Ultimaker/Ultimaker2/README.md

Ultimaker2
==========

In this repository you will find the documentation and source files for the Ultimaker2 3D printer. If you are missing a part or information of the Electronics feel free to file an issue on github.

Harma Woldhuis Ultimaker Research and Development
