Ultimaker/Ultimaker2/HeadAssembly.step

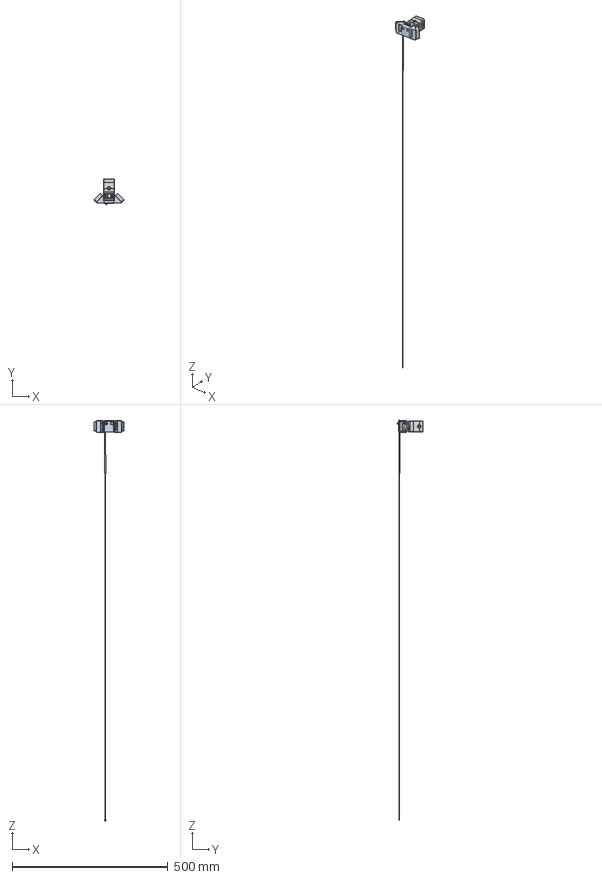
[picture p4: CAD file, 2014-04-07]
HeadAssembly.step
97.7 x 83.5 x 1284.8 mm
1320-B2P-B
1321-B2P-B
1322-B2P-C
1307-Z2P-B Hot End Holder Top
1308-Z2P-B Cooling Rib Hot End
1306-Z2P-B hot end holder bottom
1309-Z2P-B Hot End Isolator Coupler
1310-Z2P-A Hot end Isolator
1301-Z2P-D integrated nozzle 3mm
1268-Z1P-A
1329-B2P-C
1065-Z1P-A x 2
Fan Base 30x30 x 2
Fan Rotor 30x30 x 2
1330 Fan Base 25x25
1330 Fan Rotor 25x25
