Ultimaker/Ultimaker2/1011_Y-linear_shaft_(x2)/1011-A2P-A.STEP

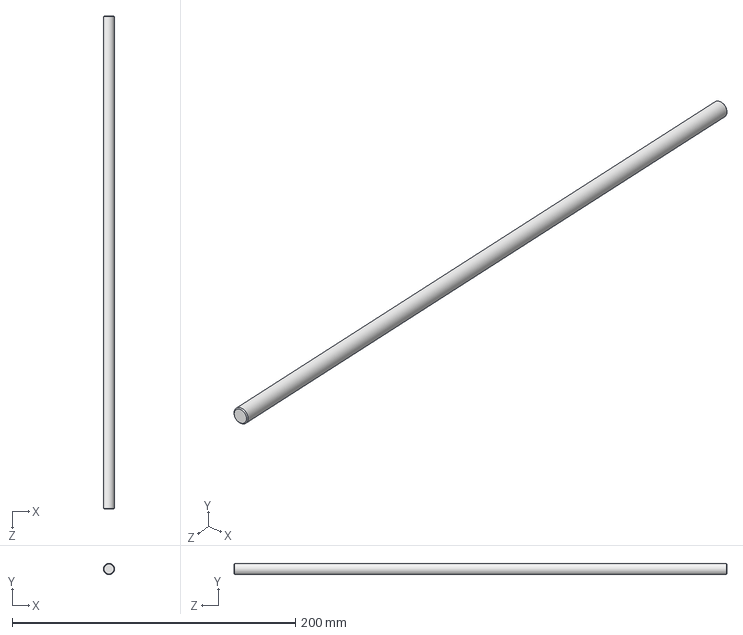
[picture p5: CAD file, 2014-03-27]
1011_Y-linear_shaft_(x2)/1011-A2P-A.STEP
7.99 x 8.00 x 348.0 mm
