Ultimaker/Ultimaker2/1012_X-linear_shaft_(x2)/1012-A2P-A.STEP

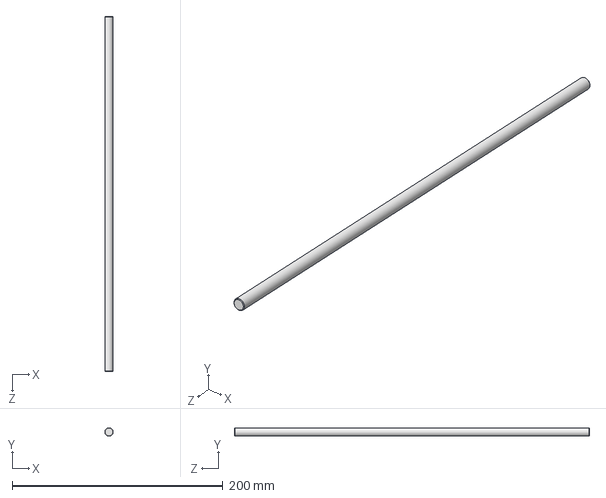
[picture p6: CAD file, 2014-03-27]
1012_X-linear_shaft_(x2)/1012-A2P-A.STEP
7.99 x 8.00 x 337.0 mm
