Ultimaker/Ultimaker2/1021_Ball_Bearing_688-2RS_(x1)/1021-Z1P-A.STEP

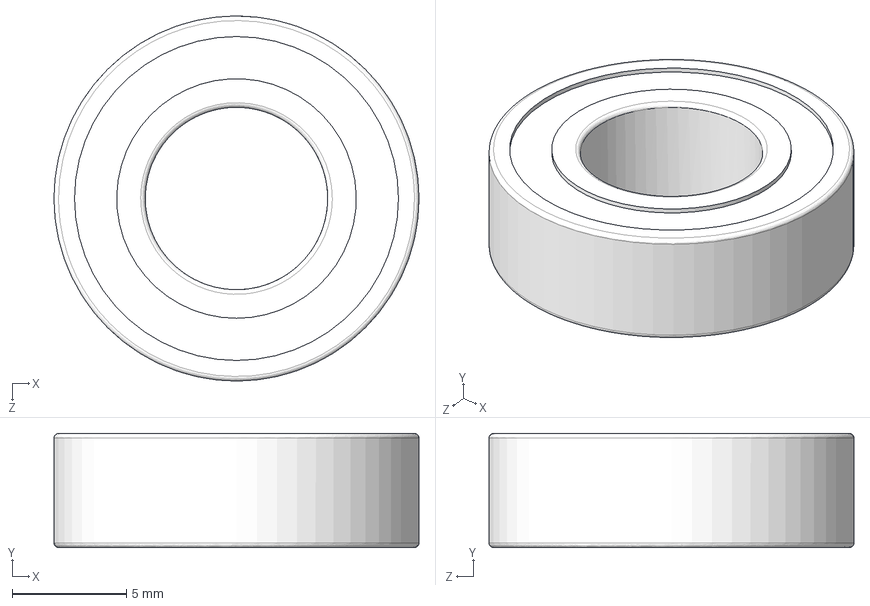
[picture p7: CAD file, 2014-03-27]
1021_Ball_Bearing_688-2RS_(x1)/1021-Z1P-A.STEP
16.0 x 5.00 x 16.0 mm
