Ultimaker/Ultimaker2/1024_Limit_Switch,_Black_Short_Wire_(x1)/1024-Z1P-A.STEP

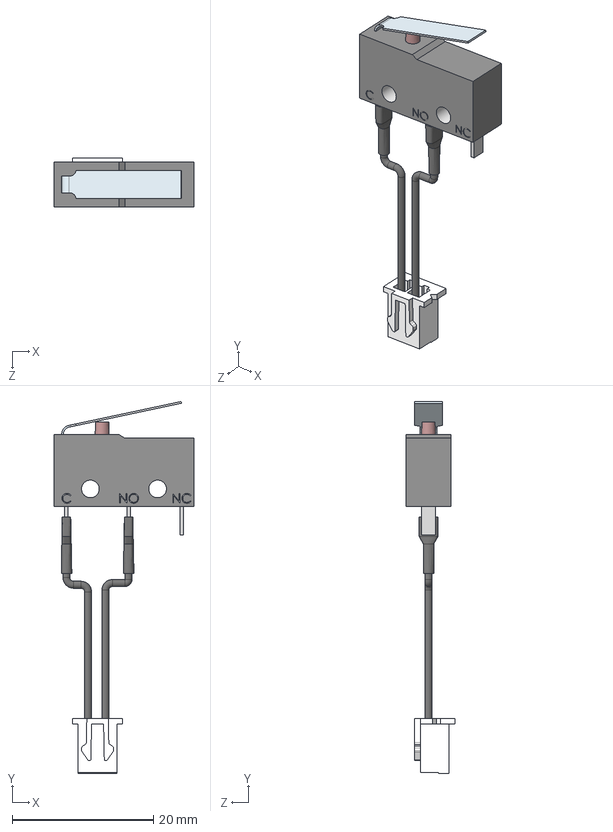
[picture p8: CAD file, 2014-03-27]
1024_Limit_Switch,_Black_Short_Wire_(x1)/1024-Z1P-A.STEP
19.8 x 52.7 x 6.90 mm
