Ultimaker/Ultimaker2/1056_Sintered_Bushing_(x4)/1056-A2P-A.STEP

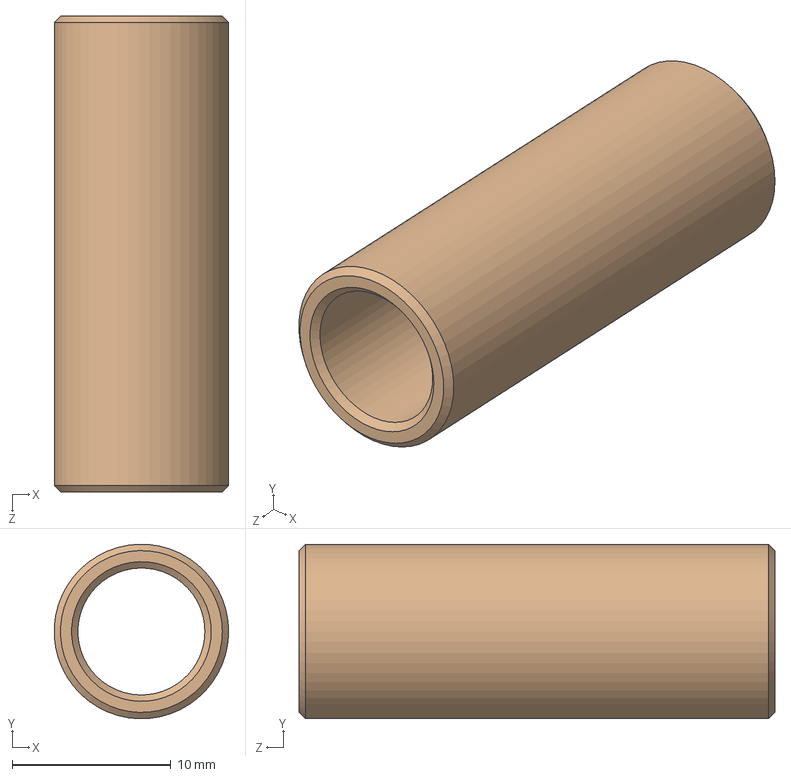
[picture p9: CAD file, 2014-03-27]
1056_Sintered_Bushing_(x4)/1056-A2P-A.STEP
11.0 x 11.0 x 30.0 mm
