Ultimaker/Ultimaker2/1065_Linear_Bearing_LM6LUU_(x2)/1065-Z1P-A.STEP

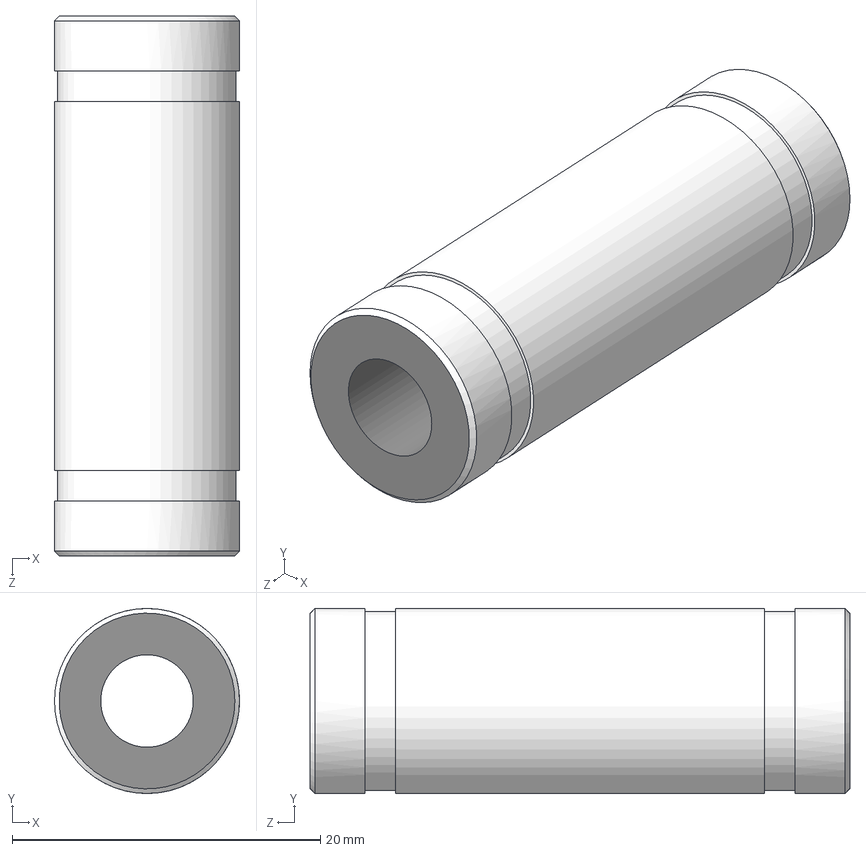
[picture p10: CAD file, 2014-03-27]
1065_Linear_Bearing_LM6LUU_(x2)/1065-Z1P-A.STEP
12.0 x 12.0 x 35.0 mm
