Ultimaker/Ultimaker2/1069_Tube_Coupling_Collet_(x2)/1069-Z1P-A.STEP

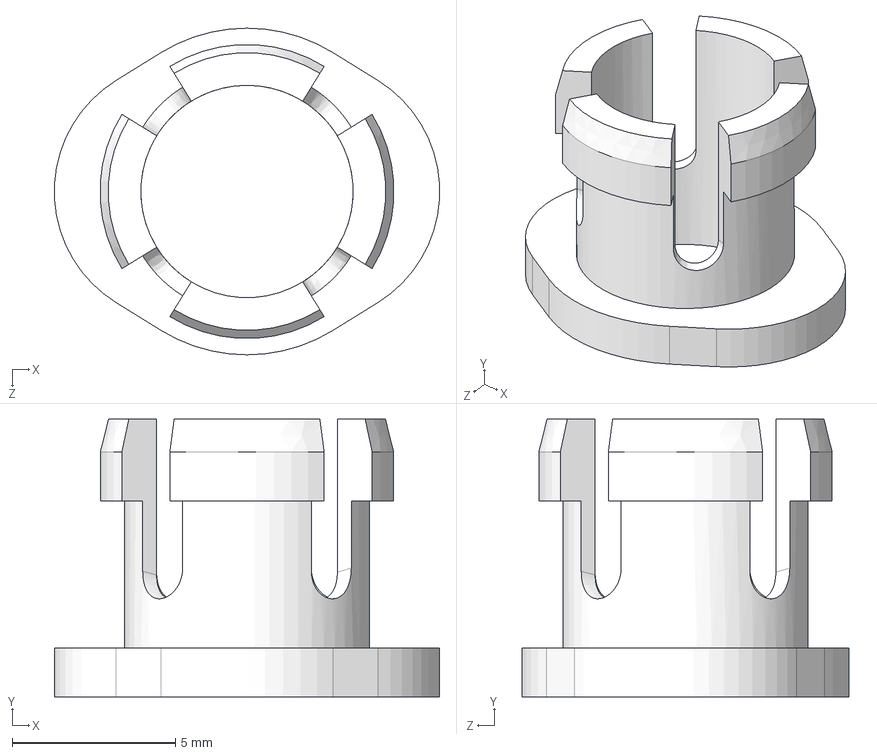
[picture p11: CAD file, 2014-03-27]
1069_Tube_Coupling_Collet_(x2)/1069-Z1P-A.STEP
11.8 x 8.50 x 10.00 mm
