Ultimaker/Ultimaker2/1071_Clamp_Clip_(x2)/1071-Z1P-A.STEP

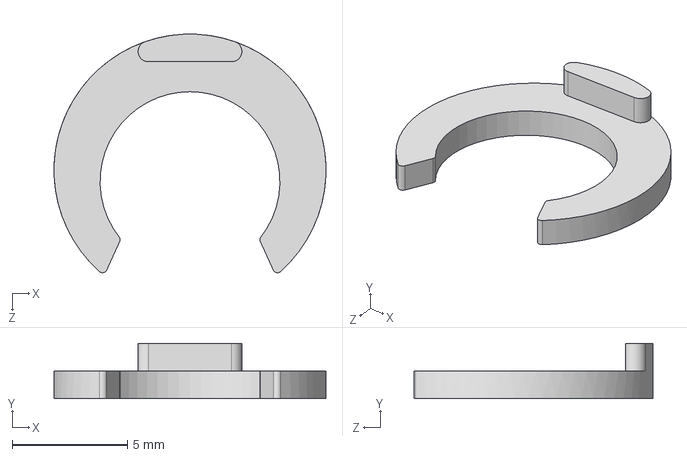
[picture p12: CAD file, 2014-03-27]
1071_Clamp_Clip_(x2)/1071-Z1P-A.STEP
11.8 x 2.40 x 10.3 mm
