Ultimaker/Ultimaker2/1144_USB_Cable_(x1)/1144-Z1P-A.STEP

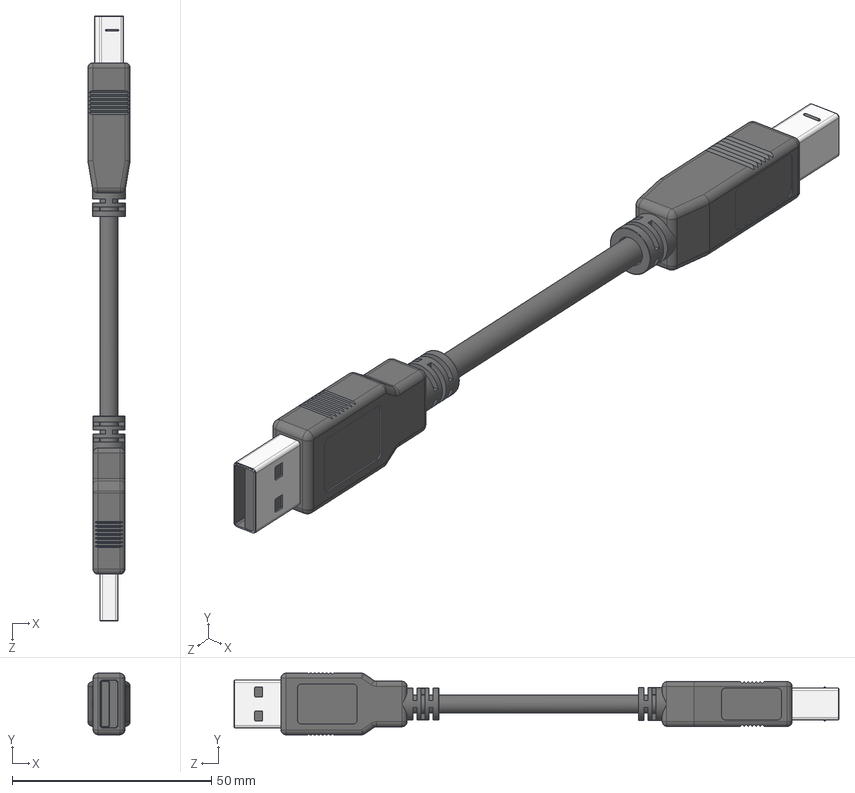
[picture p13: CAD file, 2014-03-27]
1144_USB_Cable_(x1)/1144-Z1P-A.STEP
10.6 x 15.5 x 151.8 mm
