Ultimaker/Ultimaker2/1152_Table_Spring_D2150_(x3)/1152-B2P-B.step

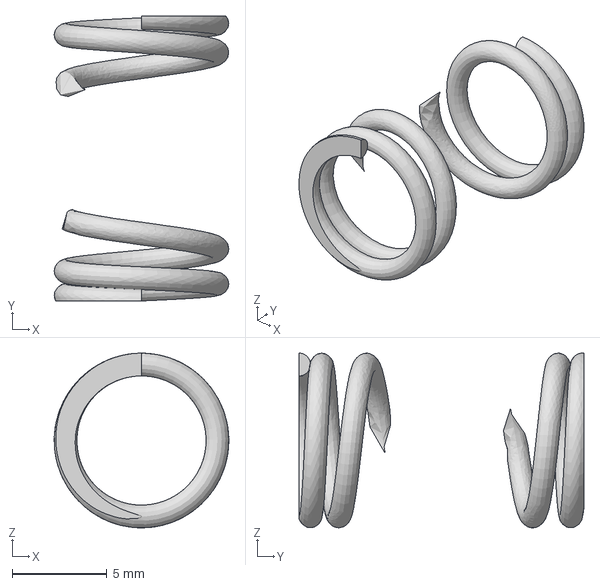
[picture p14: CAD file, 2014-03-27]
1152_Table_Spring_D2150_(x3)/1152-B2P-B.step
9.20 x 15.0 x 9.20 mm
