Ultimaker/Ultimaker2/1153_Print_Table_Base_Plate_(x1)/1153-B2P-B.step

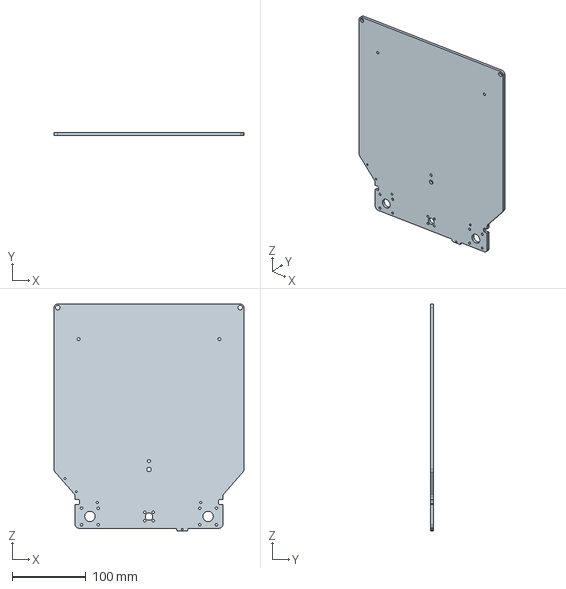
[picture p15: CAD file, 2014-03-27]
1153_Print_Table_Base_Plate_(x1)/1153-B2P-B.step
257.0 x 4.00 x 307.2 mm
