Ultimaker/Ultimaker2/1154_Print_Table_Glass_(x1)/1154-B2P-A.step

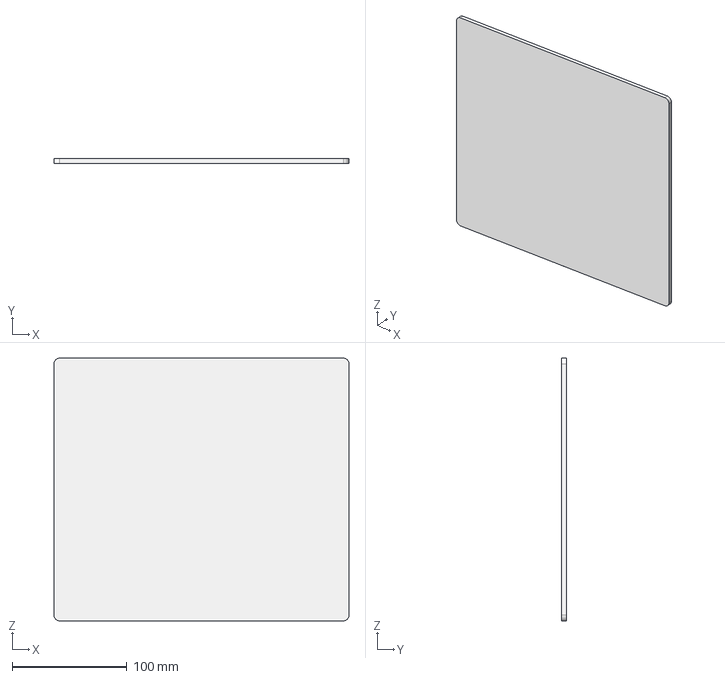
[picture p16: CAD file, 2014-03-27]
1154_Print_Table_Glass_(x1)/1154-B2P-A.step
257.0 x 4.00 x 229.0 mm
