Ultimaker/Ultimaker2/1155_Print_Table_Heated_Bed_(x1)/1155-B2P-B.step

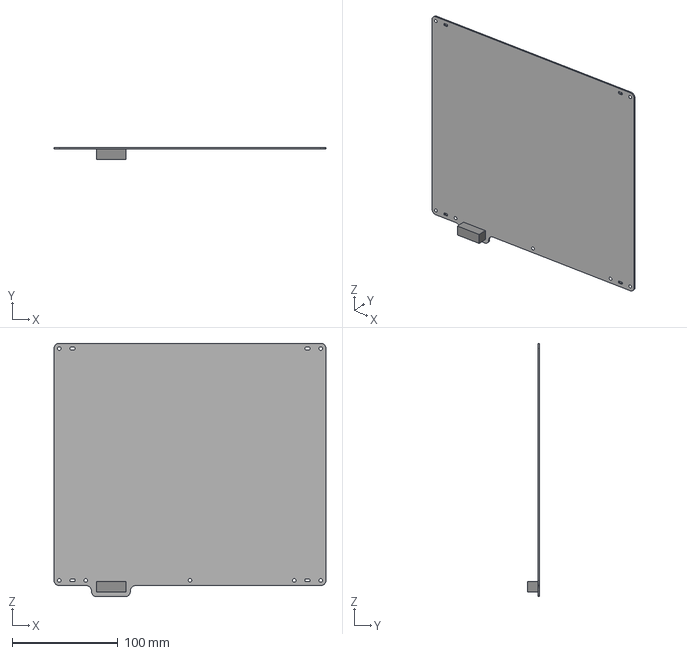
[picture p17: CAD file, 2014-03-27]
1155_Print_Table_Heated_Bed_(x1)/1155-B2P-B.step
257.0 x 11.5 x 239.5 mm
