Ultimaker/Ultimaker2/1156_Z-shaft_Cap_Bottom_(x2)/1156-B2P-A.step

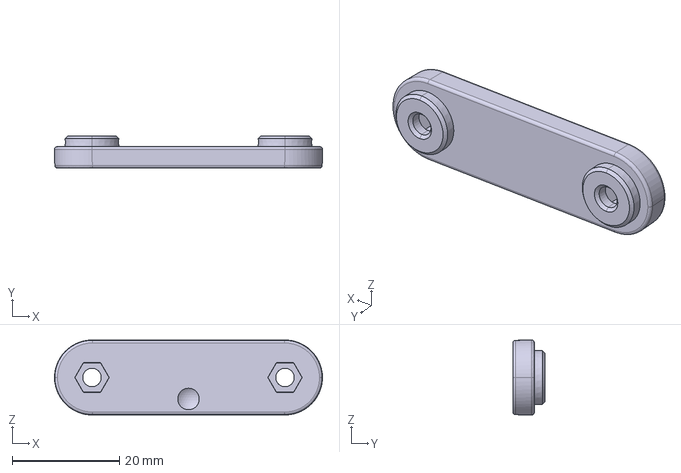
[picture p18: CAD file, 2014-03-27]
1156_Z-shaft_Cap_Bottom_(x2)/1156-B2P-A.step
50.0 x 6.00 x 14.0 mm
