Ultimaker/Ultimaker2/1157_Print_Table_Back_Cover_(x1)/1157-B2P-B.step

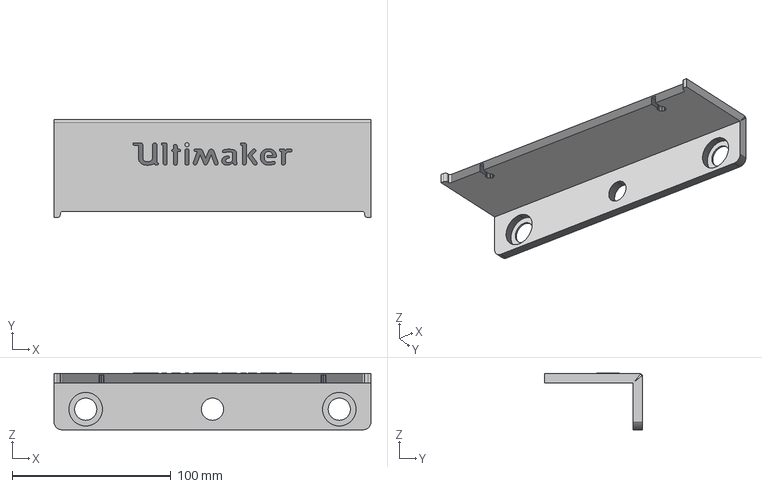
[picture p19: CAD file, 2014-03-27]
1157_Print_Table_Back_Cover_(x1)/1157-B2P-B.step
200.0 x 62.0 x 35.7 mm
