Ultimaker/Ultimaker2/1158_Reel_Holder_(x1)/1158-B2P-A.step

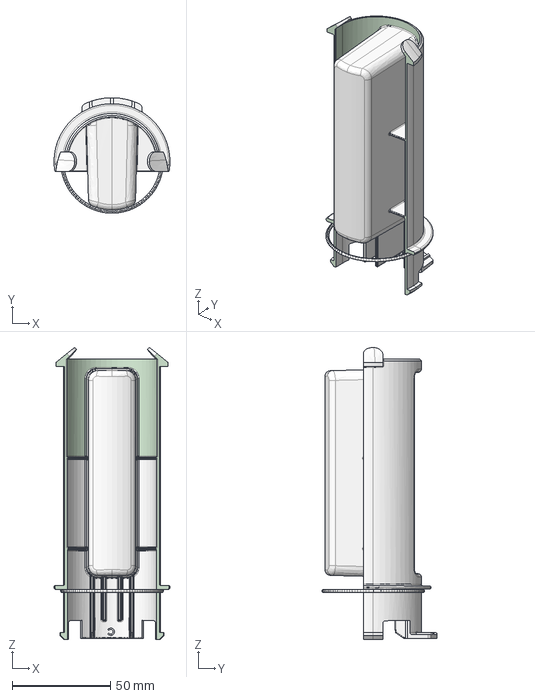
[picture p20: CAD file, 2014-03-27]
1158_Reel_Holder_(x1)/1158-B2P-A.step
59.0 x 58.8 x 148.7 mm
