Ultimaker/Ultimaker2/1159_Z-Motor_with_Trapezoidal_Lead_Srew_(x1)/1159-B2P-D.step

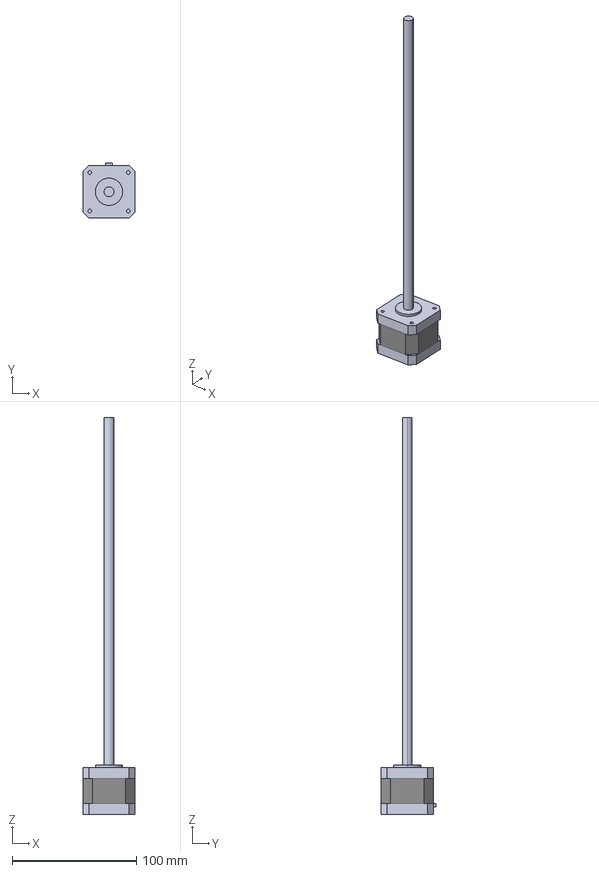
[picture p21: CAD file, 2014-03-27]
1159_Z-Motor_with_Trapezoidal_Lead_Srew_(x1)/1159-B2P-D.step
42.3 x 44.3 x 320.0 mm
