Ultimaker/Ultimaker2/1161_LED_Strip_Cold_white_(x1)/1161-B2P-D.step

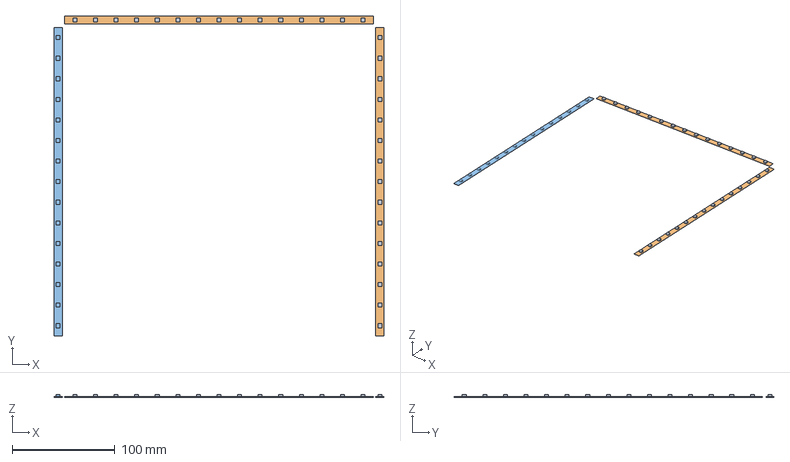
[picture p22: CAD file, 2014-03-27]
1161_LED_Strip_Cold_white_(x1)/1161-B2P-D.step
320.6 x 311.0 x 2.75 mm
