Ultimaker/Ultimaker2/1162_Limit_Switch,_Blue_Wire_(x1)/1162-Z1P-B.step

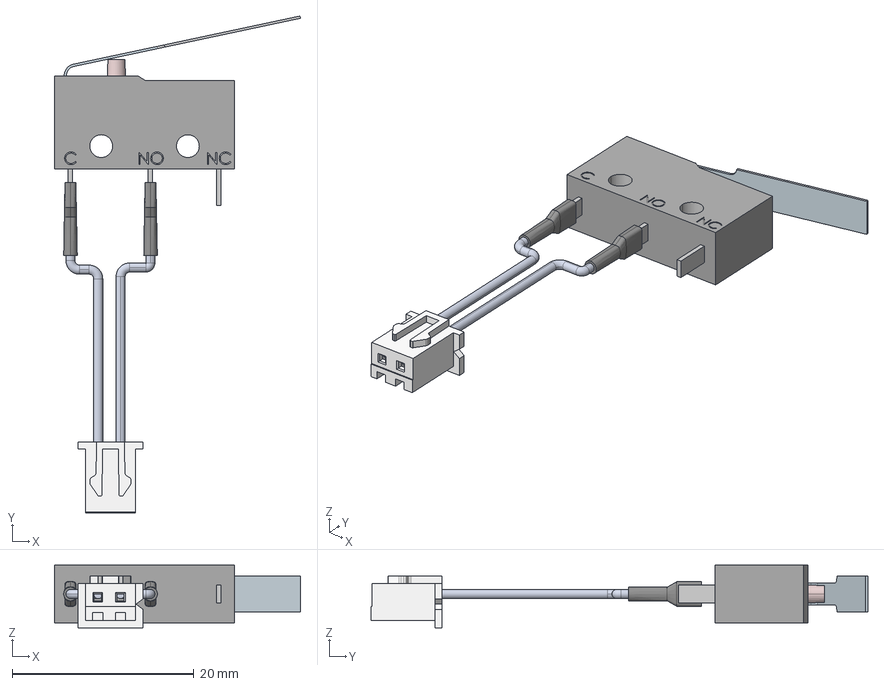
[picture p23: CAD file, 2014-03-27]
1162_Limit_Switch,_Blue_Wire_(x1)/1162-Z1P-B.step
27.1 x 54.6 x 6.90 mm
