Ultimaker/Ultimaker2/1165_Timing_Pulley_5mm_Shaft_GT2_(x2)/1165-B2P-A.step

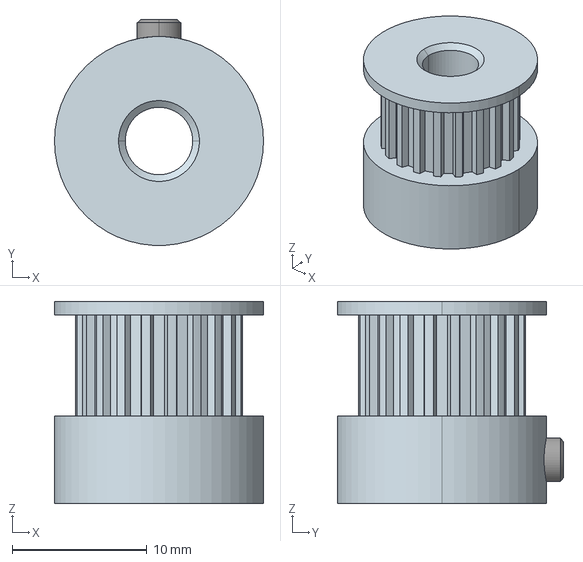
[picture p24: CAD file, 2014-03-27]
1165_Timing_Pulley_5mm_Shaft_GT2_(x2)/1165-B2P-A.step
15.5 x 16.7 x 15.0 mm
