Ultimaker/Ultimaker2/1166_Timing_Pulley_8mm_Shaft_GT2_(x8)/1166-B2P-B.step

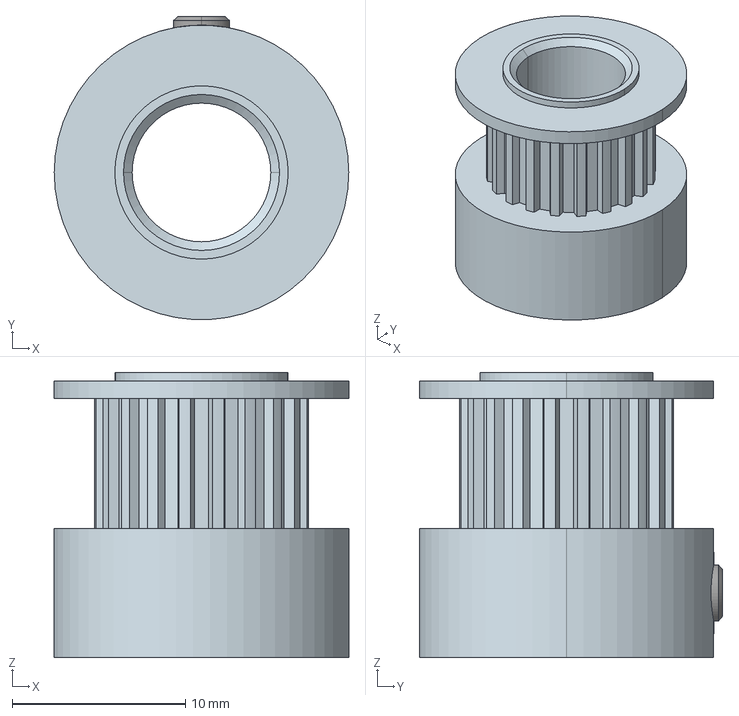
[picture p25: CAD file, 2014-03-27]
1166_Timing_Pulley_8mm_Shaft_GT2_(x8)/1166-B2P-B.step
17.0 x 17.5 x 16.4 mm
