Ultimaker/Ultimaker2/1167_Timing_Pulley_Double_8mm_Shaft_GT2_(x1)/1167-B2P-A.step

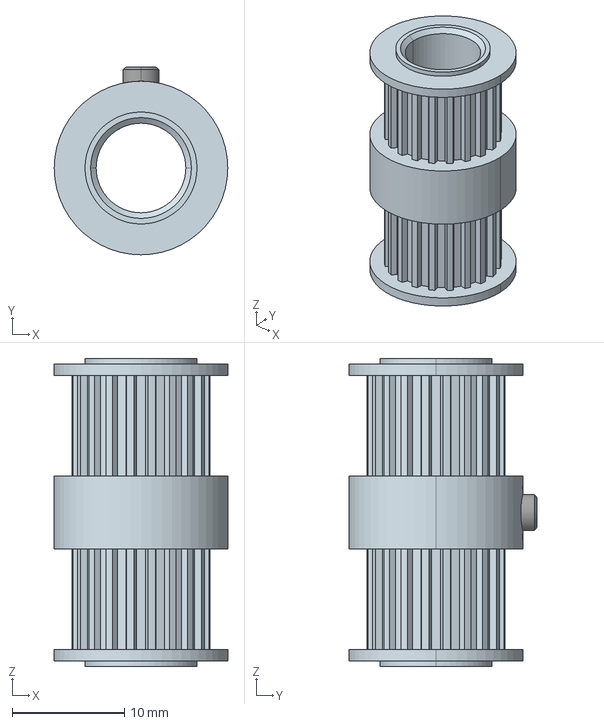
[picture p26: CAD file, 2014-03-27]
1167_Timing_Pulley_Double_8mm_Shaft_GT2_(x1)/1167-B2P-A.step
15.5 x 16.8 x 27.5 mm
