Ultimaker/Ultimaker2/1168_Sliding_Block_Spring_(x4)/1168-B2P-B.step

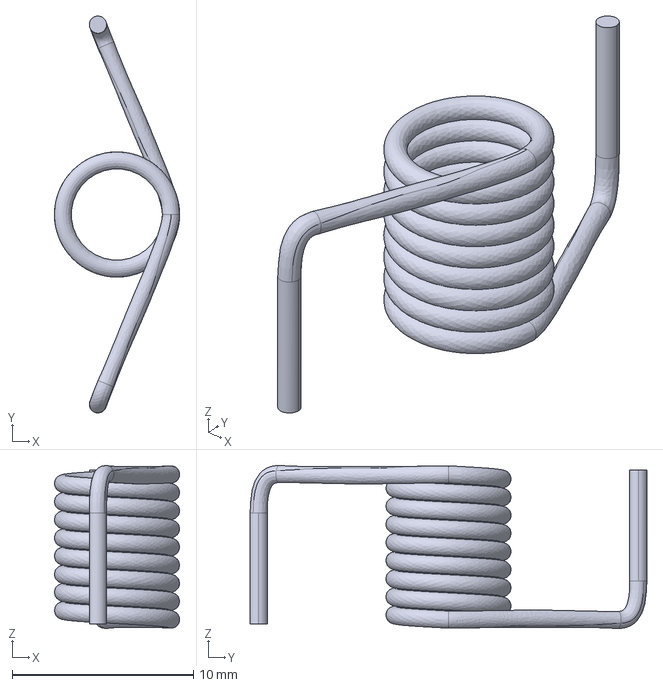
[picture p27: CAD file, 2014-03-27]
1168_Sliding_Block_Spring_(x4)/1168-B2P-B.step
6.91 x 21.9 x 8.98 mm
