Ultimaker/Ultimaker2/1169_Z-linear_Shaft_(x2)/1169-B2P-B.step

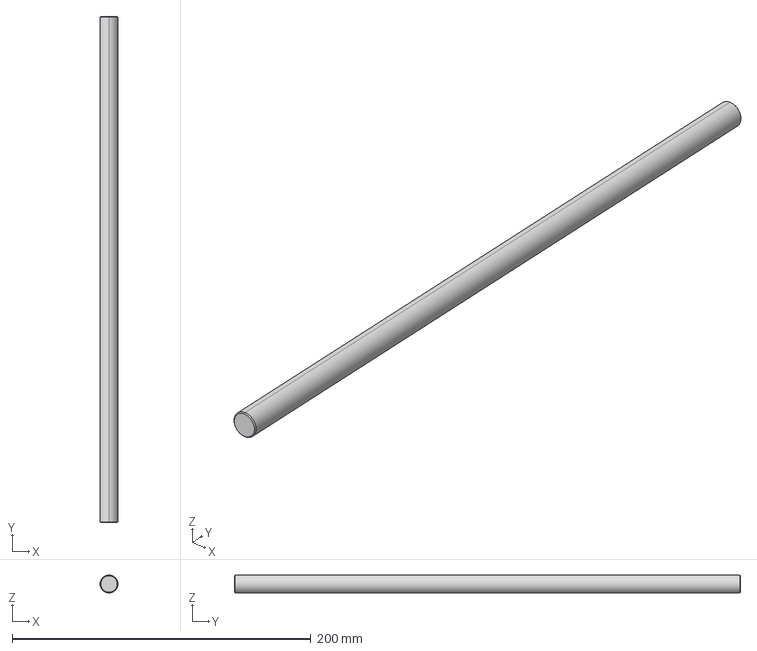
[picture p28: CAD file, 2014-03-27]
1169_Z-linear_Shaft_(x2)/1169-B2P-B.step
12.0 x 339.0 x 12.0 mm
