Ultimaker/Ultimaker2/1170_Square_Flanged_Linear_Bearing_LMK12LUU_(x2)/1170-B2P-B.step

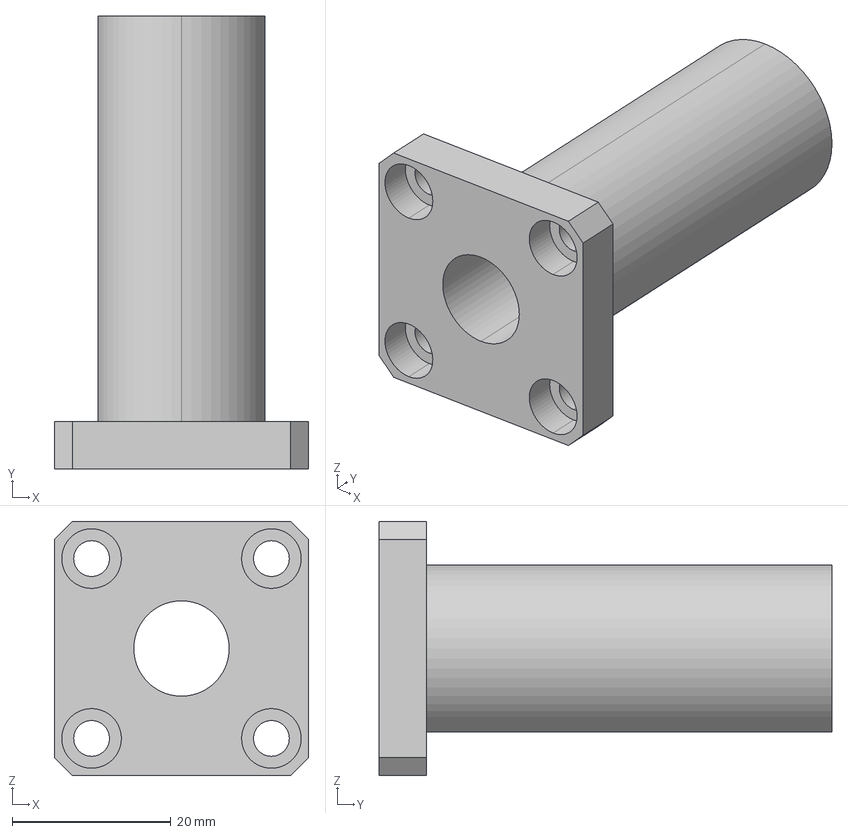
[picture p29: CAD file, 2014-03-27]
1170_Square_Flanged_Linear_Bearing_LMK12LUU_(x2)/1170-B2P-B.step
32.0 x 57.0 x 32.0 mm
