Ultimaker/Ultimaker2/1176_Spacer_8.2x10x5_(x2)/1176-B1P-A.step

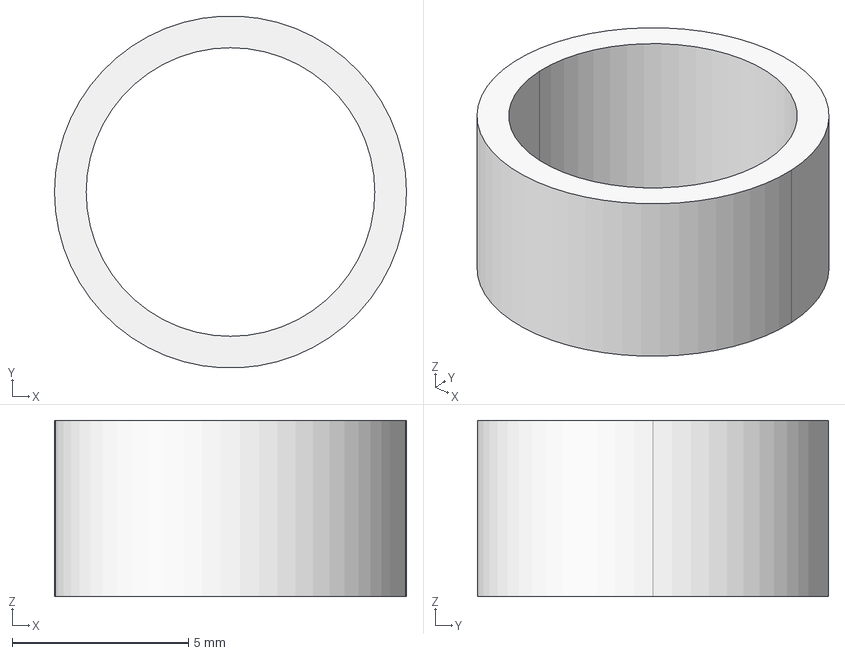
[picture p30: CAD file, 2014-03-27]
1176_Spacer_8.2x10x5_(x2)/1176-B1P-A.step
10.0 x 9.99 x 5.00 mm
