Ultimaker/Ultimaker2/1177_Spacer_8.2x10x10_(x5)/1177-B1P-A.step

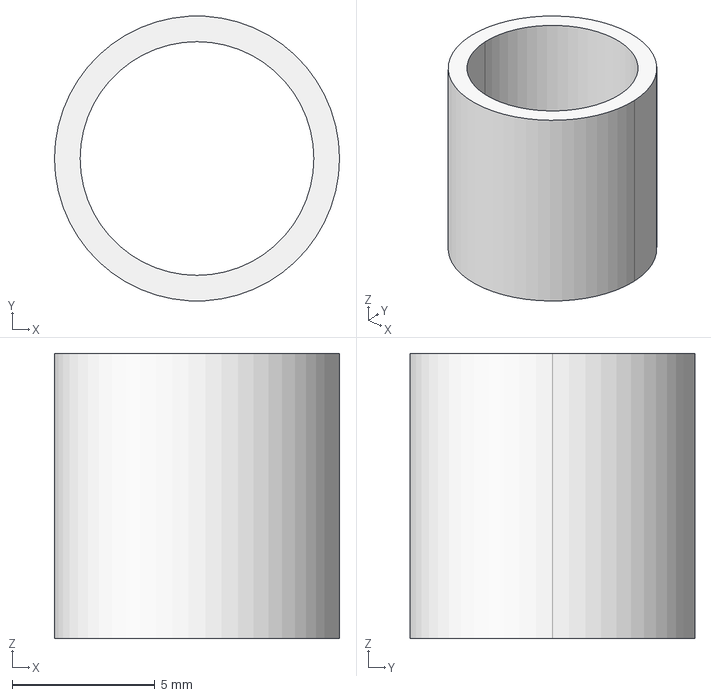
[picture p31: CAD file, 2014-03-27]
1177_Spacer_8.2x10x10_(x5)/1177-B1P-A.step
10.0 x 9.98 x 10.0 mm
