Ultimaker/Ultimaker2/1178_Spacer_8.2x10x25_(x1)/1178-B1P-A.step

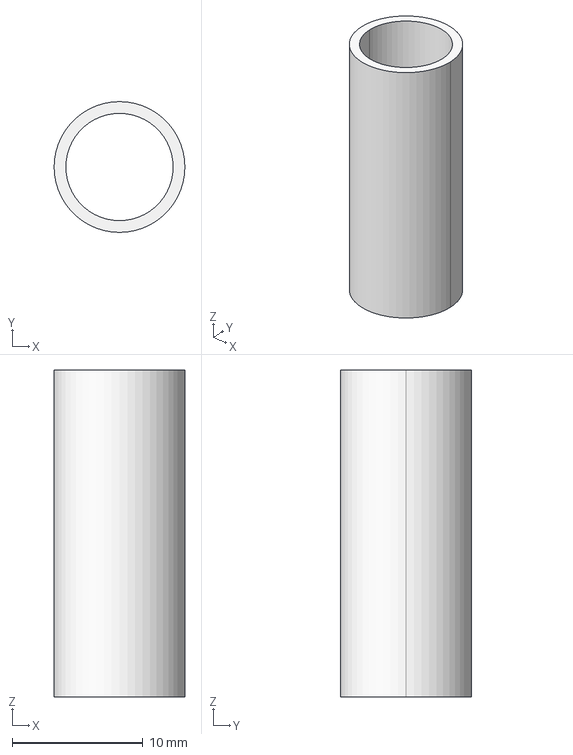
[picture p32: CAD file, 2014-03-27]
1178_Spacer_8.2x10x25_(x1)/1178-B1P-A.step
10.0 x 10.0 x 25.0 mm
