Ultimaker/Ultimaker2/1179_Feeder_Motor_(x1)/1179-B2P-A.step

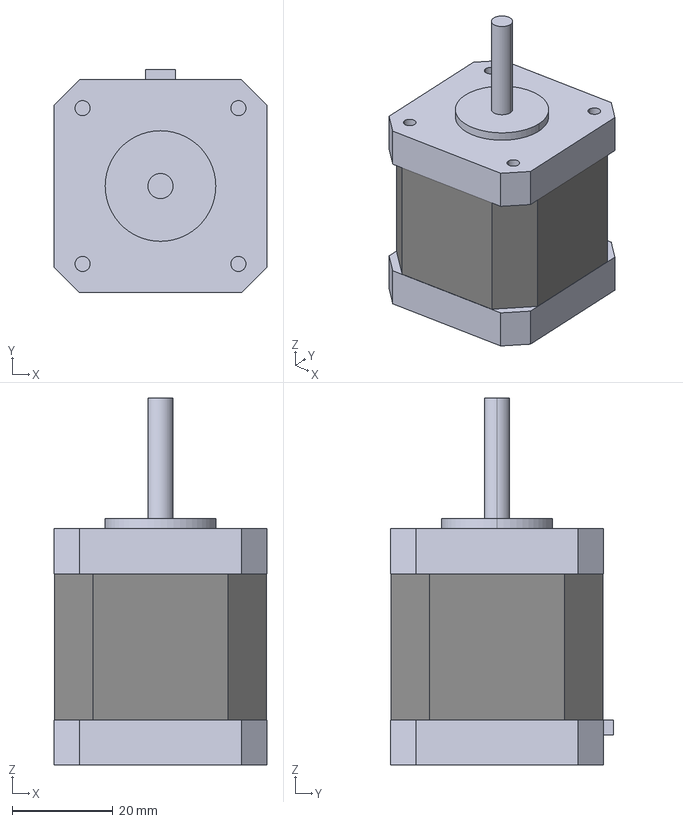
[picture p33: CAD file, 2014-03-27]
1179_Feeder_Motor_(x1)/1179-B2P-A.step
42.3 x 44.3 x 73.0 mm
