Ultimaker/Ultimaker2/1182_X,Y_Motor_(x2)/1182-B2P-A.step

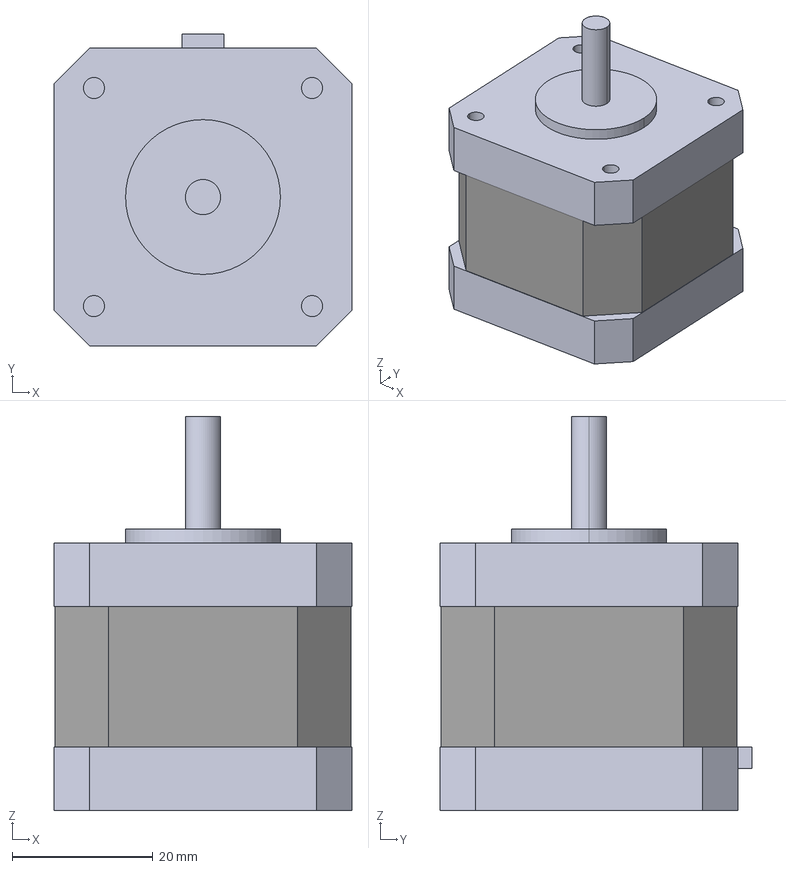
[picture p34: CAD file, 2014-03-27]
1182_X,Y_Motor_(x2)/1182-B2P-A.step
42.3 x 44.3 x 56.0 mm
