Ultimaker/Ultimaker2/1200_ISO_7380_M3x8_(x10)/1200-Z1P-A ISO 7380 M3x8.STEP

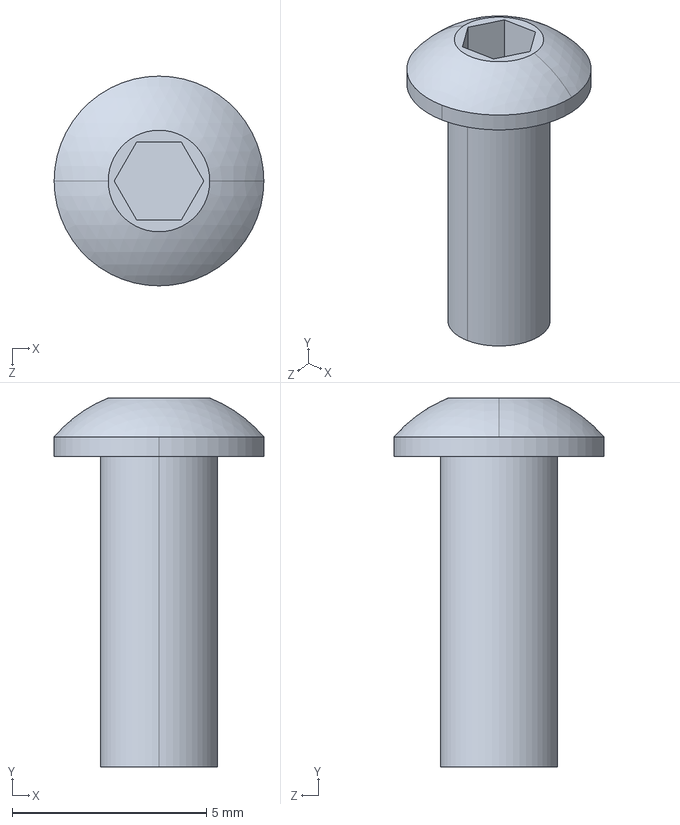
[picture p35: CAD file, 2014-03-27]
1200_ISO_7380_M3x8_(x10)/1200-Z1P-A ISO 7380 M3x8.STEP
5.40 x 9.50 x 5.40 mm
