Ultimaker/Ultimaker2/1202_ISO_7380_M3x10_(x15)/1202-Z1P-A.STEP

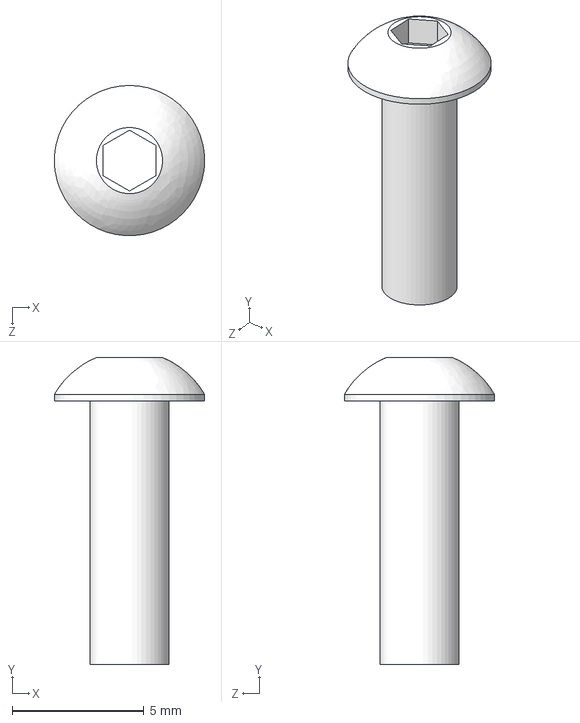
[picture p36: CAD file, 2014-03-27]
1202_ISO_7380_M3x10_(x15)/1202-Z1P-A.STEP
5.70 x 11.7 x 5.69 mm
