Ultimaker/Ultimaker2/1203_ISO_7380_M3x12_(x10)/1203-Z1P-A.STEP

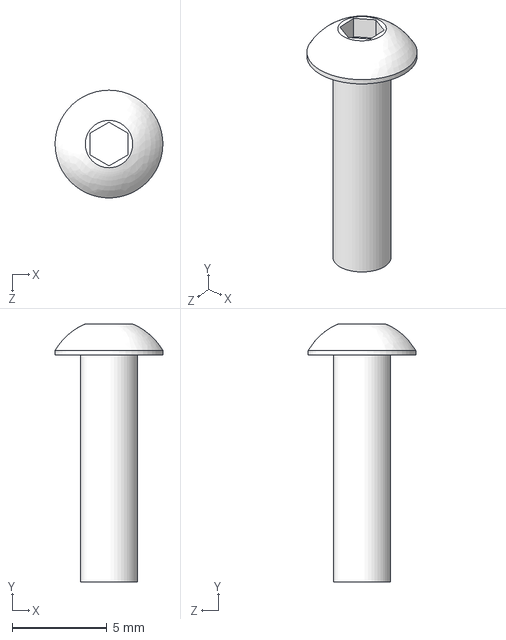
[picture p37: CAD file, 2014-03-27]
1203_ISO_7380_M3x12_(x10)/1203-Z1P-A.STEP
5.70 x 13.7 x 5.69 mm
