Ultimaker/Ultimaker2/1204_ISO_7380_M3x16_(x41)/1204-Z1P-A.STEP

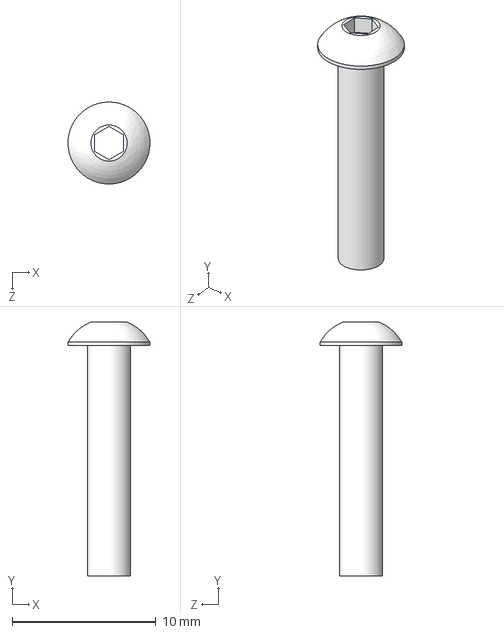
[picture p38: CAD file, 2014-03-27]
1204_ISO_7380_M3x16_(x41)/1204-Z1P-A.STEP
5.70 x 17.7 x 5.69 mm
