Ultimaker/Ultimaker2/1206_ISO_7380_M3x20_(x5)/1206-Z1P-A.STEP

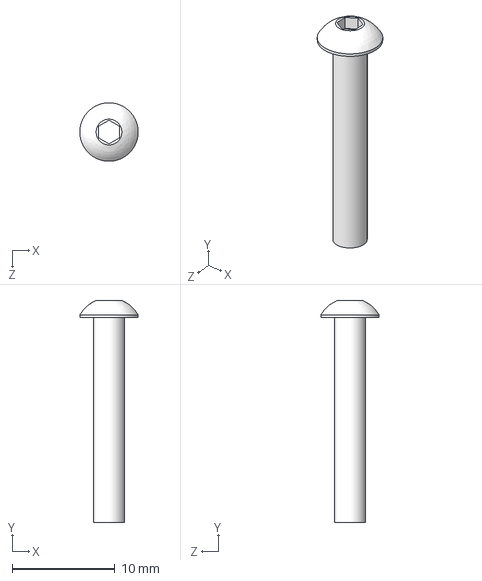
[picture p39: CAD file, 2014-03-27]
1206_ISO_7380_M3x20_(x5)/1206-Z1P-A.STEP
5.70 x 21.7 x 5.69 mm
