Ultimaker/Ultimaker2/1207_ISO_7380_M3x25_(x12)/1207-Z1P-A.STEP

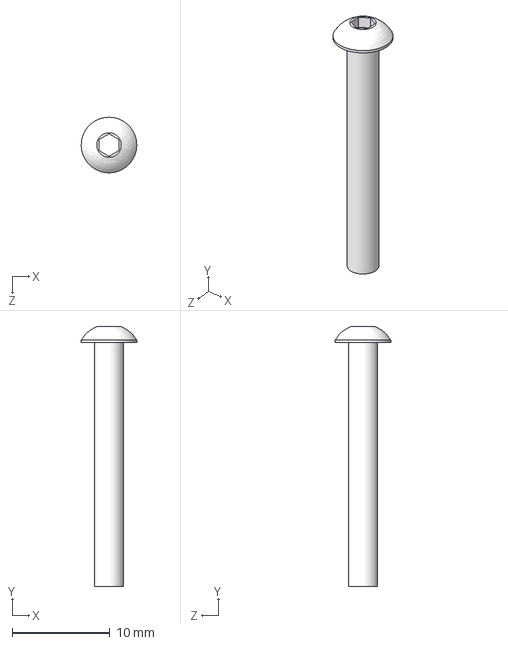
[picture p40: CAD file, 2014-03-27]
1207_ISO_7380_M3x25_(x12)/1207-Z1P-A.STEP
5.70 x 26.6 x 5.69 mm
