Ultimaker/Ultimaker2/1208_ISO_7380_M3x30_(x4)/1208-Z1P-A.STEP

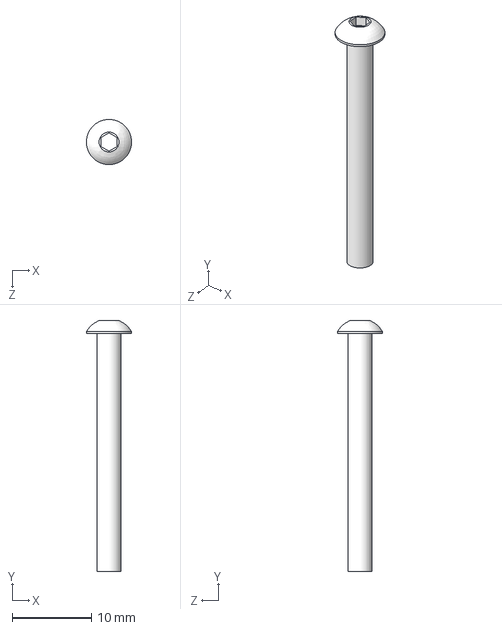
[picture p41: CAD file, 2014-03-27]
1208_ISO_7380_M3x30_(x4)/1208-Z1P-A.STEP
5.70 x 31.7 x 5.69 mm
