Ultimaker/Ultimaker2/1215_ISO_10642_M3x8_A2_(x4)/1215-Z1P-A.step

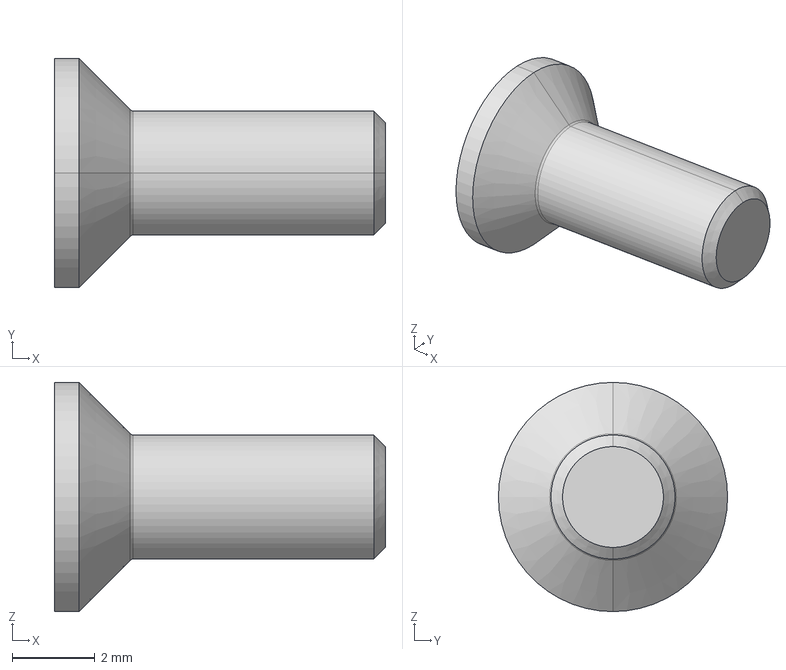
[picture p42: CAD file, 2014-03-27]
1215_ISO_10642_M3x8_A2_(x4)/1215-Z1P-A.step
8.00 x 5.54 x 5.54 mm
