Ultimaker/Ultimaker2/1216_ISO_10642_M3x20_A2_(x3)/1216-Z1P-A.step

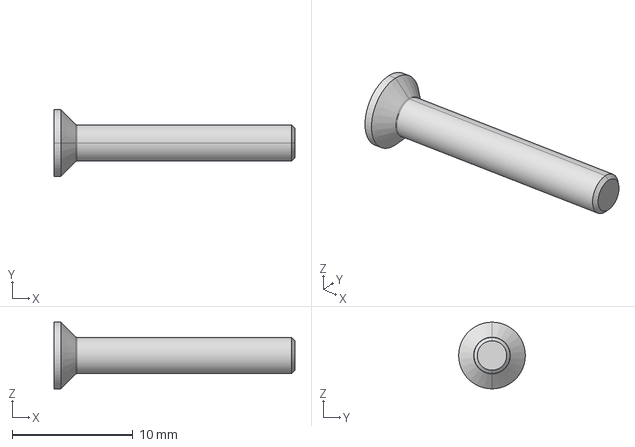
[picture p43: CAD file, 2014-03-27]
1216_ISO_10642_M3x20_A2_(x3)/1216-Z1P-A.step
20.0 x 5.54 x 5.54 mm
