Ultimaker/Ultimaker2/1217_ISO_10642_M4x10_A2_(x8)/1217-Z1P-A.step

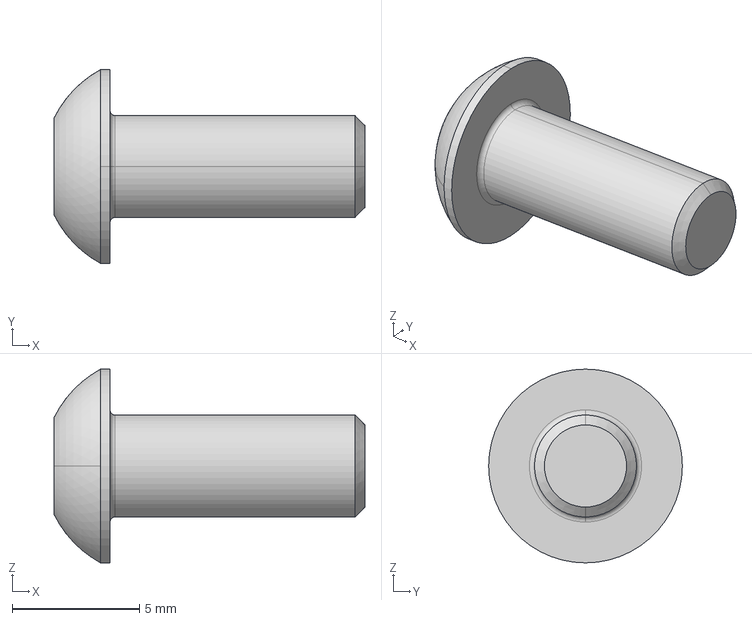
[picture p44: CAD file, 2014-03-27]
1217_ISO_10642_M4x10_A2_(x8)/1217-Z1P-A.step
12.2 x 7.60 x 7.60 mm
