Ultimaker/Ultimaker2/1220_Ball_Bearing_F688-2RS_(x8)/1220-Z1P-A.step

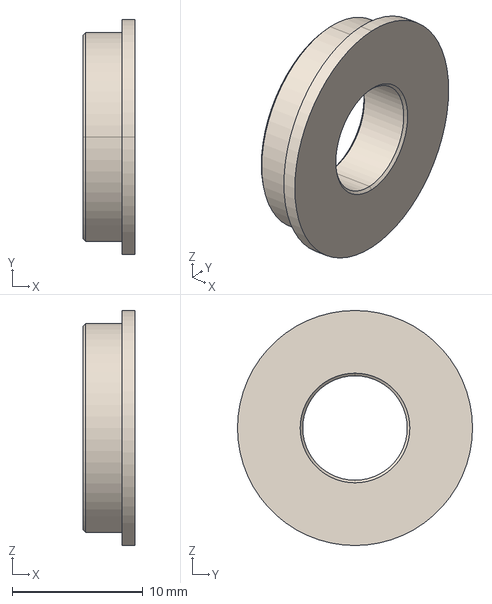
[picture p45: CAD file, 2014-03-27]
1220_Ball_Bearing_F688-2RS_(x8)/1220-Z1P-A.step
4.00 x 18.0 x 18.0 mm
