Ultimaker/Ultimaker2/1226_grease_(x1)/1226-Z1P-A.STEP

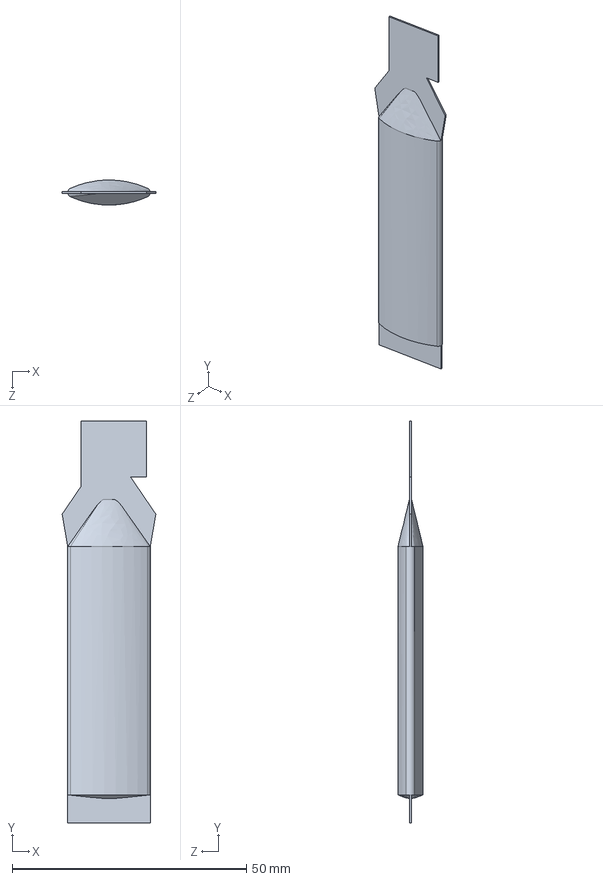
[picture p46: CAD file, 2014-03-27]
1226_grease_(x1)/1226-Z1P-A.STEP
20.0 x 85.8 x 5.34 mm
