Ultimaker/Ultimaker2/1230_Front_Panel_(x1)/1230-B2P-B.STEP

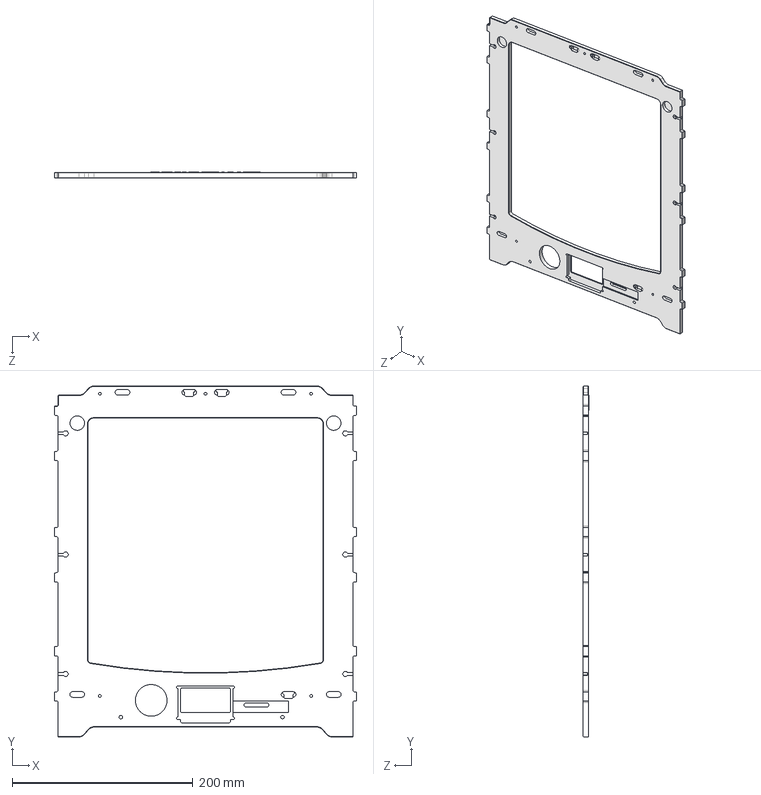
[picture p47: CAD file, 2014-03-27]
1230_Front_Panel_(x1)/1230-B2P-B.STEP
334.2 x 388.0 x 6.20 mm
