Ultimaker/Ultimaker2/1231_Back_Panel_(x1)/1231-B2P-B.STEP

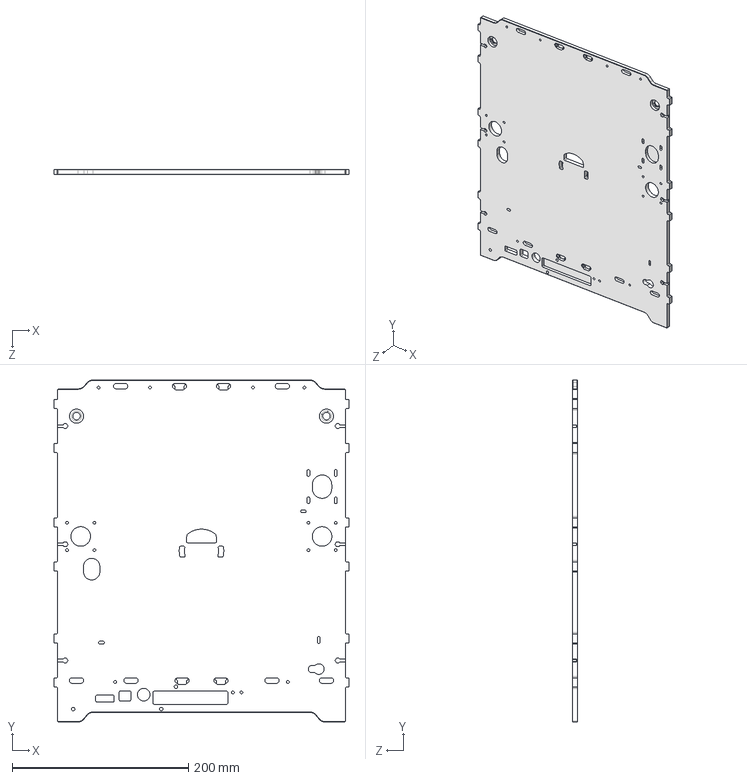
[picture p48: CAD file, 2014-03-27]
1231_Back_Panel_(x1)/1231-B2P-B.STEP
334.2 x 388.0 x 6.00 mm
