Ultimaker/Ultimaker2/1232_Left_Panel_(x1)/1232-B2P-B.STEP

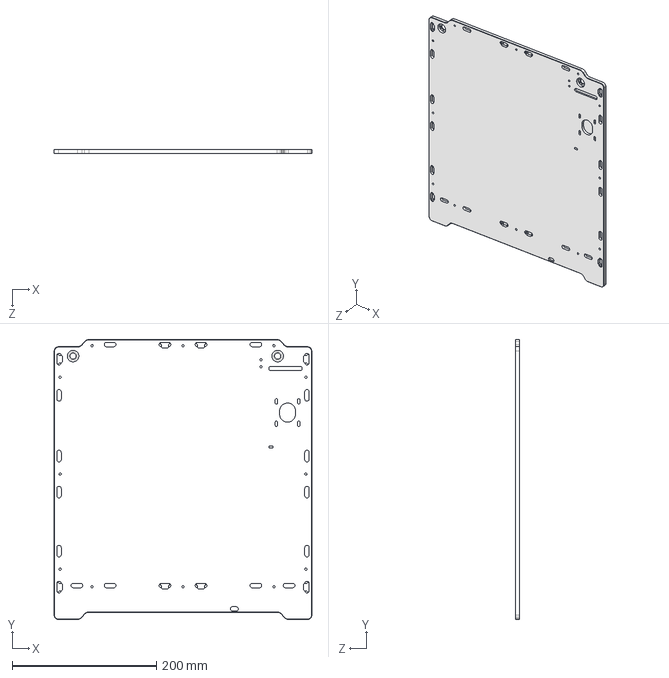
[picture p49: CAD file, 2014-03-27]
1232_Left_Panel_(x1)/1232-B2P-B.STEP
357.0 x 388.0 x 6.00 mm
