Ultimaker/Ultimaker2/1234_Bottom_Panel_(x1)/1234-B2P-D.STEP

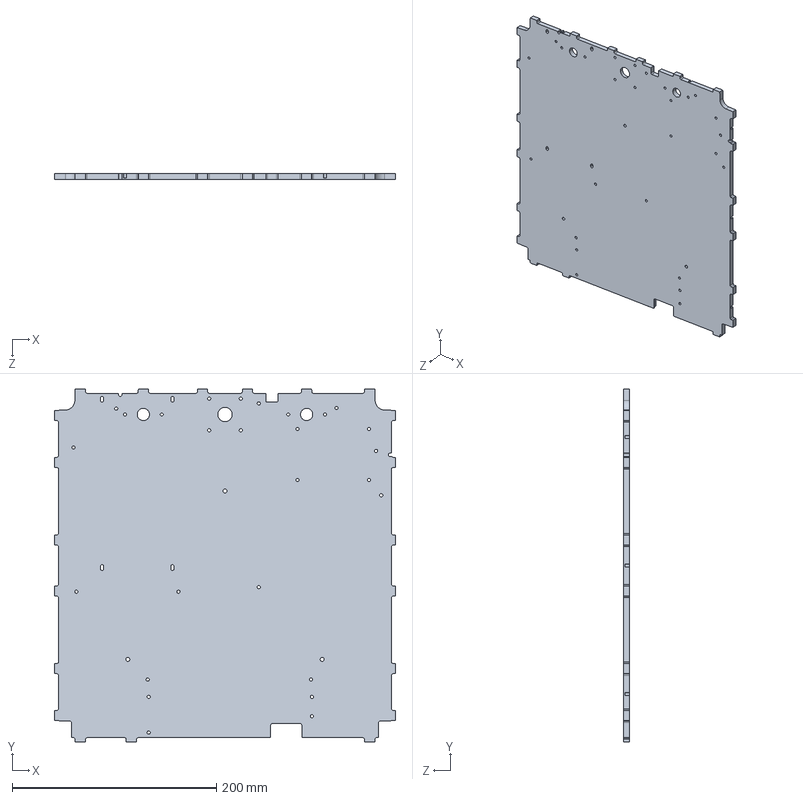
[picture p50: CAD file, 2014-03-27]
1234_Bottom_Panel_(x1)/1234-B2P-D.STEP
334.2 x 345.6 x 6.00 mm
