Ultimaker/Ultimaker2/1235_Top_Panel_(x1)/1235-B2P-B.STEP

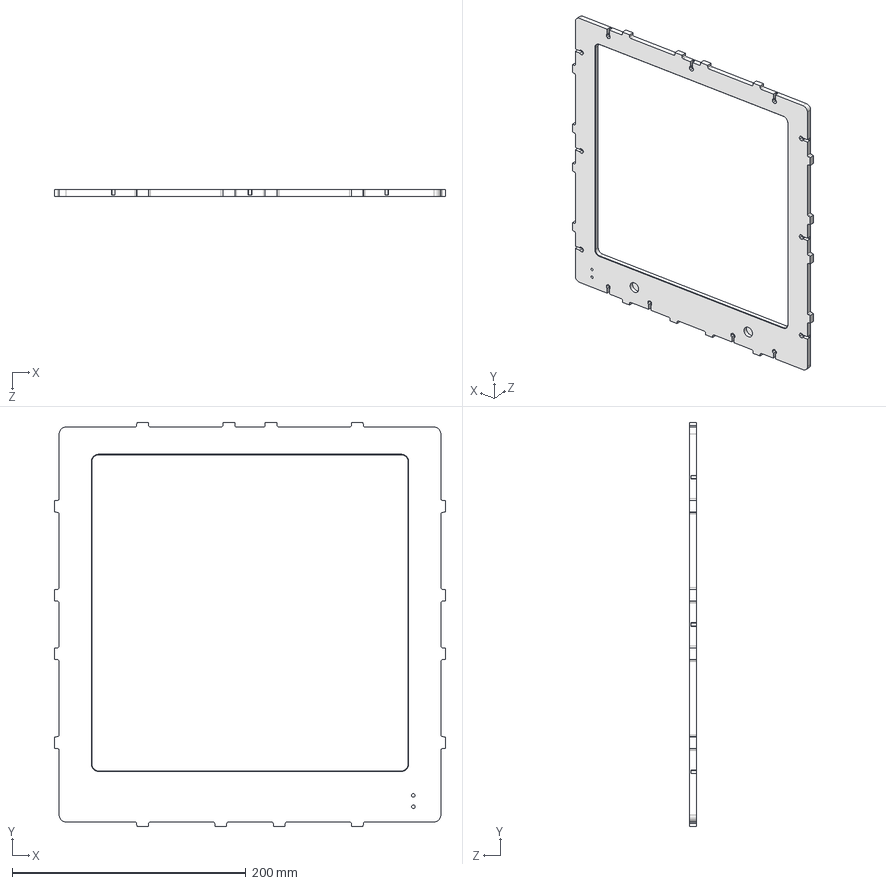
[picture p51: CAD file, 2014-03-27]
1235_Top_Panel_(x1)/1235-B2P-B.STEP
334.2 x 345.6 x 6.00 mm
