Ultimaker/Ultimaker2/1240_Main_Board_Electronics_Cover_(x1)/1240-B2P-B.STEP

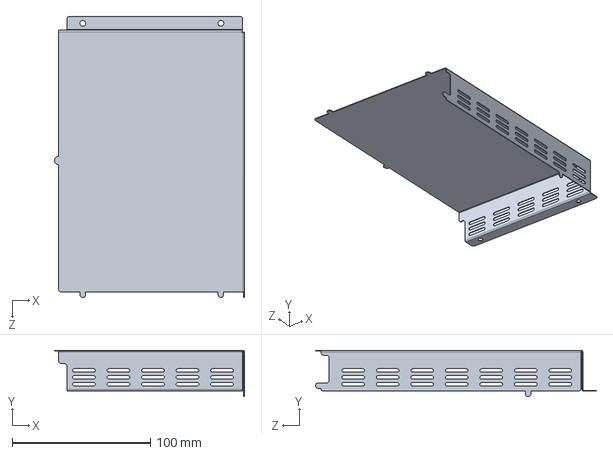
[picture p52: CAD file, 2014-03-27]
1240_Main_Board_Electronics_Cover_(x1)/1240-B2P-B.STEP
137.6 x 33.6 x 203.6 mm
