Ultimaker/Ultimaker2/1241_Motor_Spacer_(x2)/1241-B2P-B.STEP

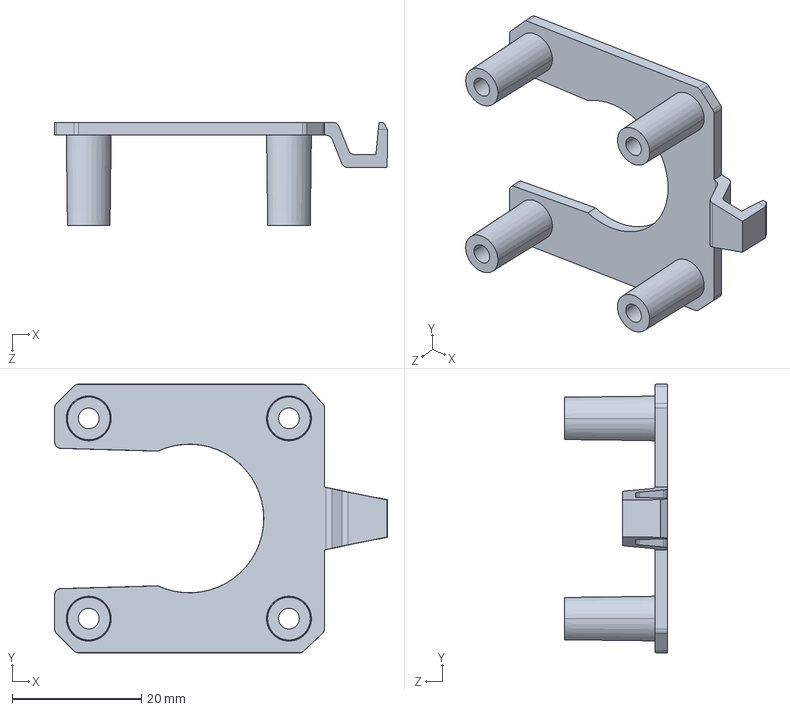
[picture p53: CAD file, 2014-03-27]
1241_Motor_Spacer_(x2)/1241-B2P-B.STEP
51.6 x 41.6 x 16.0 mm
