Ultimaker/Ultimaker2/1243_Heated_Bed_Cable_Clip_(x1)/1243-B2P-B.STEP

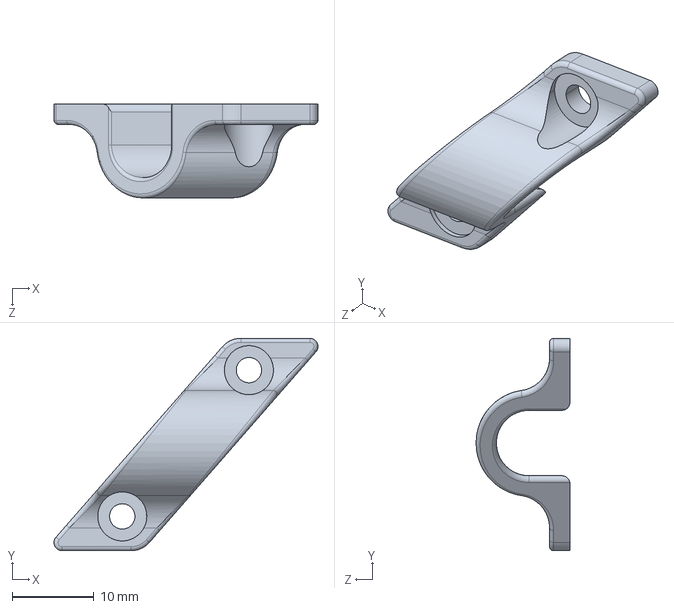
[picture p54: CAD file, 2014-03-27]
1243_Heated_Bed_Cable_Clip_(x1)/1243-B2P-B.STEP
32.3 x 26.0 x 11.5 mm
