Ultimaker/Ultimaker2/1244_Knob_Front_(x1)/1244-B2P-A.step

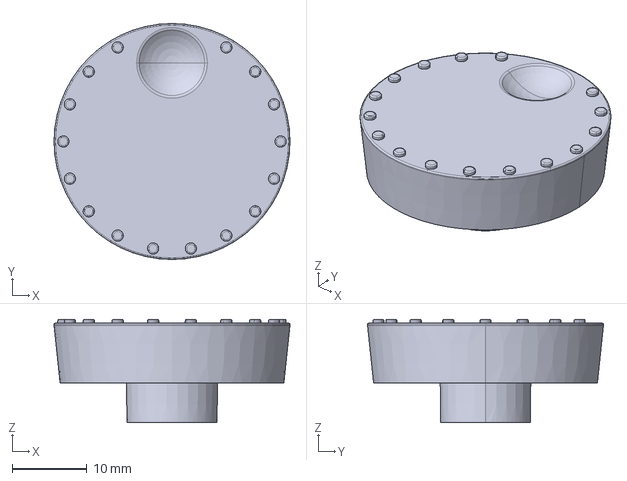
[picture p55: CAD file, 2014-03-27]
1244_Knob_Front_(x1)/1244-B2P-A.step
31.5 x 31.5 x 13.8 mm
