Ultimaker/Ultimaker2/1245_Knob_Housing_(x1)/1245-B2P-A.step

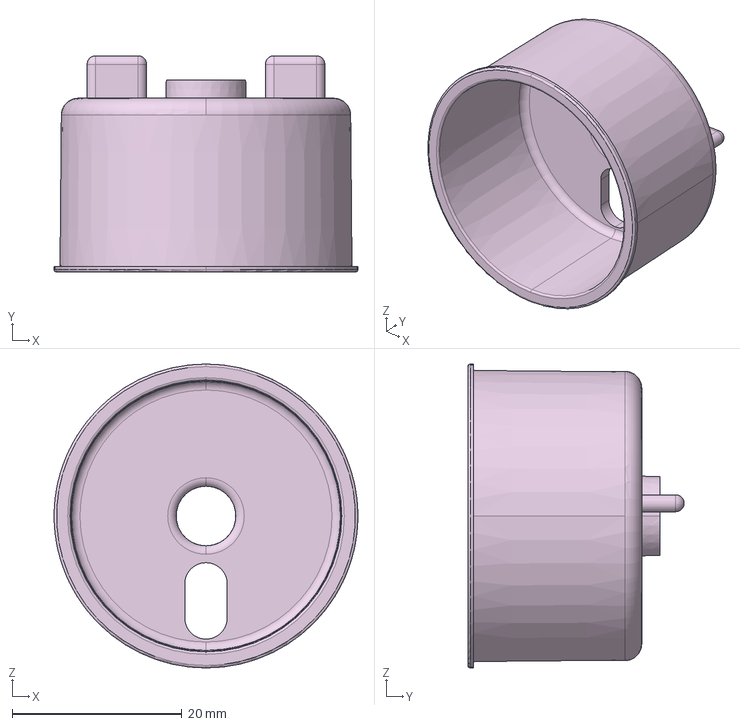
[picture p56: CAD file, 2014-03-27]
1245_Knob_Housing_(x1)/1245-B2P-A.step
35.8 x 25.5 x 35.8 mm
