Ultimaker/Ultimaker2/1247_Display_(x1)/1247-B2P-A.step

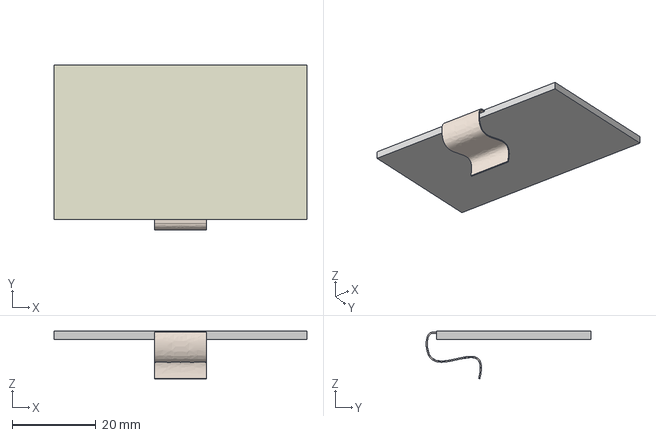
[picture p57: CAD file, 2014-03-27]
1247_Display_(x1)/1247-B2P-A.step
60.3 x 39.3 x 11.3 mm
