Ultimaker/Ultimaker2/1248_SD_card_(x1)/1248-Z1P-A SD card.STEP

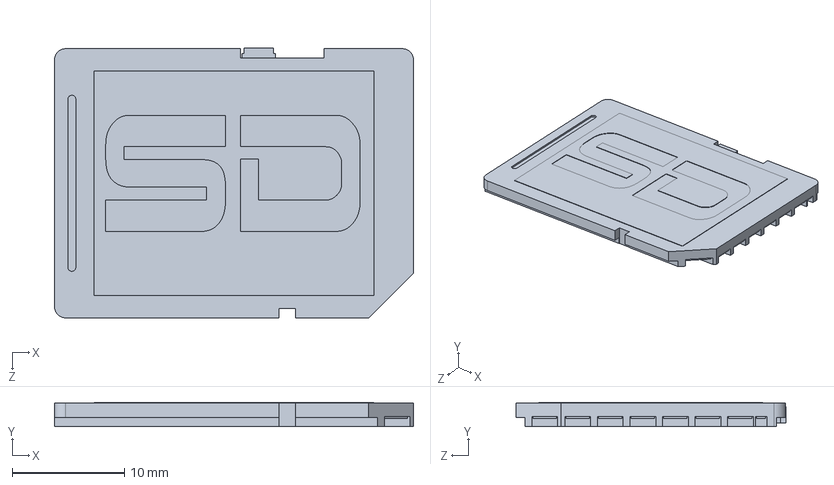
[picture p58: CAD file, 2014-03-27]
1248_SD_card_(x1)/1248-Z1P-A SD card.STEP
32.0 x 2.15 x 24.1 mm
