Ultimaker/Ultimaker2/1249_Ulticontroller_Board_(x1)/1249-B2P-A.step

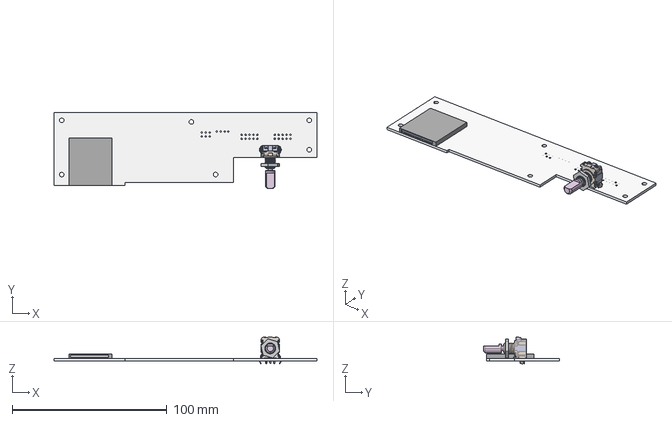
[picture p59: CAD file, 2014-03-27]
1249_Ulticontroller_Board_(x1)/1249-B2P-A.step
170.0 x 49.0 x 17.3 mm
