Ultimaker/Ultimaker2/1251_Ulticontroller_Electronics_Cover_(x1)/1251-B2P-A.step

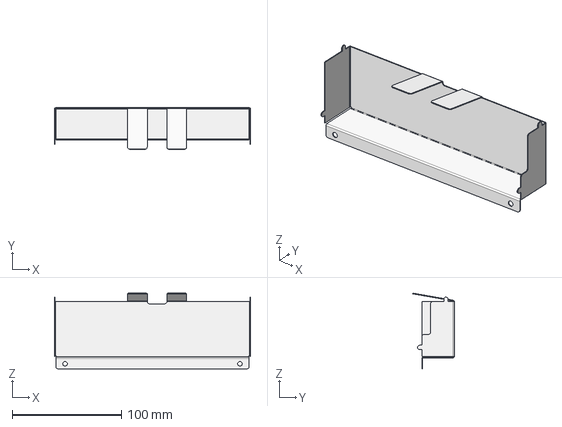
[picture p60: CAD file, 2014-03-27]
1251_Ulticontroller_Electronics_Cover_(x1)/1251-B2P-A.step
179.3 x 38.1 x 69.3 mm
