Ultimaker/Ultimaker2/1254_Print_Table_Mounting_Aid_(x3)/1254-B2P-B.STEP

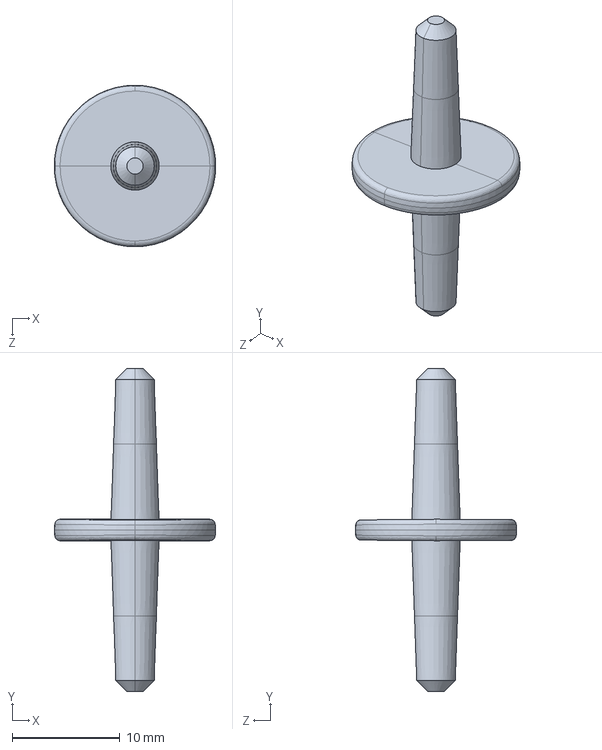
[picture p61: CAD file, 2014-03-27]
1254_Print_Table_Mounting_Aid_(x3)/1254-B2P-B.STEP
15.0 x 30.0 x 15.0 mm
