Ultimaker/Ultimaker2/1255_Sliding_Block_(x8)/1255-B2P-A.step

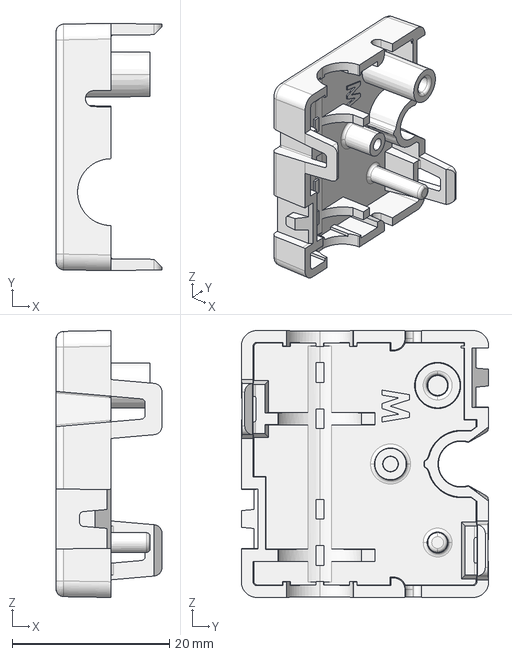
[picture p62: CAD file, 2014-03-27]
1255_Sliding_Block_(x8)/1255-B2P-A.step
13.5 x 31.5 x 34.0 mm
