Ultimaker/Ultimaker2/1256_Build_Platform_Glass_Retainer_Back_(x4)/1256-B2P-A.step

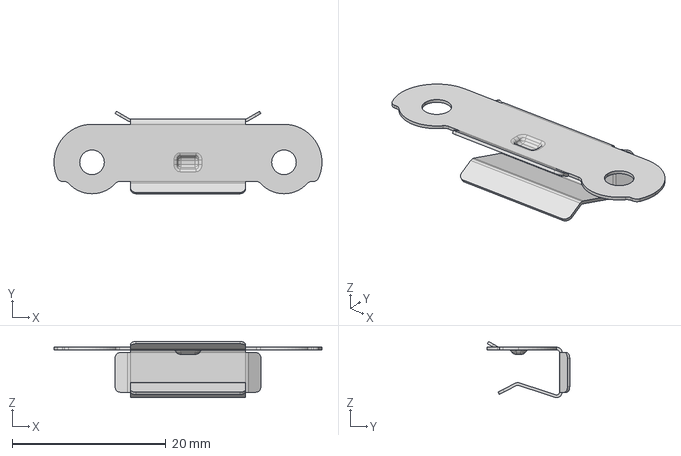
[picture p63: CAD file, 2014-03-27]
1256_Build_Platform_Glass_Retainer_Back_(x4)/1256-B2P-A.step
34.9 x 10.7 x 7.33 mm
