Ultimaker/Ultimaker2/1258_Feeder_Part_A_(x1)/1258-B2P-C.STEP

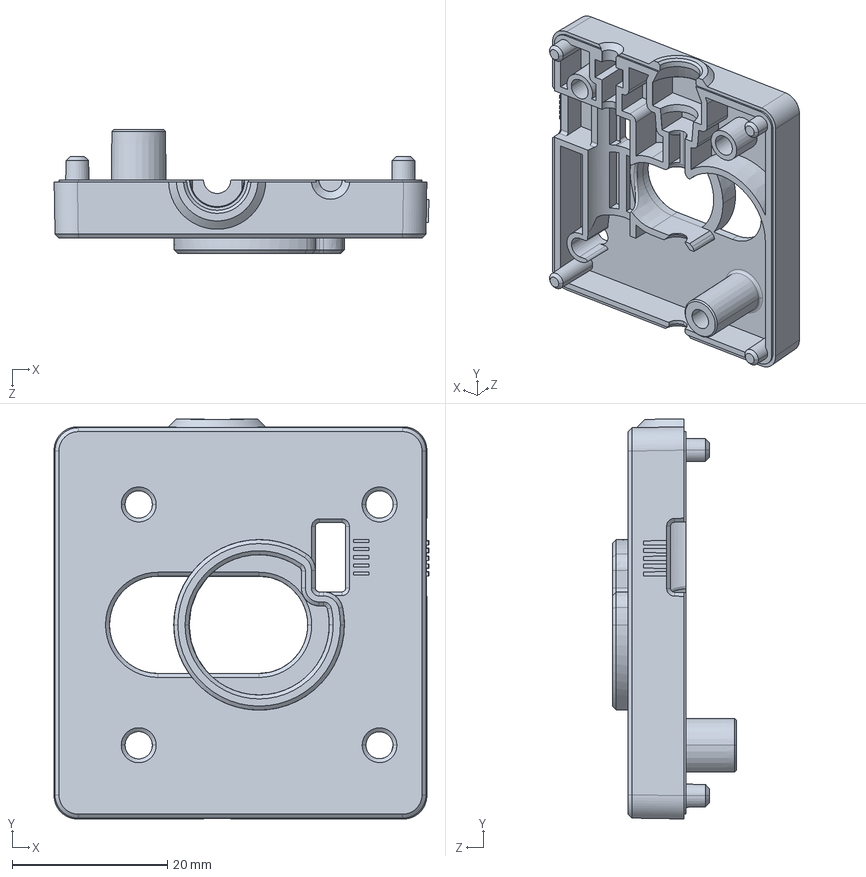
[picture p64: CAD file, 2014-03-27]
1258_Feeder_Part_A_(x1)/1258-B2P-C.STEP
48.3 x 51.5 x 16.0 mm
