Ultimaker/Ultimaker2/1259_Feeder_Part_B_(x1)/1259-B2P-C.STEP

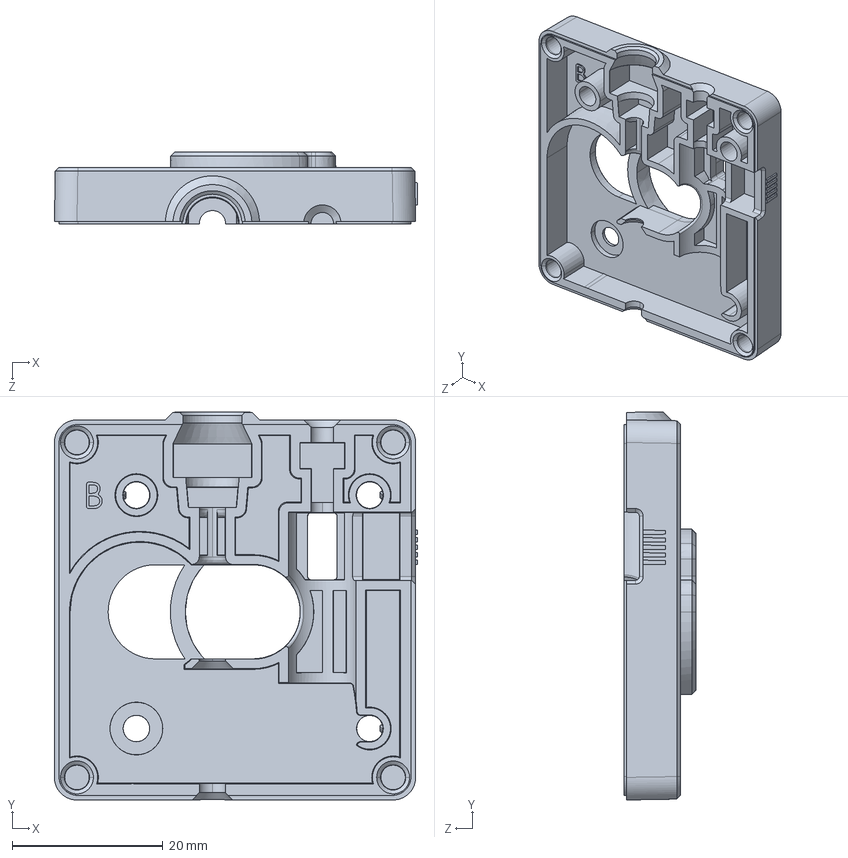
[picture p65: CAD file, 2014-03-27]
1259_Feeder_Part_B_(x1)/1259-B2P-C.STEP
48.3 x 51.5 x 9.50 mm
