Ultimaker/Ultimaker2/1260_Feeder_Lever_A_(x1)/1260-B2P-B.STEP

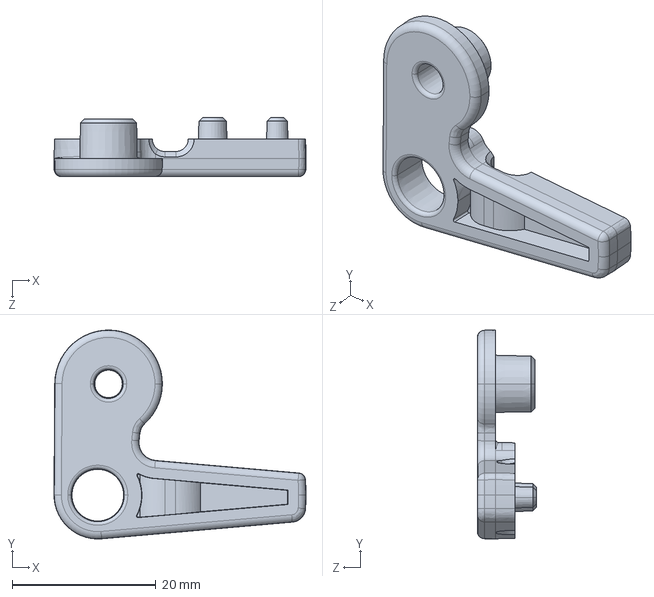
[picture p66: CAD file, 2014-03-27]
1260_Feeder_Lever_A_(x1)/1260-B2P-B.STEP
35.1 x 29.1 x 8.25 mm
