Ultimaker/Ultimaker2/1261_Feeder_Lever_B_(x1)/1261-B2P-B.STEP

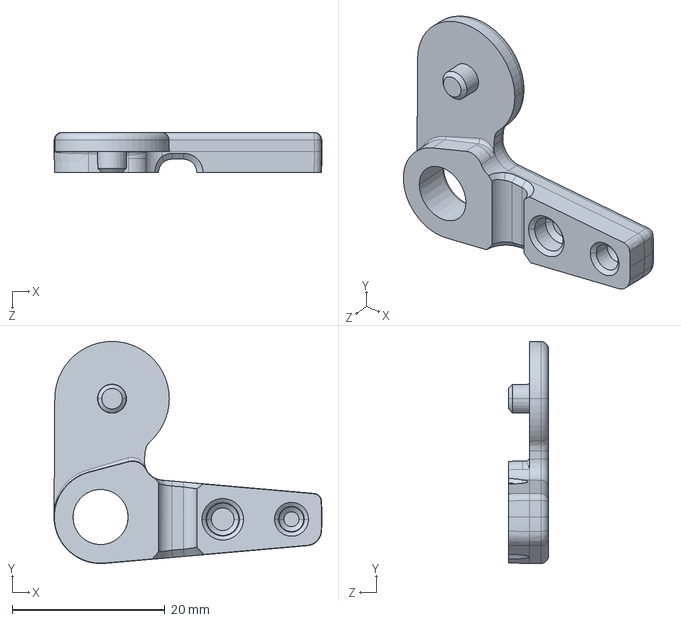
[picture p67: CAD file, 2014-03-27]
1261_Feeder_Lever_B_(x1)/1261-B2P-B.STEP
35.1 x 29.1 x 5.25 mm
