Ultimaker/Ultimaker2/1263_Feeder_Knurled_Wheel_(x1)/1263-B2P-A Feeder Knurled Wheel.STEP

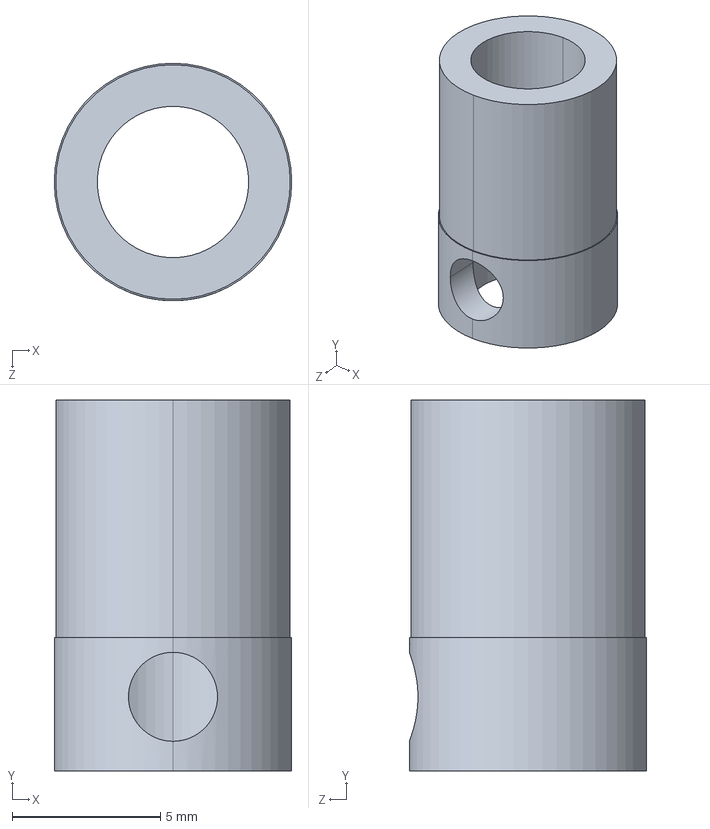
[picture p68: CAD file, 2014-03-27]
1263_Feeder_Knurled_Wheel_(x1)/1263-B2P-A Feeder Knurled Wheel.STEP
8.00 x 12.5 x 8.00 mm
