Ultimaker/Ultimaker2/1266_Bowden_tube_(x1)/1266-Z2P-B.STEP

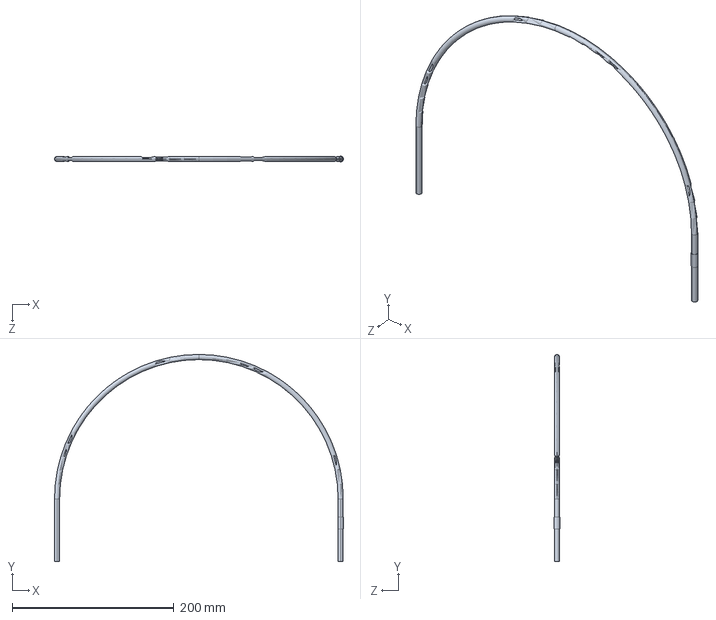
[picture p69: CAD file, 2014-03-27]
1266_Bowden_tube_(x1)/1266-Z2P-B.STEP
356.8 x 255.7 x 7.00 mm
