Ultimaker/Ultimaker2/1268_Heater_Cartridge_24V_25W_(x1)/1268-Z1P-A.step

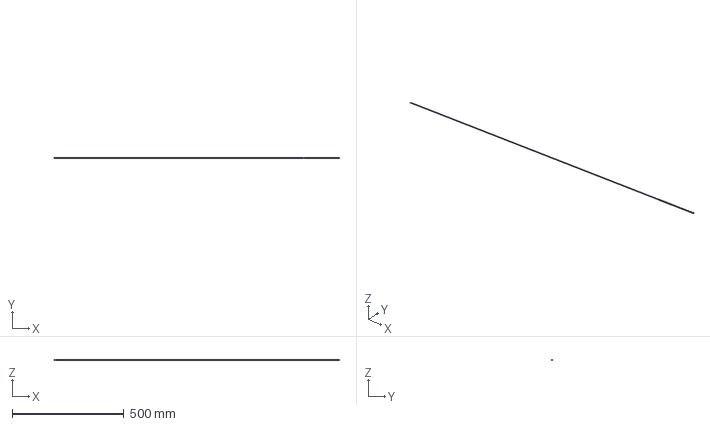
[picture p70: CAD file, 2014-03-27]
1268_Heater_Cartridge_24V_25W_(x1)/1268-Z1P-A.step
1272.8 x 4.00 x 4.00 mm
