Ultimaker/Ultimaker2/1269_Power_Cable_EU_Type_C13_(x1)/1269-Z1P-A.step

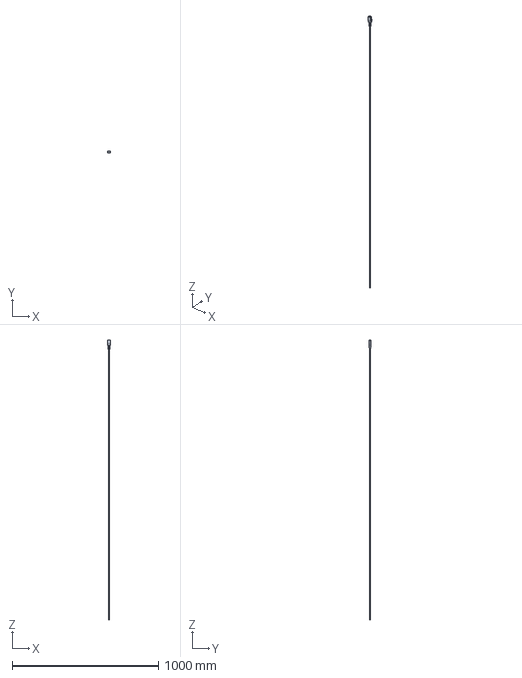
[picture p71: CAD file, 2014-03-27]
1269_Power_Cable_EU_Type_C13_(x1)/1269-Z1P-A.step
23.5 x 15.4 x 1916.2 mm
