Ultimaker/Ultimaker2/1270_Power_Cable_UK_Type_C13_(x1)/1270-Z1P-A.STEP

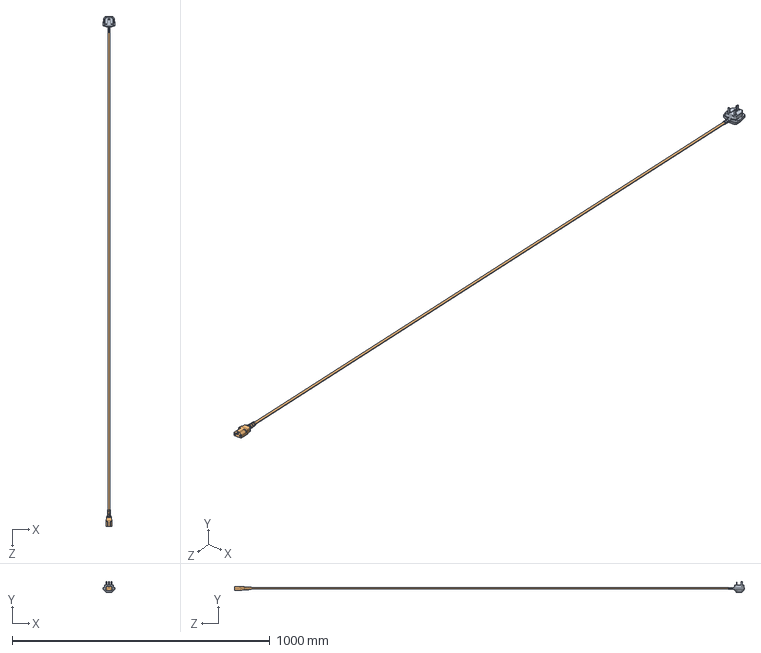
[picture p72: CAD file, 2014-03-27]
1270_Power_Cable_UK_Type_C13_(x1)/1270-Z1P-A.STEP
48.3 x 41.0 x 1978.2 mm
1270-Z1P-A Power Plug UK
1270-Z1P-A
