Ultimaker/Ultimaker2/1271_Power_Cable_AU_Type_C13_(x1)/1271-Z1P-A.STEP

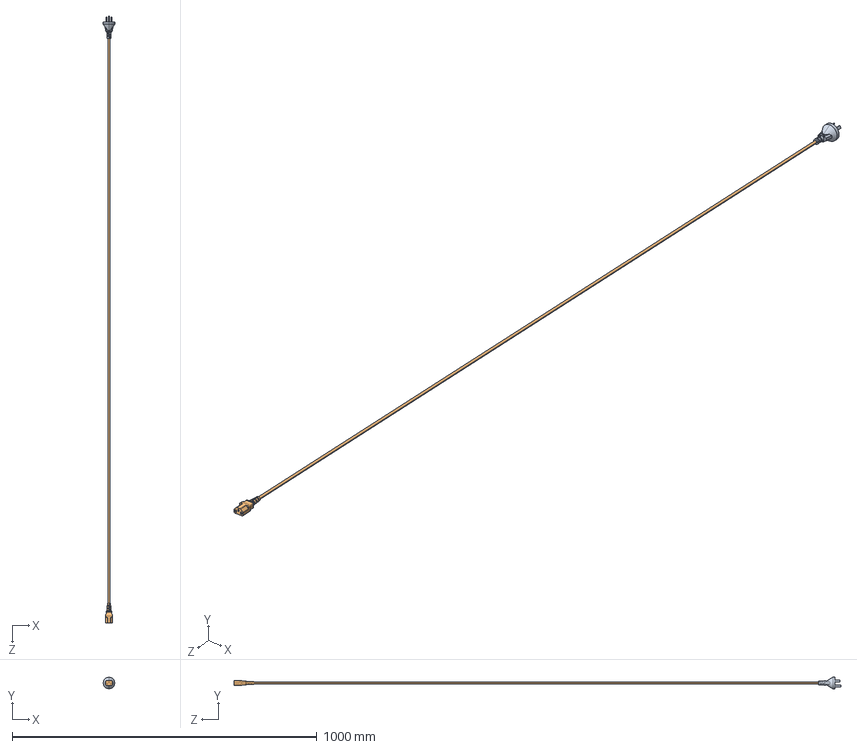
[picture p73: CAD file, 2014-03-27]
1271_Power_Cable_AU_Type_C13_(x1)/1271-Z1P-A.STEP
38.0 x 38.0 x 1990.2 mm
1271-Z1P-A Power Plug AU
1271-Z1P-A
