Ultimaker/Ultimaker2/1272_Power_Cable_US_Type_C13_(x1)/1272-Z1P-A.STEP

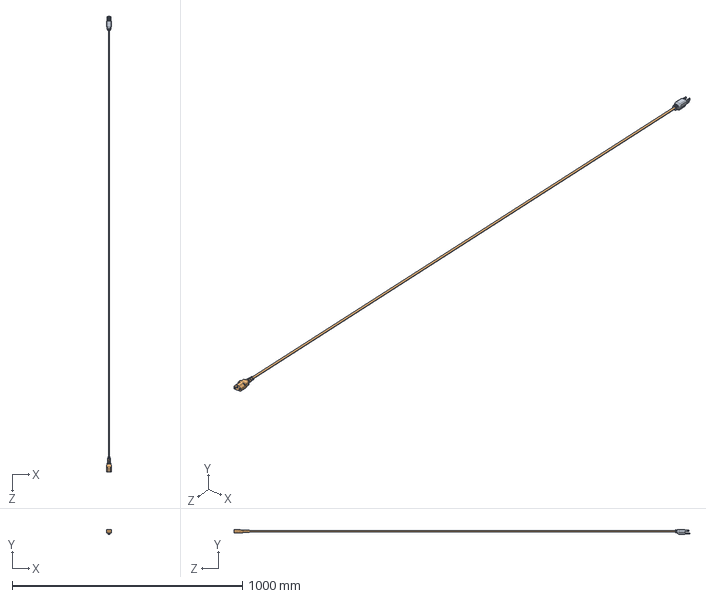
[picture p74: CAD file, 2014-03-27]
1272_Power_Cable_US_Type_C13_(x1)/1272-Z1P-A.STEP
23.5 x 22.5 x 1979.2 mm
1272-Z1P-A Power Plug US
1272-Z1P-A
