Ultimaker/Ultimaker2/1273_Cable_Cover_(x2)/1273-B2P-C.STEP

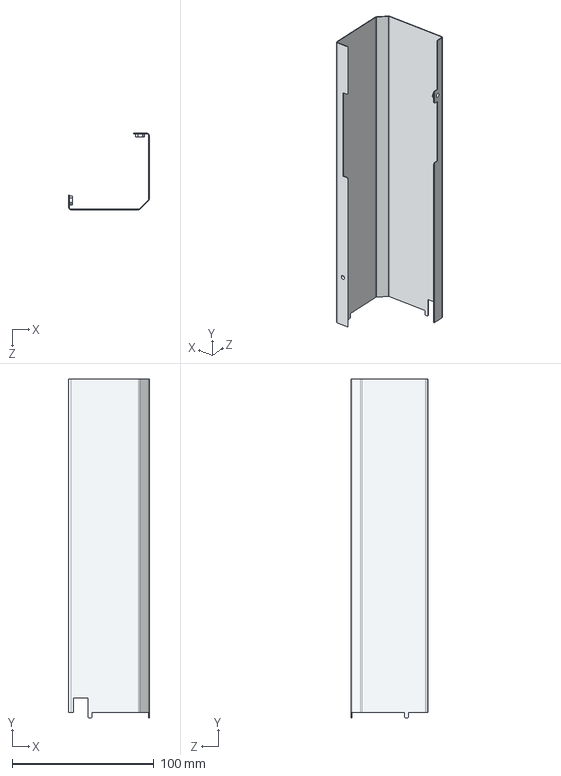
[picture p75: CAD file, 2014-03-27]
1273_Cable_Cover_(x2)/1273-B2P-C.STEP
56.8 x 239.0 x 54.0 mm
