Ultimaker/Ultimaker2/1281_Braided_Sleeve_Clip_(x5)/1281-B2P-C.STEP

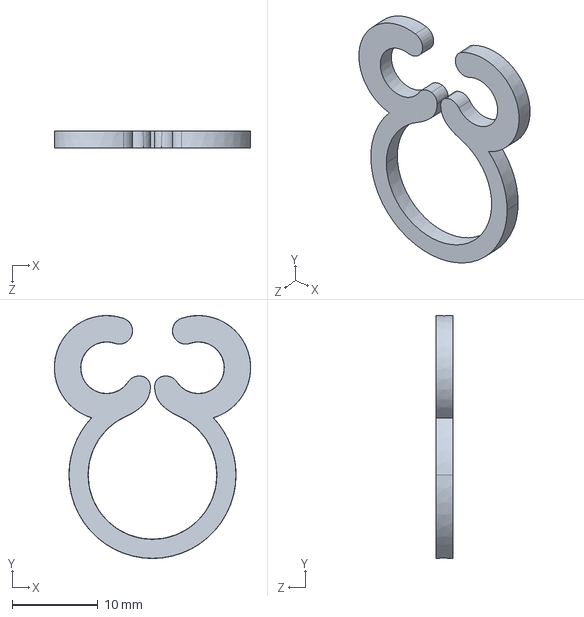
[picture p76: CAD file, 2014-03-27]
1281_Braided_Sleeve_Clip_(x5)/1281-B2P-C.STEP
22.9 x 28.3 x 2.00 mm
