Ultimaker/Ultimaker2/1290_Filament_guide_(x1)/1290-B2P-B.STEP

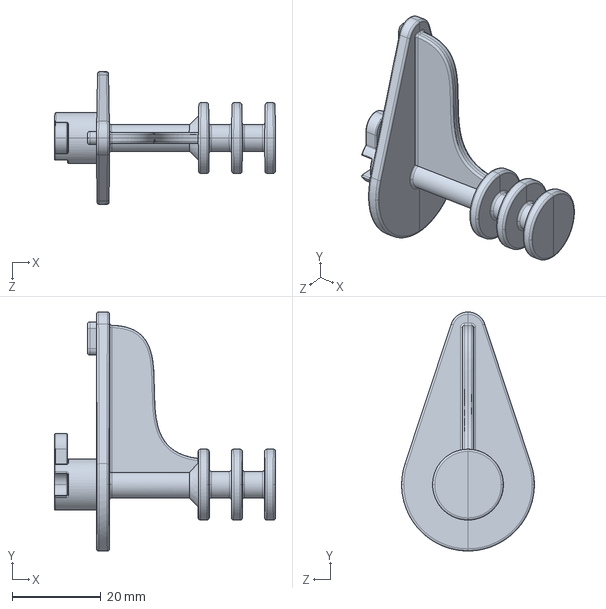
[picture p77: CAD file, 2014-03-27]
1290_Filament_guide_(x1)/1290-B2P-B.STEP
50.0 x 54.0 x 30.0 mm
