Ultimaker/Ultimaker2/1301_Integrated_nozzle_heater_block_3mm_filament_(x1)/1301-Z2P-D integrated nozzle 3mm.STEP

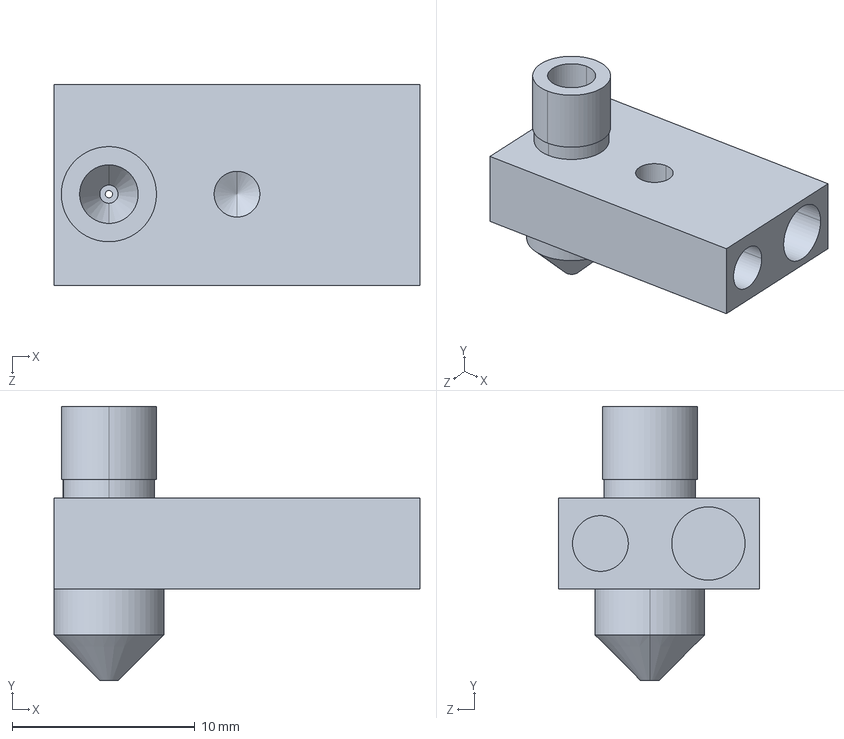
[picture p78: CAD file, 2014-03-27]
1301_Integrated_nozzle_heater_block_3mm_filament_(x1)/1301-Z2P-D integrated nozzle 3mm.STEP
20.0 x 15.0 x 11.0 mm
