Ultimaker/Ultimaker2/1306_Hot_end_holder_bottom_(x1)/1306-Z2P-B hot end holder bottom.STEP

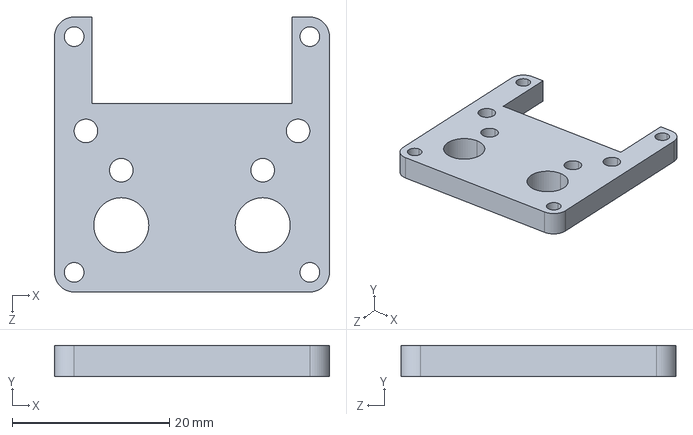
[picture p79: CAD file, 2014-03-27]
1306_Hot_end_holder_bottom_(x1)/1306-Z2P-B hot end holder bottom.STEP
35.0 x 4.00 x 35.0 mm
