Ultimaker/Ultimaker2/1307_Hot_end_holder_top_(x1)/1307-Z2P-B Hot End Holder Top.STEP

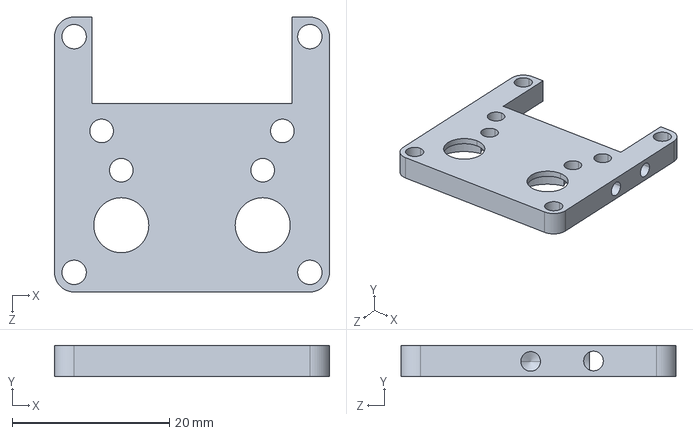
[picture p80: CAD file, 2014-03-27]
1307_Hot_end_holder_top_(x1)/1307-Z2P-B Hot End Holder Top.STEP
35.0 x 4.00 x 35.0 mm
