Ultimaker/Ultimaker2/1308_Cooling_Rib_Hot_End_(x1)/1308-Z2P-B Cooling Rib Hot End.STEP

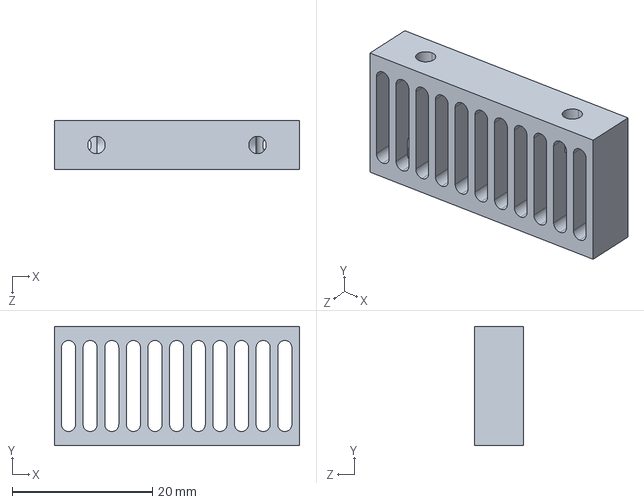
[picture p81: CAD file, 2014-03-27]
1308_Cooling_Rib_Hot_End_(x1)/1308-Z2P-B Cooling Rib Hot End.STEP
35.0 x 17.0 x 7.00 mm
