Ultimaker/Ultimaker2/1309_PTFE_Isolator_Coupler_3.2_mm_(x1)/1309-Z2P-B Hot End Isolator Coupler.STEP

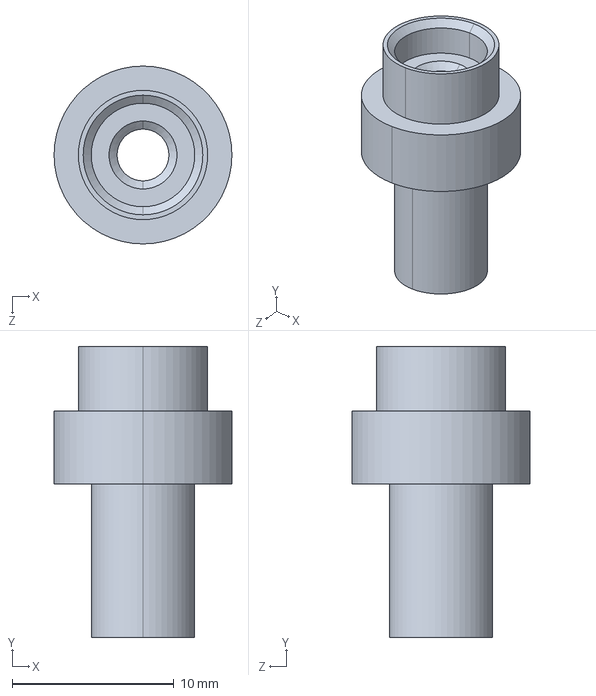
[picture p82: CAD file, 2014-03-27]
1309_PTFE_Isolator_Coupler_3.2_mm_(x1)/1309-Z2P-B Hot End Isolator Coupler.STEP
11.0 x 18.0 x 11.0 mm
