Ultimaker/Ultimaker2/1310_Hot_end_Isolator_(x1)/1310-Z2P-A Hot end Isolator.STEP

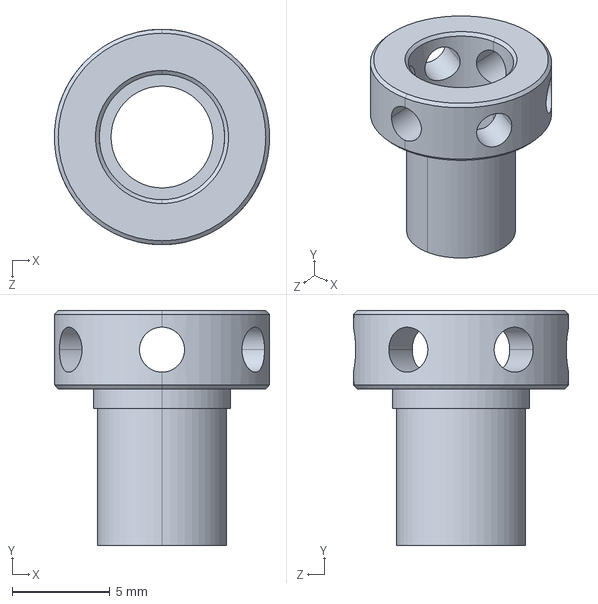
[picture p83: CAD file, 2014-03-27]
1310_Hot_end_Isolator_(x1)/1310-Z2P-A Hot end Isolator.STEP
11.0 x 12.0 x 11.0 mm
