Ultimaker/Ultimaker2/1313_Model_Cooling_Fan_12VDC_0.1_A_(x2)/1313-Z1P-A.STEP

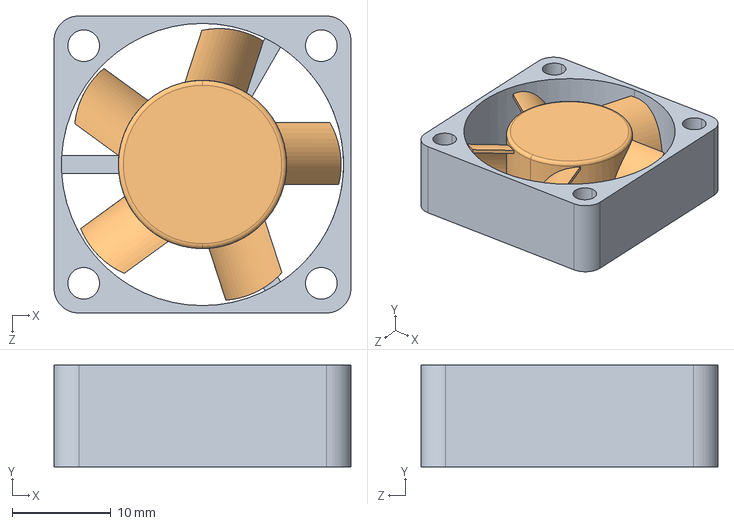
[picture p84: CAD file, 2014-03-27]
1313_Model_Cooling_Fan_12VDC_0.1_A_(x2)/1313-Z1P-A.STEP
30.0 x 10.3 x 30.0 mm
Fan Base 30x30
Fan Rotor 30x30
