Ultimaker/Ultimaker2/1315_Jumper_(x2)/1315-Z1P-A.STEP

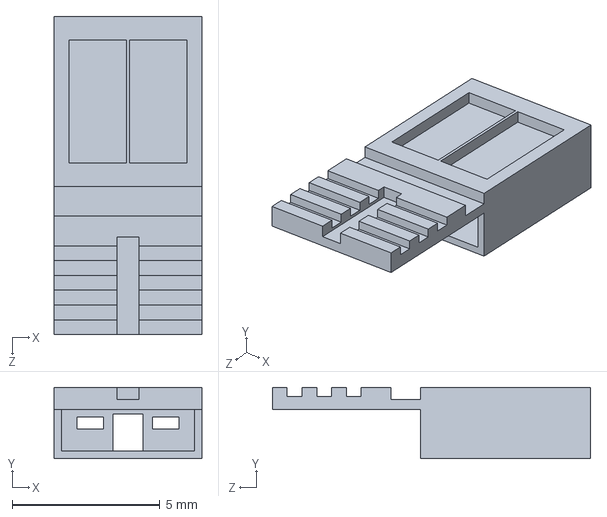
[picture p85: CAD file, 2014-03-27]
1315_Jumper_(x2)/1315-Z1P-A.STEP
5.00 x 2.40 x 10.8 mm
