Ultimaker/Ultimaker2/1320_Print_Head_Top_(x1)/1320-D.STEP

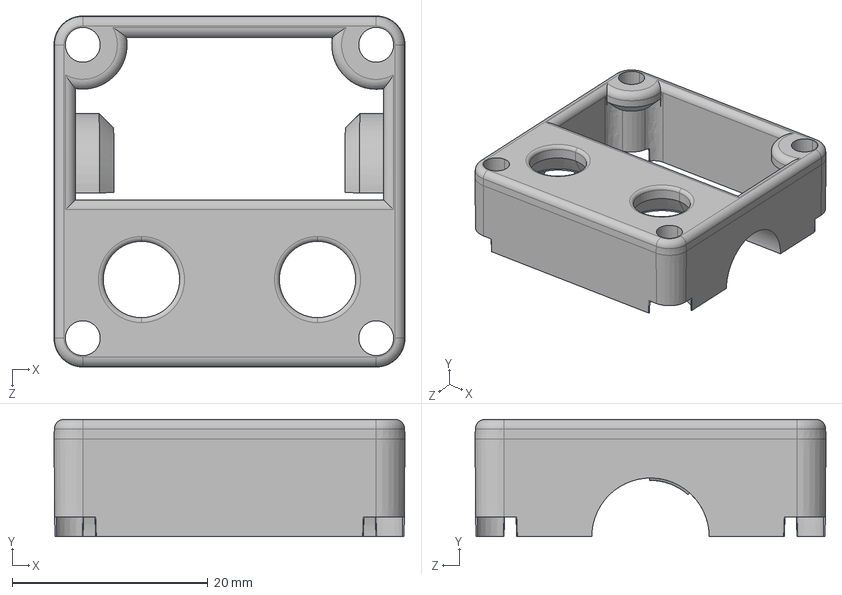
[picture p86: CAD file, 2016-08-16]
1320_Print_Head_Top_(x1)/1320-D.STEP
35.9 x 12.0 x 35.9 mm
