Ultimaker/Ultimaker2/1321_Print_Head_Middle_(x1)/1321-B2P-B.STEP

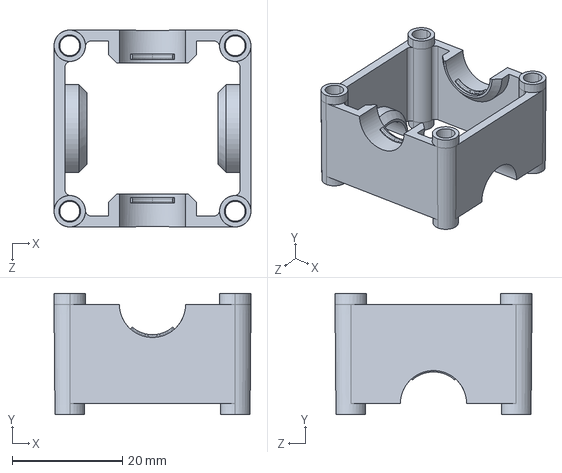
[picture p87: CAD file, 2014-03-27]
1321_Print_Head_Middle_(x1)/1321-B2P-B.STEP
35.7 x 22.0 x 35.7 mm
