Ultimaker/Ultimaker2/1322_Print_Head_Bottom_(x1)/1322-B2P-C.STEP

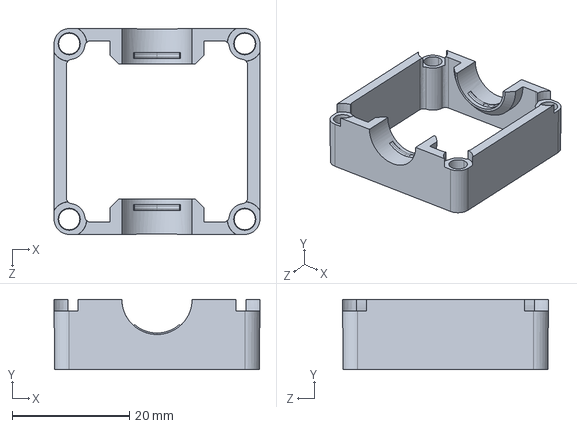
[picture p88: CAD file, 2014-03-27]
1322_Print_Head_Bottom_(x1)/1322-B2P-C.STEP
35.2 x 12.0 x 35.2 mm
