Ultimaker/Ultimaker2/1329_Dual_fan_bracket_(x1)/1329-B2P-C.STEP

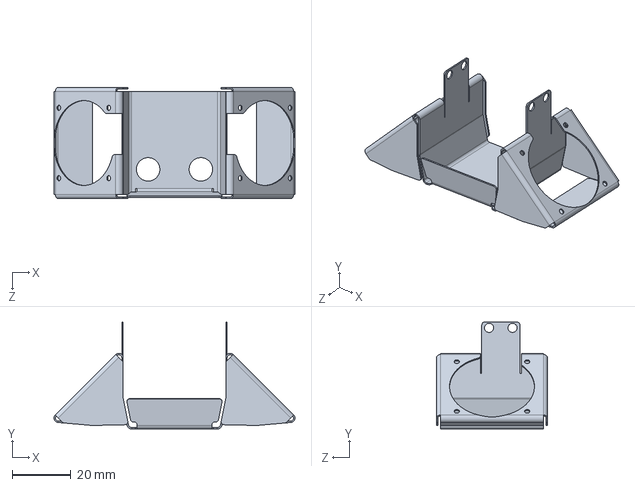
[picture p89: CAD file, 2014-03-27]
1329_Dual_fan_bracket_(x1)/1329-B2P-C.STEP
82.2 x 36.5 x 38.0 mm
