Ultimaker/Ultimaker2/1330_Hot-end_Cooling_Fan_5VDC_0.08A_(x1)/1330-Z1P-B.STEP

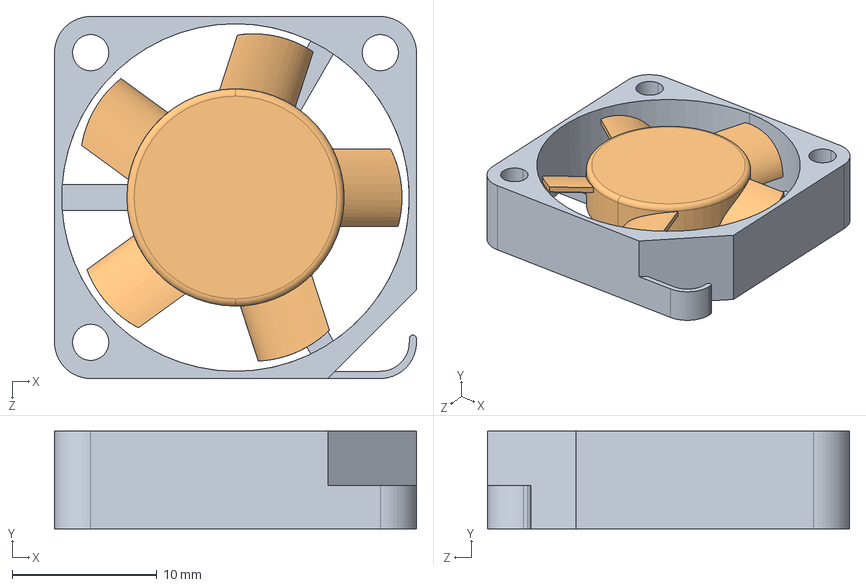
[picture p90: CAD file, 2014-03-27]
1330_Hot-end_Cooling_Fan_5VDC_0.08A_(x1)/1330-Z1P-B.STEP
25.0 x 6.75 x 25.0 mm
1330 Fan Base 25x25
1330 Fan Rotor 25x25
