Ultimaker/Ultimaker2/1348_ISO_7380_M3x4_A2_(x4)/1348-B2P-A.step

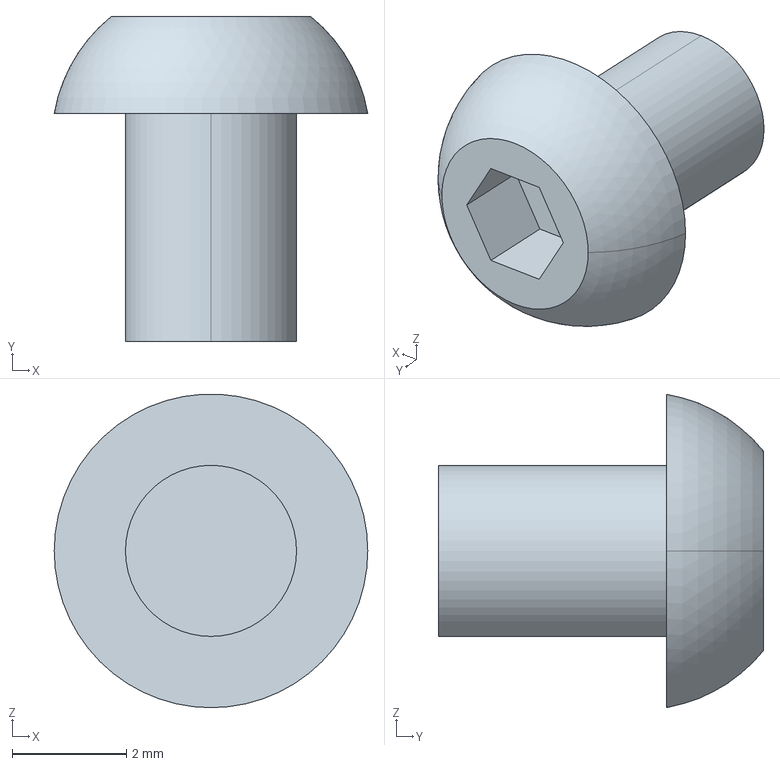
[picture p91: CAD file, 2014-03-27]
1348_ISO_7380_M3x4_A2_(x4)/1348-B2P-A.step
5.50 x 5.70 x 5.50 mm
