Ultimaker/Ultimaker2/1351_ISO_4762_M2,5x10_(x2)/1351-B2P-A.step

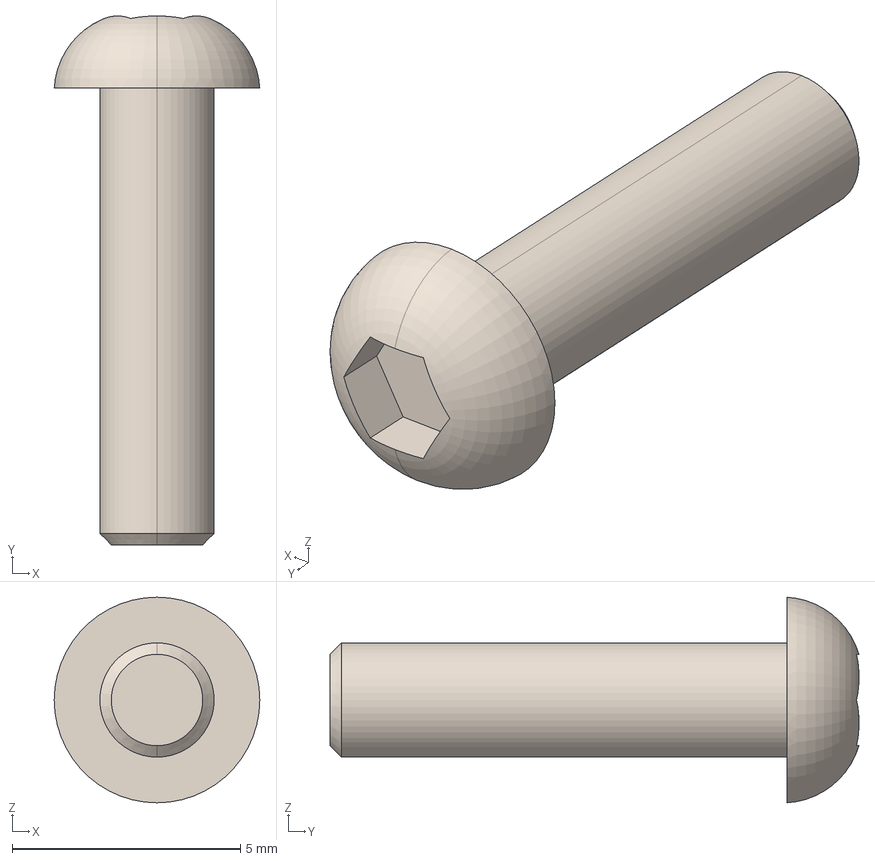
[picture p92: CAD file, 2014-03-27]
1351_ISO_4762_M2,5x10_(x2)/1351-B2P-A.step
4.50 x 11.6 x 4.50 mm
