Ultimaker/Ultimaker2/1400_Hex_Key_Wrench_1.5_(x1)/1400-Z1P-A.step

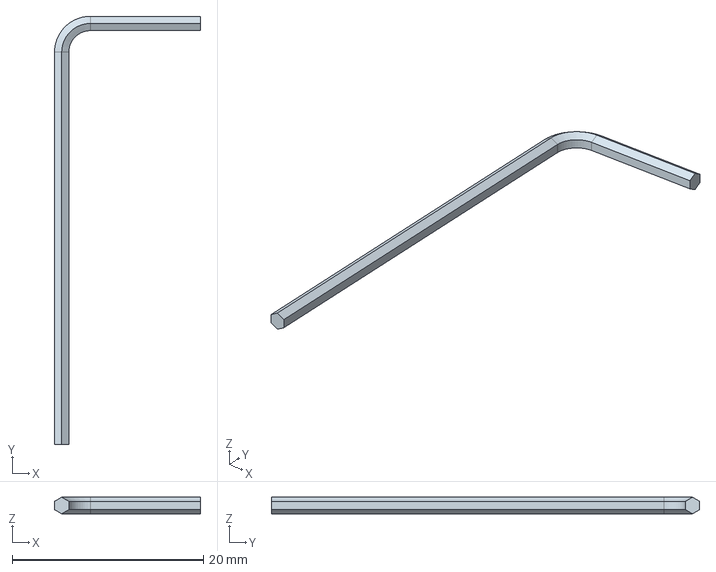
[picture p93: CAD file, 2014-03-27]
1400_Hex_Key_Wrench_1.5_(x1)/1400-Z1P-A.step
15.2 x 44.8 x 1.73 mm
