Ultimaker/Ultimaker2/1401_Hex_Key_Wrench_2_(x1)/1401-Z1P-A.STEP

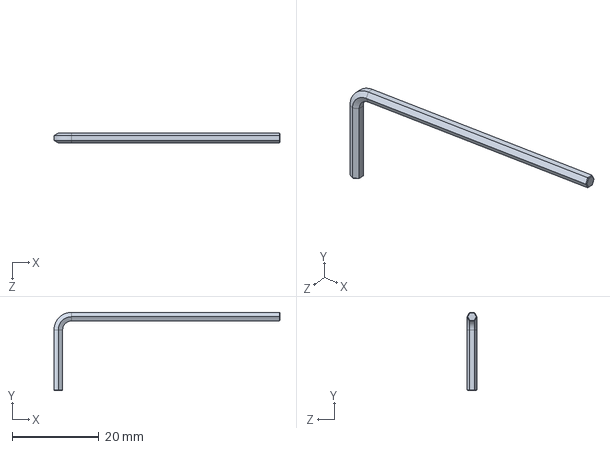
[picture p94: CAD file, 2014-03-27]
1401_Hex_Key_Wrench_2_(x1)/1401-Z1P-A.STEP
52.0 x 18.0 x 2.31 mm
