Ultimaker/Ultimaker2/1402_Hex_Key_Wrench_2.5_(x1)/1402-Z1P-A.STEP

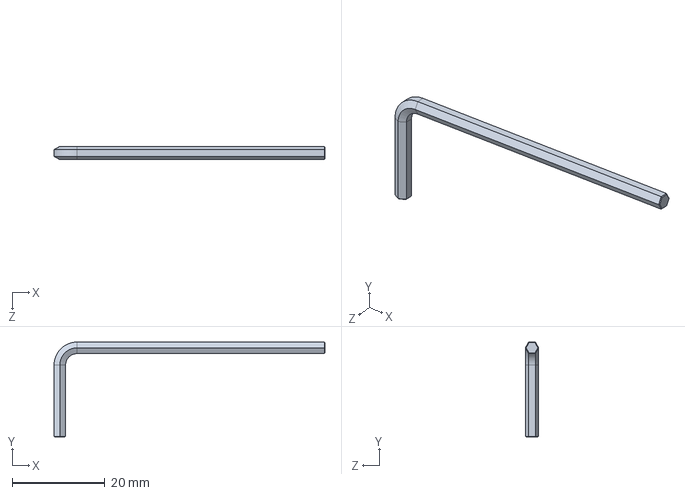
[picture p95: CAD file, 2014-03-27]
1402_Hex_Key_Wrench_2.5_(x1)/1402-Z1P-A.STEP
58.5 x 20.5 x 2.89 mm
