Ultimaker/Ultimaker2/(list of files, cad)

Other CAD files:
1163_Limit_Switch,_Red_Wire_(x1)/1163-B2P-B.step
1233_Right_Panel_(x1)/1233-B2P-B.STEP
1074_Print_Head_Thumb_screw_(x4)/1074-Z1P-A.STEP
1187_Trapezoidal_Lead_Nut_(x1)/1187-B2P-A.step
1201_Washer_Large_M3_(x12)/1201-Z1P-A.STEP
1209_Nut_M3_(x1)/1209-Z1P-A.STEP
1211_Set_Screw_M4x4_(x12)/1211-Z1P-A.STEP
1212_Set_Screw_M3x3_(x1)/1212-Z1P-A.STEP
1213_DIN_962_Square_Nut_M3_A2_(x37)/1213-Z1P-A.step
1214_ISO_7040_Nut_M3_Prev._torque_A2_(x15)/1214-Z1P-A.step
1257_Knurled_Nut_Platform_(x3)/1257-B2P-B.STEP
1264_Feeder_Nut_Holder_(x1)/1264-B2P-C .STEP
1287_Washer_M7_(x1)/1287-Z1P-A.STEP
1352_Set_Screw_M3x14_(x1)/1352-B2P-A.step
1354_ISO_724_Hex_nut_M7_(x1)/1354-Z1P-A.STEP
