Ultimaker/Ultimaker2/(threads)

Thread 16 (2015-05-16):

.step file 1230_Front_Panel

schablone, 2015-05-16:
Hey, I try to open different .step files with different CAD systems, but it does not work. Can anybody send me the CAD file ot the Ultmaker front door. Thanks.

jorgebalaguer, 2015-05-16:
Wich cad format do you prefer?

schablone, 2015-05-16:
Parasolid would be great. Step normally should also work.

jorgebalaguer, 2015-05-16:
Solidworks repaired some broken surfaces. Let's try.
K.R.

Jorge J. Balaguer

2015-05-16 21:05 GMT+02:00 schablone <notifications@github.com>:

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

schablone, 2015-05-16:
You can send me a email to schablone666@web.de

thank you.

Closed 2015-05-17.

Thread 17 (2015-05-25):

Thickness of panels

Batfather, 2015-05-25:
Good day!

I want to clarify what is the thickness of panels.
As I see right panel has 5mm thickness, and left is 6mm. Is it right?

Some questions more:
Alu/PE/Alu - is it an aluminium composite? If yes, can I use 4mm panels and not 6mm, like in drawing? Will the quality be damaged cause of this?

Thanks

harmawoldhuis, 2015-05-25:
Hey,

I'm not sure what went wrong with the panels. All panels are 6 mm. Some are
of perspex (sides). The rest is of a dibond sandwitch material with ALU:
0.3mm (x2) and PE: 5.4mm

I wouldn't try with 4mm panels: you need to find other bearings, other
electronics etc and it will be a lot less rigid.

Kind regard,

Harma Woldhuis

2015-05-25 19:25 GMT+02:00 Evgeniy Koltsov <notifications@github.com>:

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

Thread 19 (2016-07-15):

The top print head files were overwritten with a fan model

DefProc, 2016-07-15:
Looking at the history of the [`1320_Print_Head_Top_(x1)`](https://github.com/Ultimaker/Ultimaker2/commits/master/1320_Print_Head_Top_(x1)) folder, The original print head top model and drawings were [overwritten](https://github.com/Ultimaker/Ultimaker2/commit/0f47097a1351a3b4d1144491b7c2aa4c25af8c69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) by a fan model and drawing.

It looks like the files in the folder should be restored to the versions present at 71ec0cd9765a7a3c208167f37ee3231b9a6c7462

rruggiero, 2016-07-15:
I have this version from Jan 4, 2016.

Rick Ruggiero

m: 0450 025 425
e: rick.ruggiero@gmail.com

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

harmawoldhuis, 2016-08-16:
I've replaced the files with the correct fans.
sorry for the mixup

harma

Closed 2016-08-16.
