Ultimaker/Ultimaker2/1320_Print_Head_Top_(x1)/B1320-D.PDF

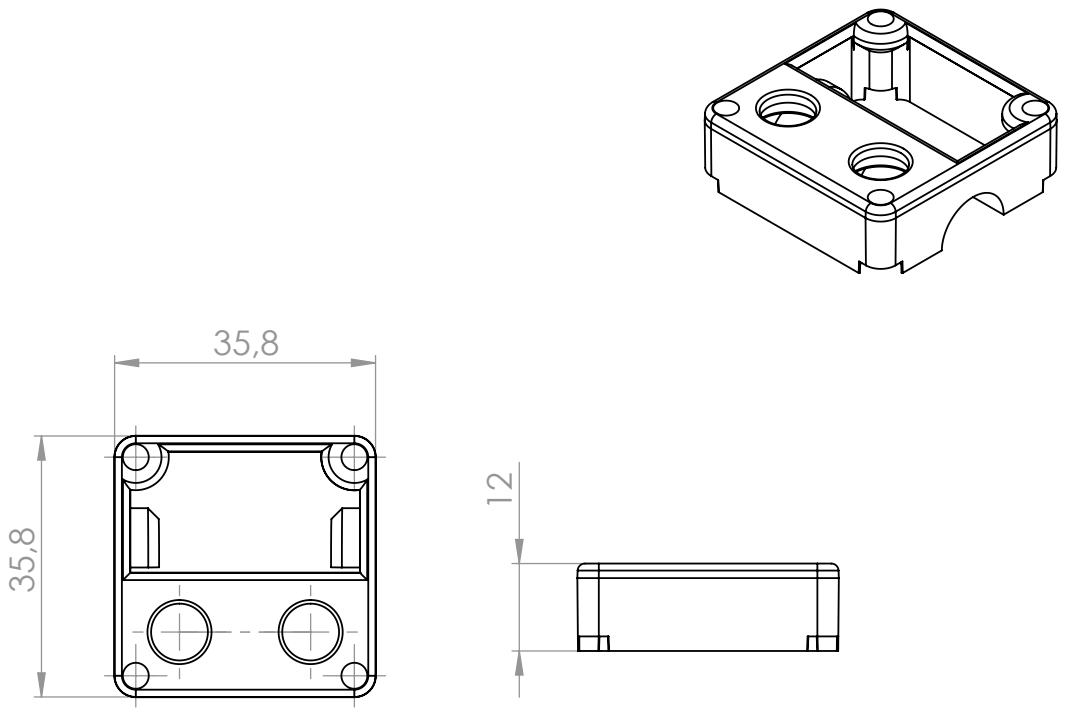
[picture p96: page 1]

Burgemeester R. vd Venlaan 4191PL Geldermalsen The Netherlands T: +31 (0)345 712 017 | Part Nr.: 1320 | Revision: D Initials: MK

Drawn: M Kutluk | Checked by: Jan Oosting | Description: Print head top

Scale: 1:1 (A4) | Approved by: M. van Rooij
Units: mm. | Norm: ISO 2678-f | Released for prototyping: Yes

Date: 16-07-2015 | Material: D American Projection PA6-GF30 | Released for null-series: Yes

Released for production:
