Ultimaker/Ultimaker2/1325_Insert_material_sticker_(x1)/B1325-Z1P-A.pdf

## Spec. Sheet

33 mm

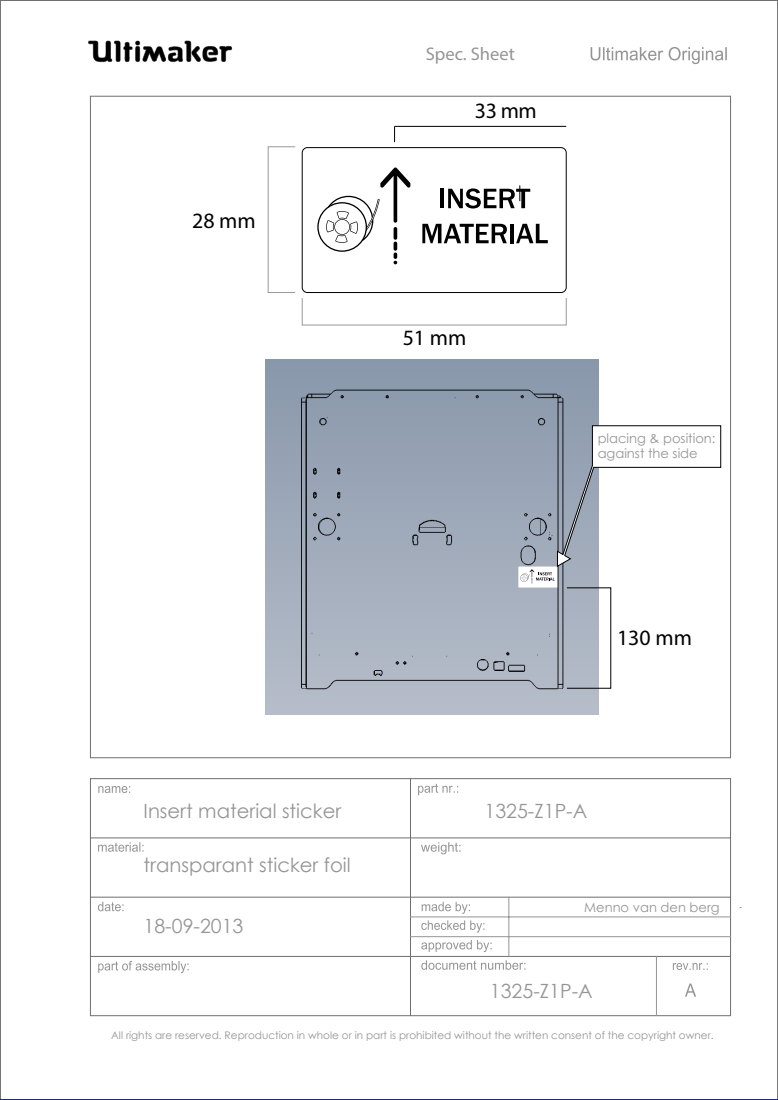
[picture p97: page 1]

placing & position:
against the side

Insert material sticker

transparant sticker foil

Menno van den berg

All rights are reserved. Reproduction in whole or in part is prohibited without the written consent of the copyright owner.
