Ultimaker/Ultimaker2/1256_Build_Platform_Glass_Retainer_Back_(x4)/B1256-B2P-A.PDF

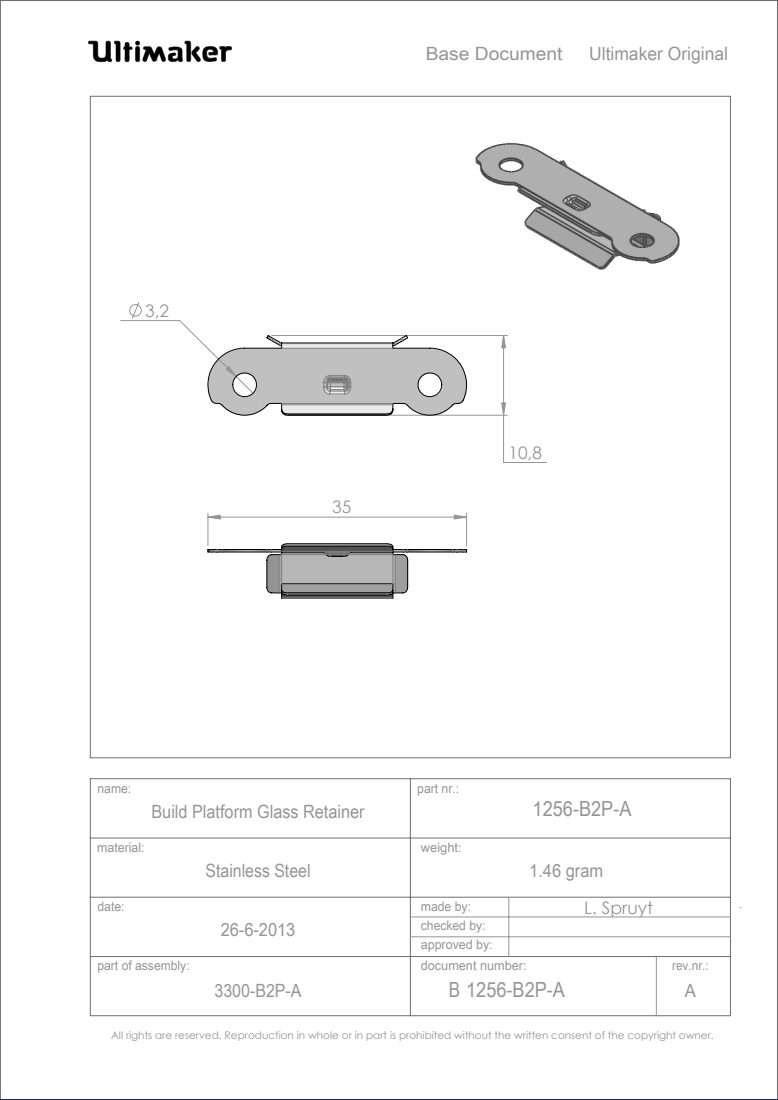
[picture p98: page 1]
Stainless Steel; 1.46 gram; Ultimaker Original; part of assembly:; rev.nr.:; part nr.:; made by:; Base Document; approved by:; checked by:; L. Spruyt; document number: B 1256-B2P-A

name:
Build Platform Glass Retainer

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
