Ultimaker/Ultimaker2/1254_Print_Table_Mounting_Aid_(x3)/B1254-B2P-A.PDF

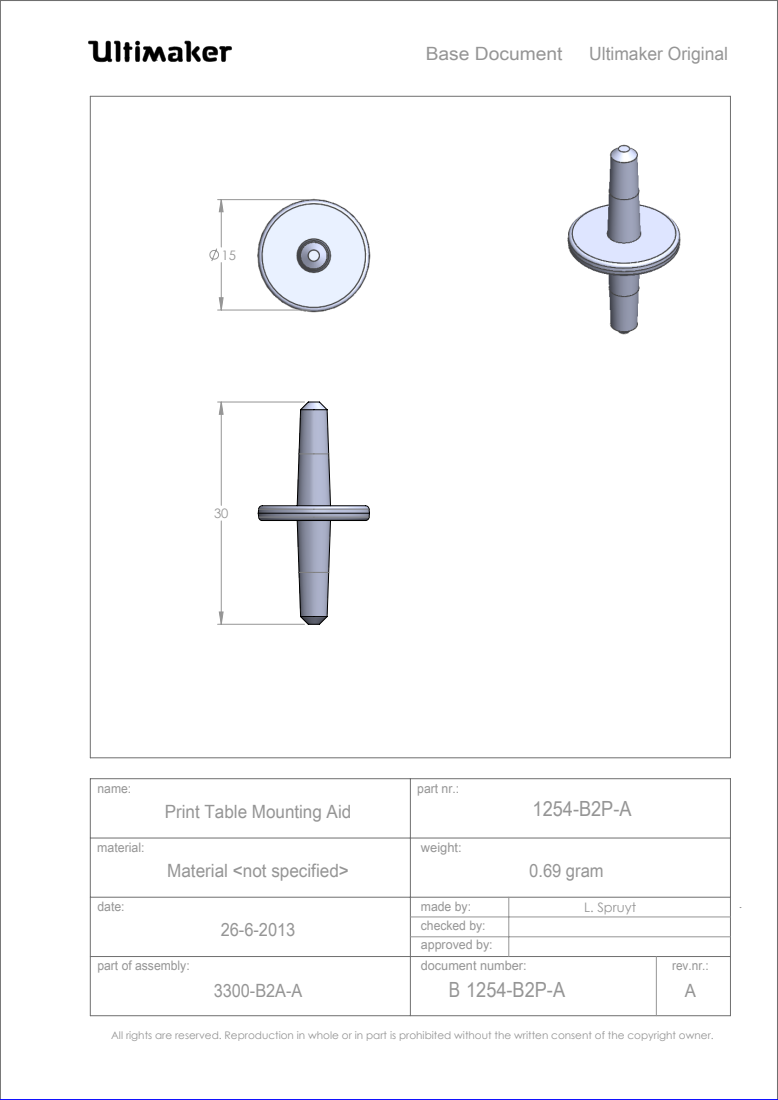
[picture p99: page 1]
Material <not specified>; 0.69 gram; Ultimaker Original; part of assembly:; rev.nr.:; part nr.:; made by:; Base Document; approved by:; checked by:; L. Spruyt; document number: B 1254-B2P-A

name:
Print Table Mounting Aid

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
