Ultimaker/Ultimaker2/1251_Ulticontroller_Electronics_Cover_(x1)/B1251-B2P-A.PDF

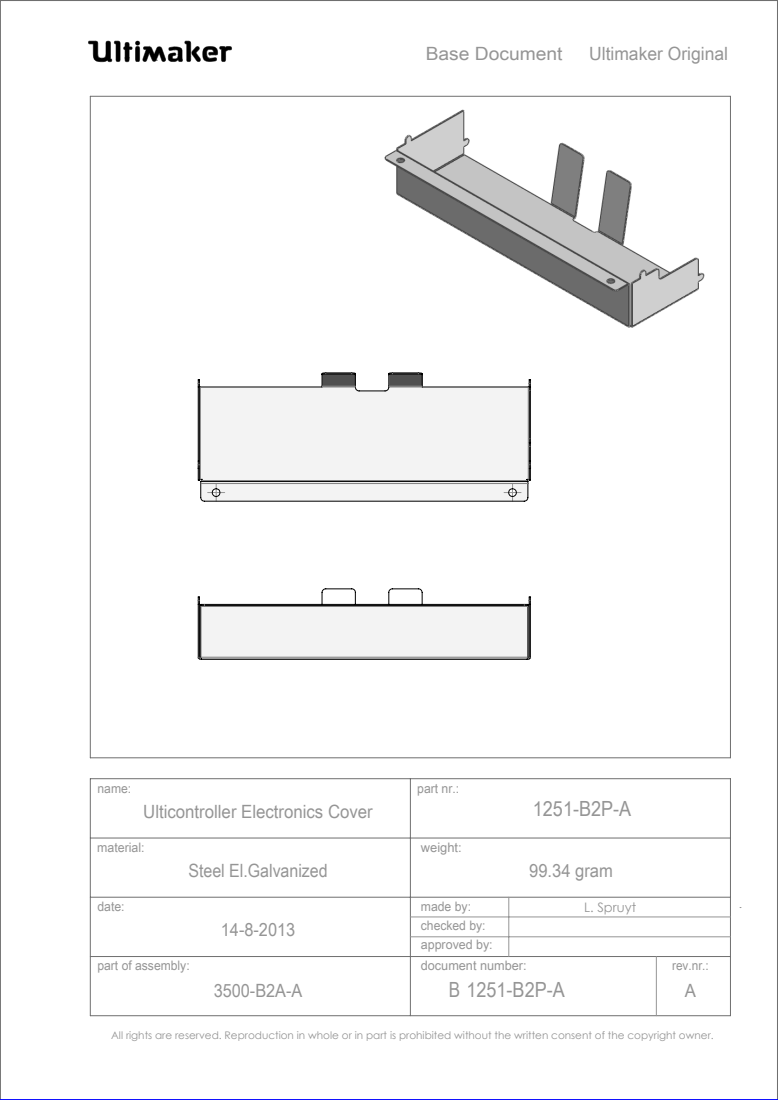
[picture p100: page 1]
Steel El.Galvanized; 99.34 gram; Ultimaker Original; part of assembly:; rev.nr.:; part nr.:; made by:; Base Document; approved by:; checked by:; L. Spruyt; document number: B 1251-B2P-A

name:
Ulticontroller Electronics Cover

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
