Ultimaker/Ultimaker2/1240_Main_Board_Electronics_Cover_(x1)/B1240-B2P-A.PDF

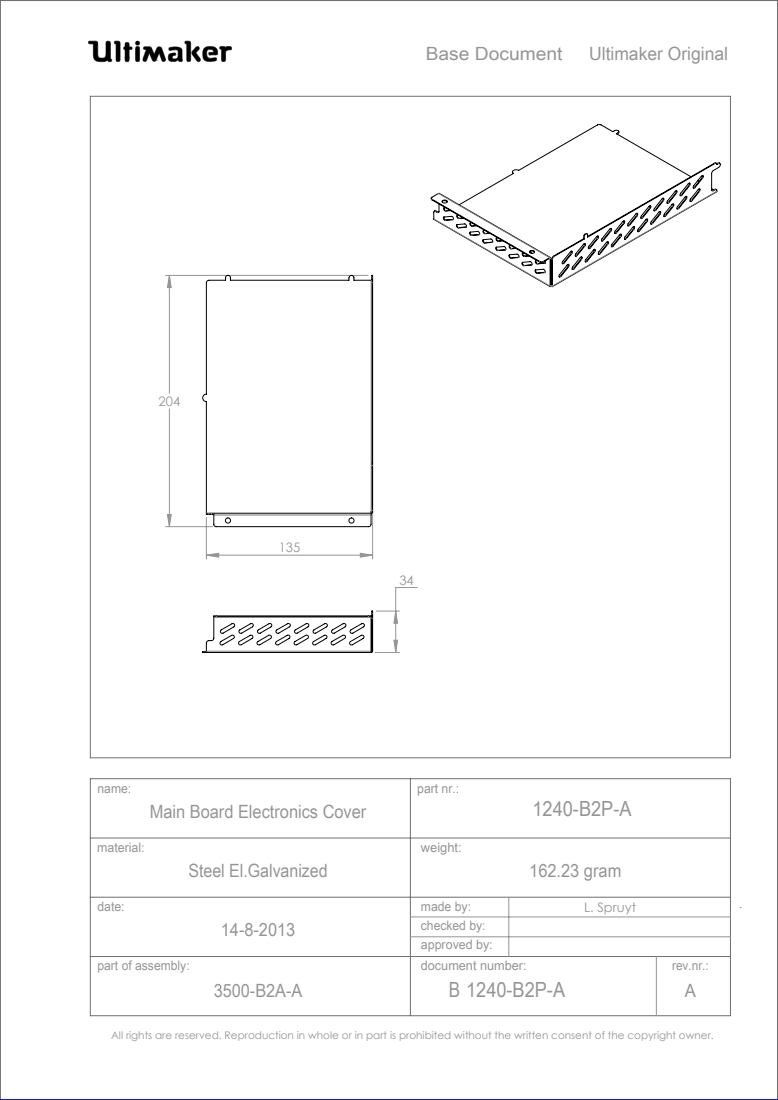
[picture p101: page 1]
Steel El.Galvanized; 162.23 gram; Ultimaker Original; part of assembly:; rev.nr.:; part nr.:; made by:; Base Document; approved by:; checked by:; L. Spruyt; document number: B 1240-B2P-A

name:
Main Board Electronics Cover

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
