Ultimaker/Ultimaker2/1186_Print_Head_Cable_(x1)/B1186-B2P-C.pdf

## Spec. sheet

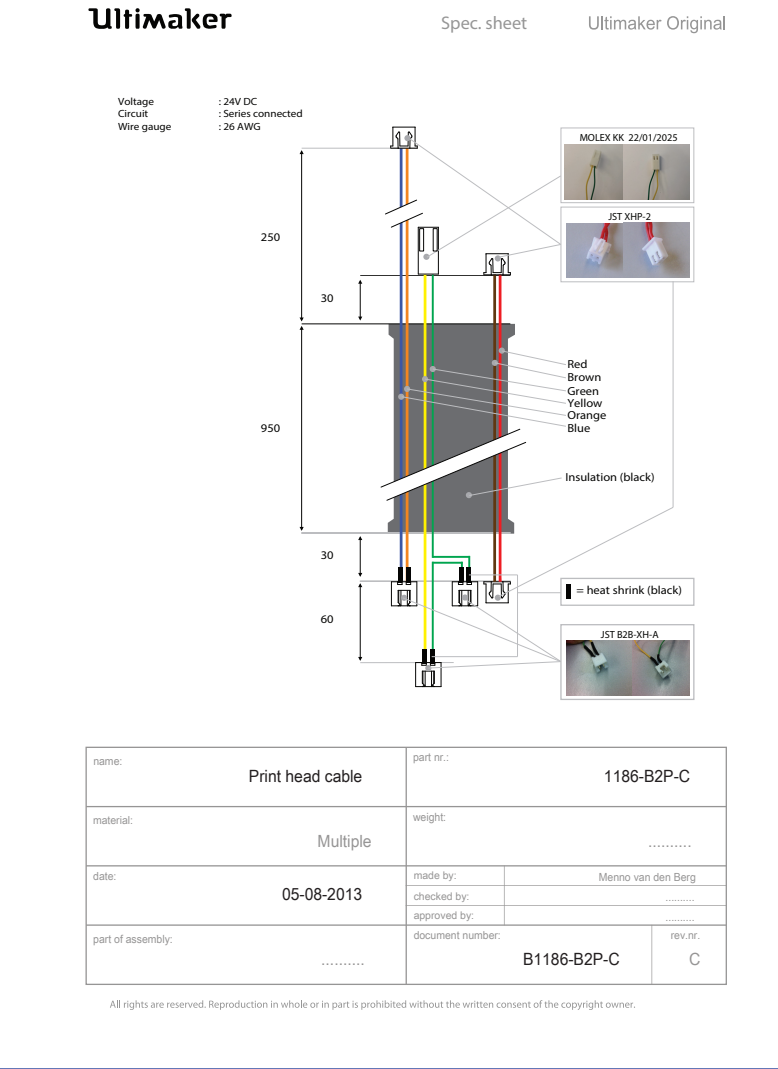
[picture p102: page 1]
name:; material:; date:; part of assembly:; document number:; rev.nr.; part nr.:; weight:; made by: checked by: approved by:; Multiple; Voltage; Circuit; : Series connected; Wire gauge; : 26 AWG; Red; Insulation (black); Brown Green Yellow Orange Blue; MOLEX KK 22/01/2025; JST XHP-2; JST B2B-XH-A

= heat shrink (black)

Print head cable

Menno van den Berg
