Ultimaker/Ultimaker2/1173_Print_Head_Shaft_Y_(x1)/B1173-B2P-A.pdf

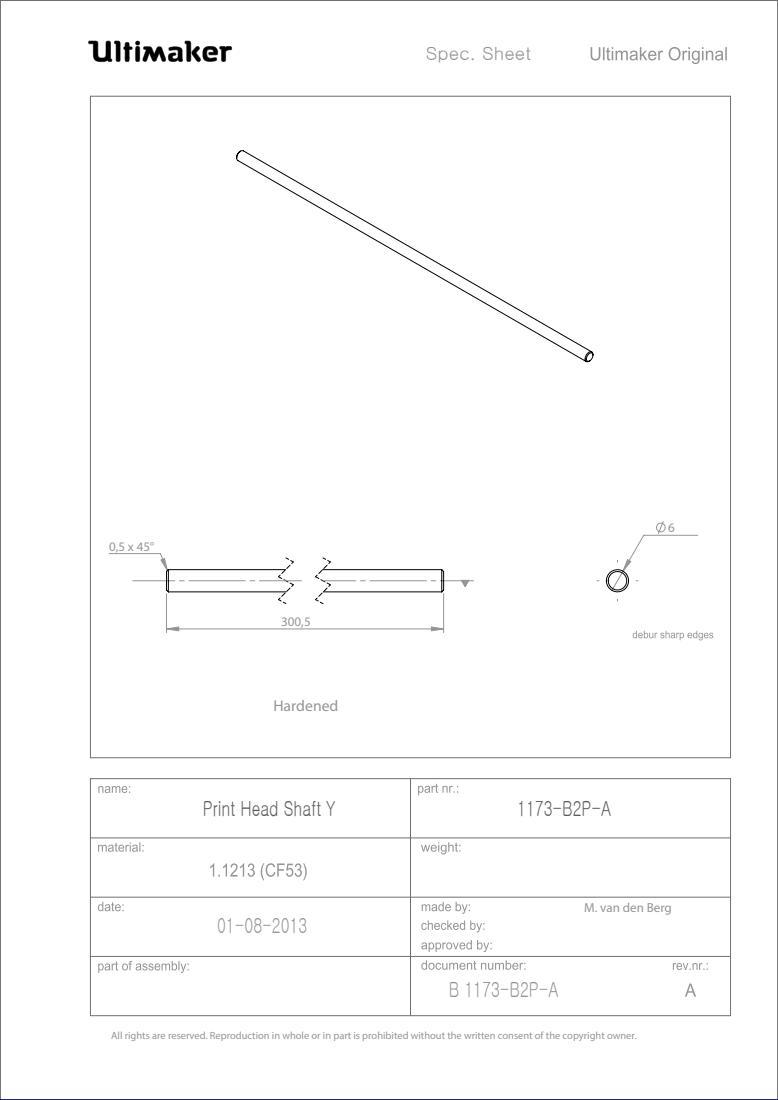
[picture p103: page 1]
Print Head Shaft Y; Spec. Sheet

M. van den Berg

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
