Ultimaker/Ultimaker2/1172_Print_Head_Shaft_X_(x1)/B1172-B2P-A.pdf

## Base document

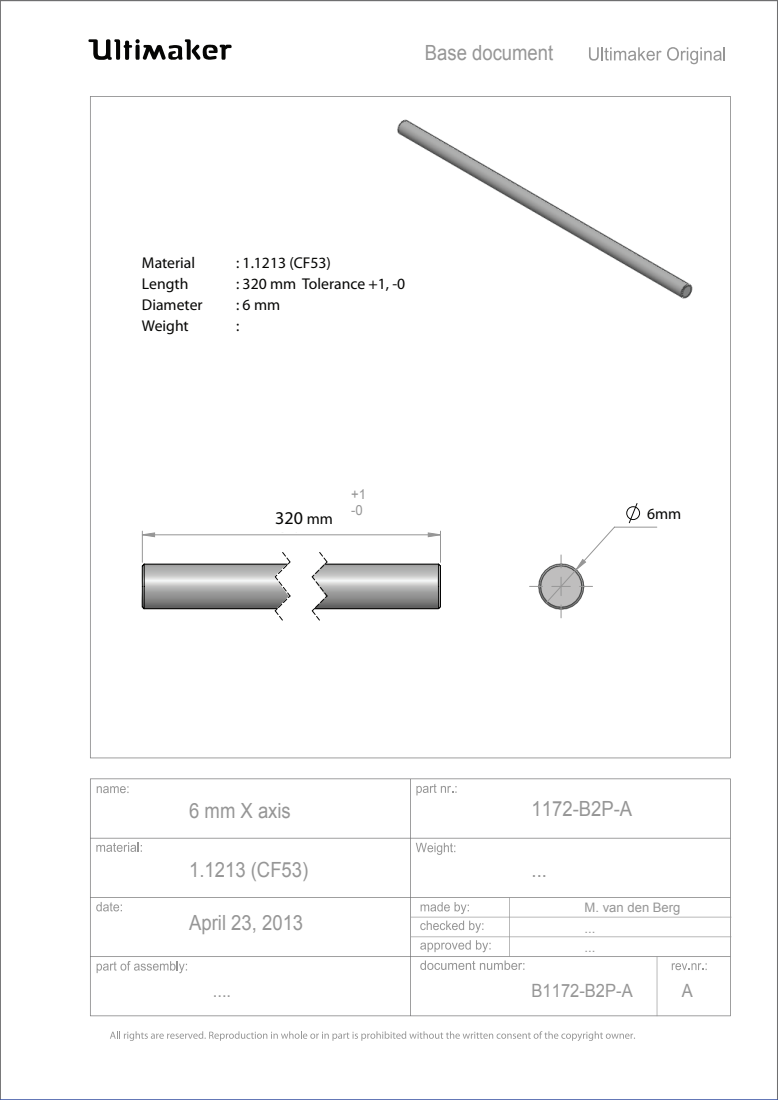
[picture p104: page 1]
April 23, 2013; 6 mm X axis; M. van den Berg ... ...; Material; Length; : 320 mm Tolerance +1, -0; Diameter; Weight
