Ultimaker/Ultimaker2/1157_Print_Table_Back_Cover_(x1)/B1157-B2P-A.PDF

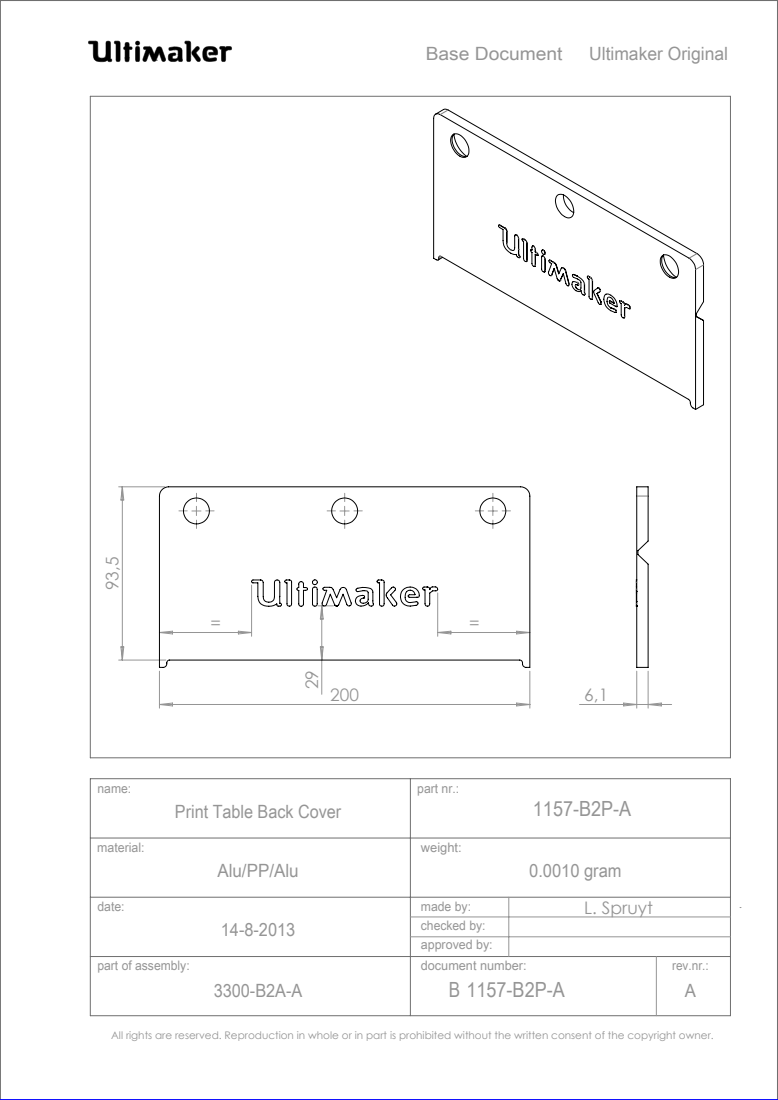
[picture p105: page 1]
Alu/PP/Alu; 0.0010 gram; Ultimaker Original; part of assembly:; rev.nr.:; part nr.:; made by:; Base Document; approved by:; checked by:; L. Spruyt; document number: B 1157-B2P-A

Print Table Back Cover

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
