Ultimaker/Ultimaker2/1155_Print_Table_Heated_Bed_(x1)/B1155-B2P-A.PDF

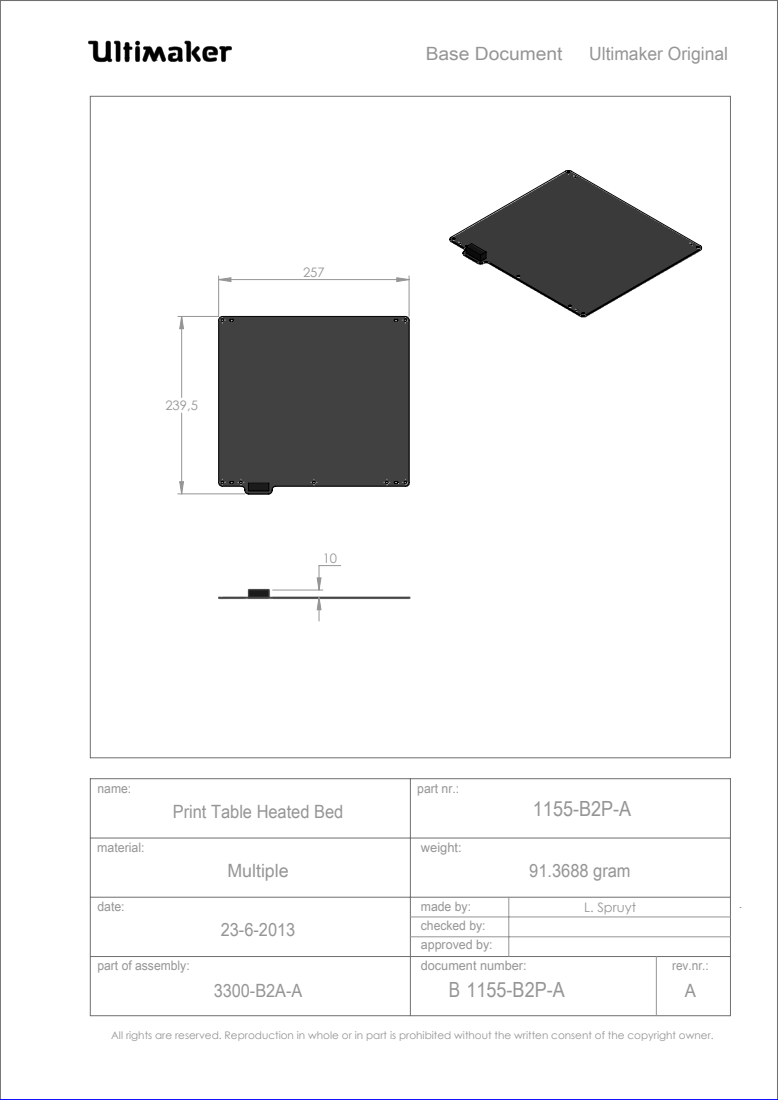
[picture p106: page 1]
Multiple; 91.3688 gram; Ultimaker Original; part of assembly:; rev.nr.:; part nr.:; made by:; Base Document; approved by:; checked by:; L. Spruyt; document number: B 1155-B2P-A

name:
Print Table Heated Bed

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
