Ultimaker/Ultimaker2/1154_Print_Table_Glass_(x1)/B1154-B2P-A.PDF

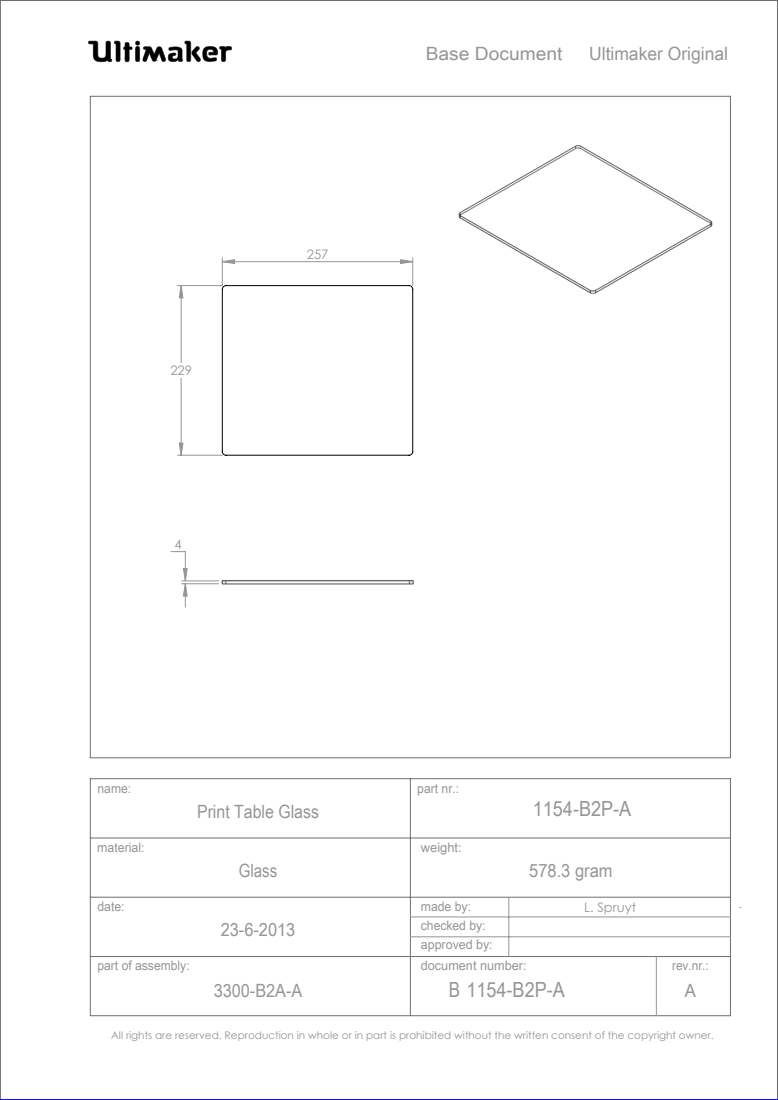
[picture p107: page 1]
Glass; 578.3 gram; Ultimaker Original; part of assembly:; rev.nr.:; part nr.:; made by:; Base Document; approved by:; checked by:; L. Spruyt; document number: B 1154-B2P-A

Print Table Glass

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
