Ultimaker/Ultimaker2/1153_Print_Table_Base_Plate_(x1)/B1153-B2P-B.PDF

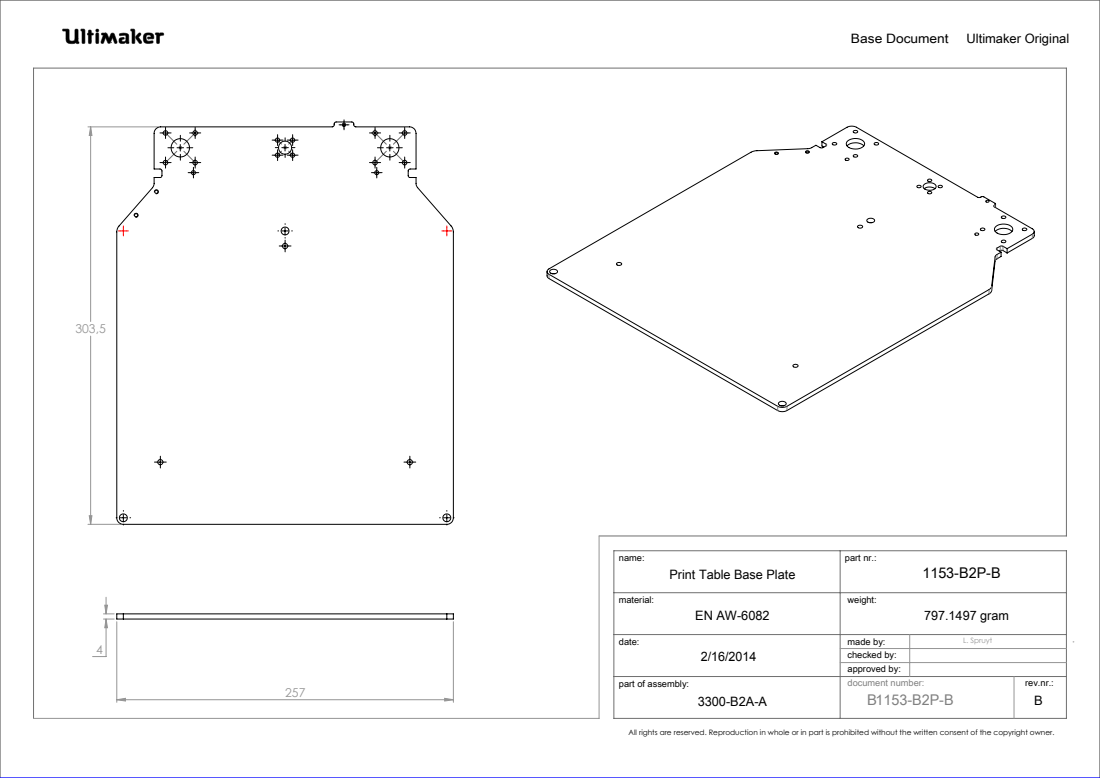
[picture p108: page 1]
797.1497 gram; Ultimaker Original; part of assembly:; rev.nr.:; part nr.:; made by:; Base Document; approved by:; checked by:; L. Spruyt; document number:

name:
Print Table Base Plate

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
