Ultimaker/Ultimaker2/1074_Print_Head_Thumb_screw_(x4)/B1074-Z2P-B.PDF

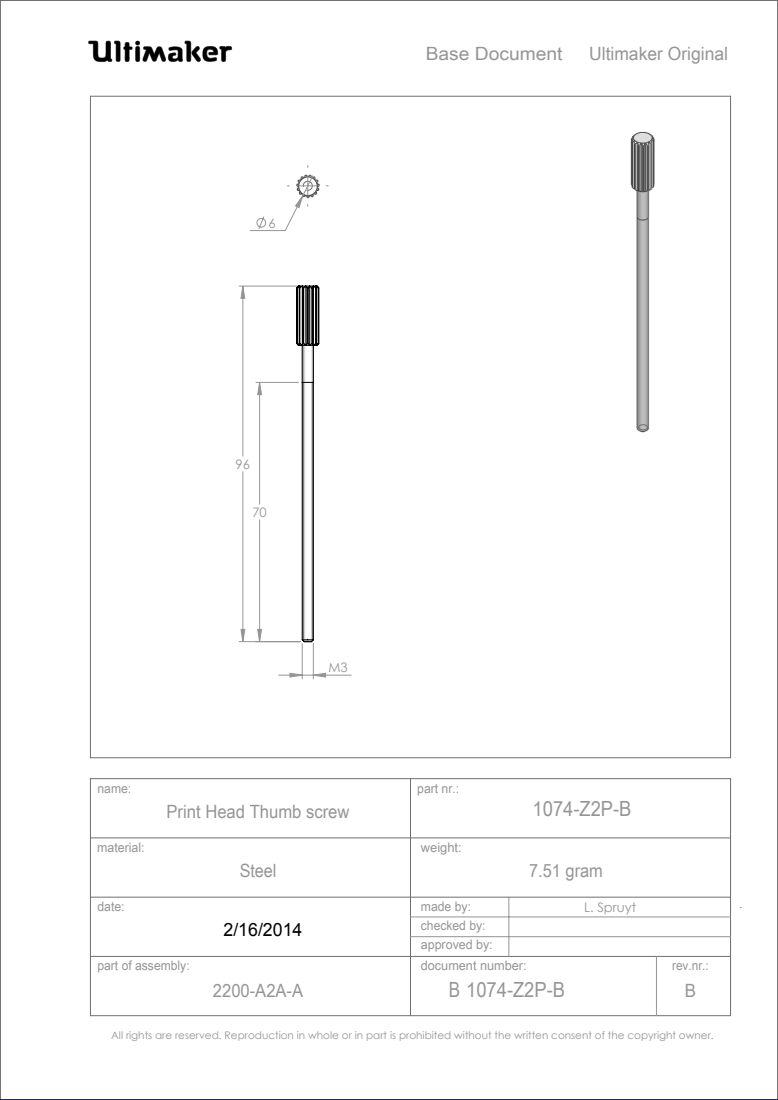
[picture p109: page 1]
Steel; 7.51 gram; Ultimaker Original; part of assembly:; rev.nr.:; part nr.:; made by:; Base Document; approved by:; checked by:; L. Spruyt; document number: B 1074-Z2P-B

name:
Print Head Thumb screw

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
