Ultimaker/Ultimaker2/1281_Braided_Sleeve_Clip_(x5)/1281.PDF

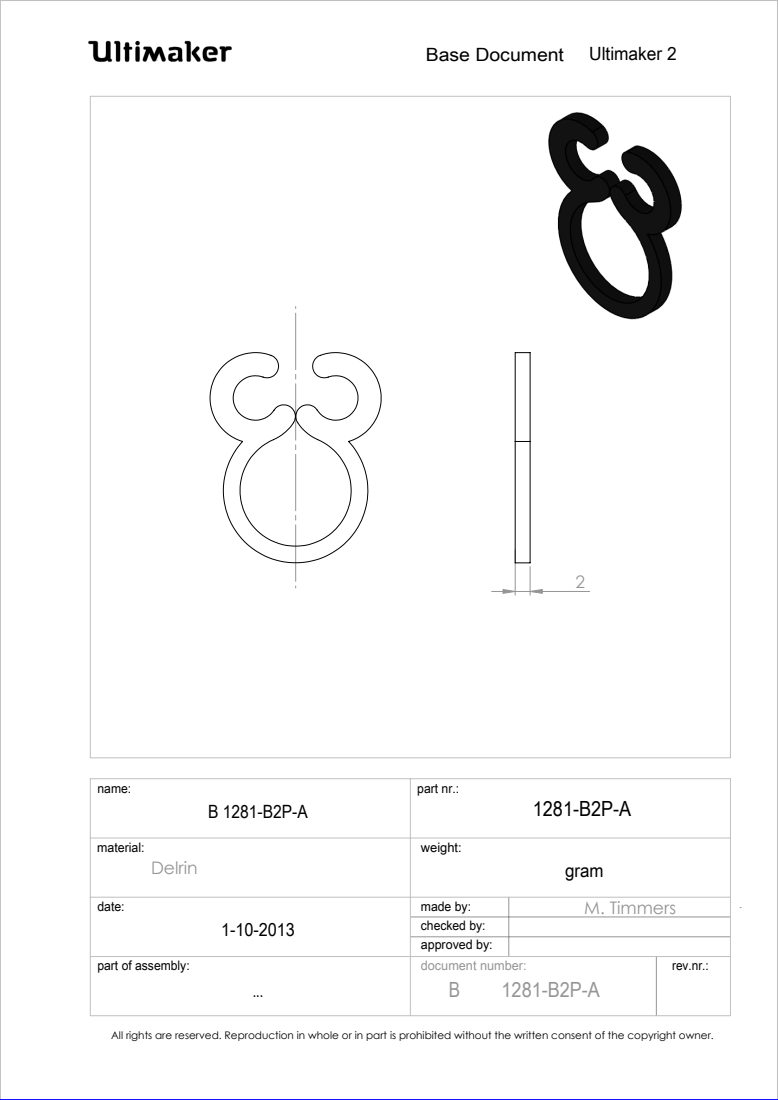
[picture p110: page 1]
Ultimaker 2; part of assembly:; rev.nr.:; part nr.:; made by:; Base Document; approved by:; checked by:; M. Timmers; document number:

All rights are reserved. Reproduction in whole or in part is prohibited without the written consent of the copyright owner.

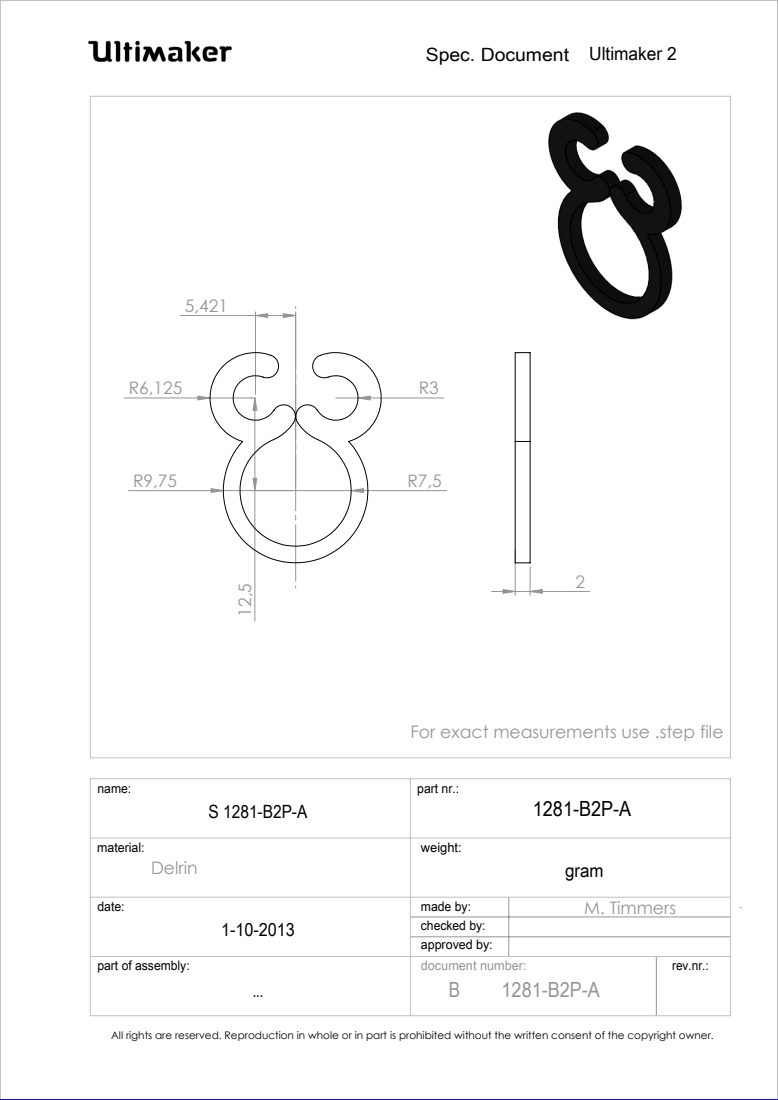
[picture p111: page 2]
Ultimaker 2; part of assembly:; rev.nr.:; part nr.:; made by:; Spec. Document; approved by:; checked by:; M. Timmers; document number:

For exact measurements use .step file

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
