Ultimaker/Ultimaker2/1402_Hex_Key_Wrench_2.5_(x1)/B1402-Z1P-A.PDF

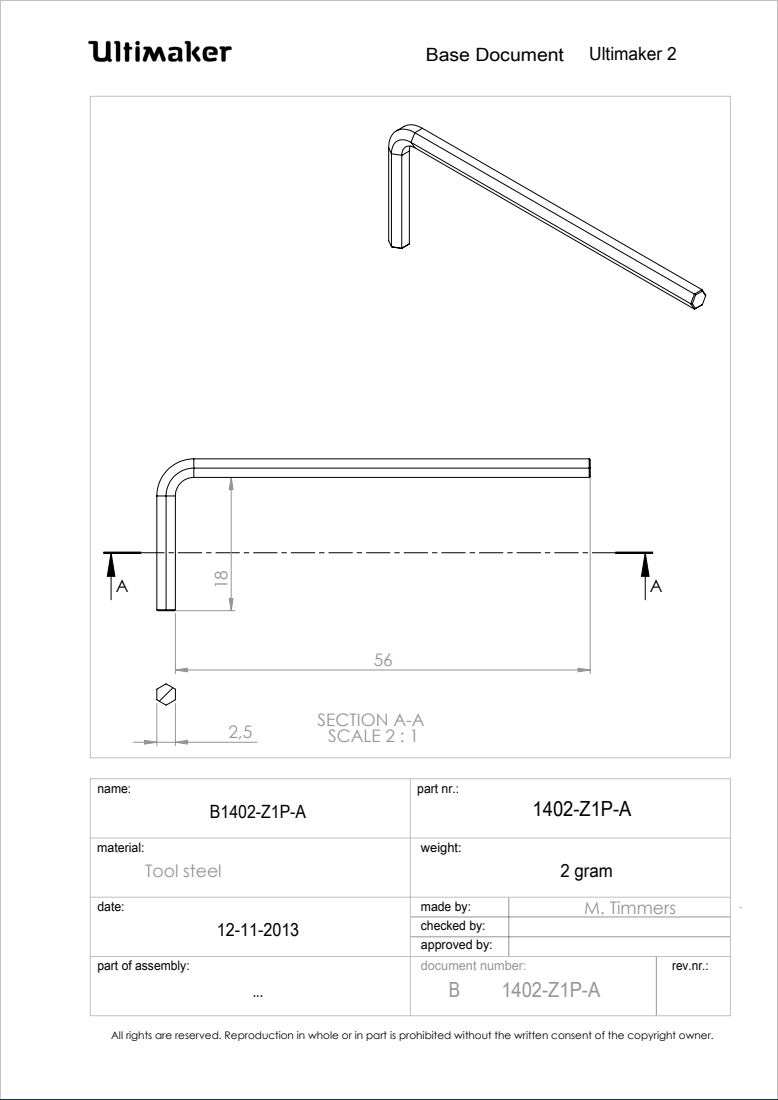
[picture p112: page 1]
SECTION A-A; SCALE 2 : 1; 2 gram; Ultimaker 2; part of assembly:; rev.nr.:; part nr.:; made by:; Base Document; approved by:; checked by:; M. Timmers; document number:; Tool steel

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
