Ultimaker/Ultimaker2/1352_Set_Screw_M3x14_(x1)/B1352-B2P-A.pdf

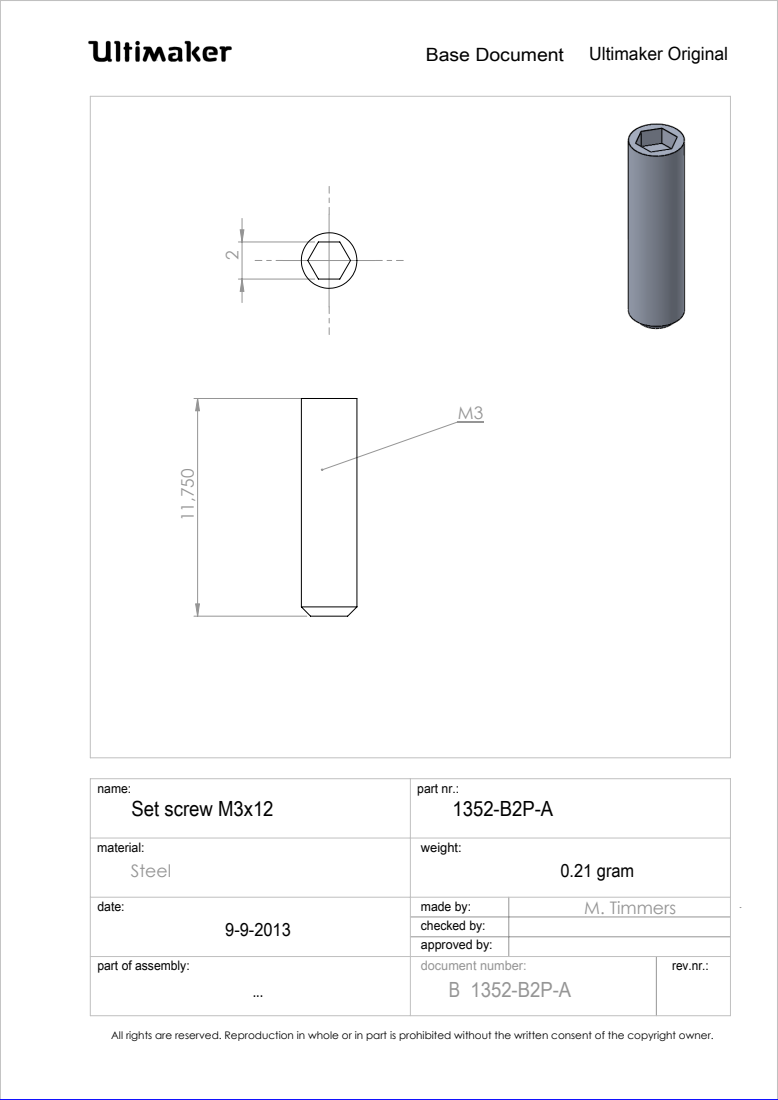
[picture p113: page 1]
0.21 gram; Ultimaker Original; part of assembly:; rev.nr.:; part nr.:; made by:; Base Document; approved by:; checked by:; M. Timmers; document number: B 1352-B2P-A; Set screw M3x12

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
