Ultimaker/Ultimaker2/1351_ISO_4762_M2,5x10_(x2)/B1351-B2P-A.pdf

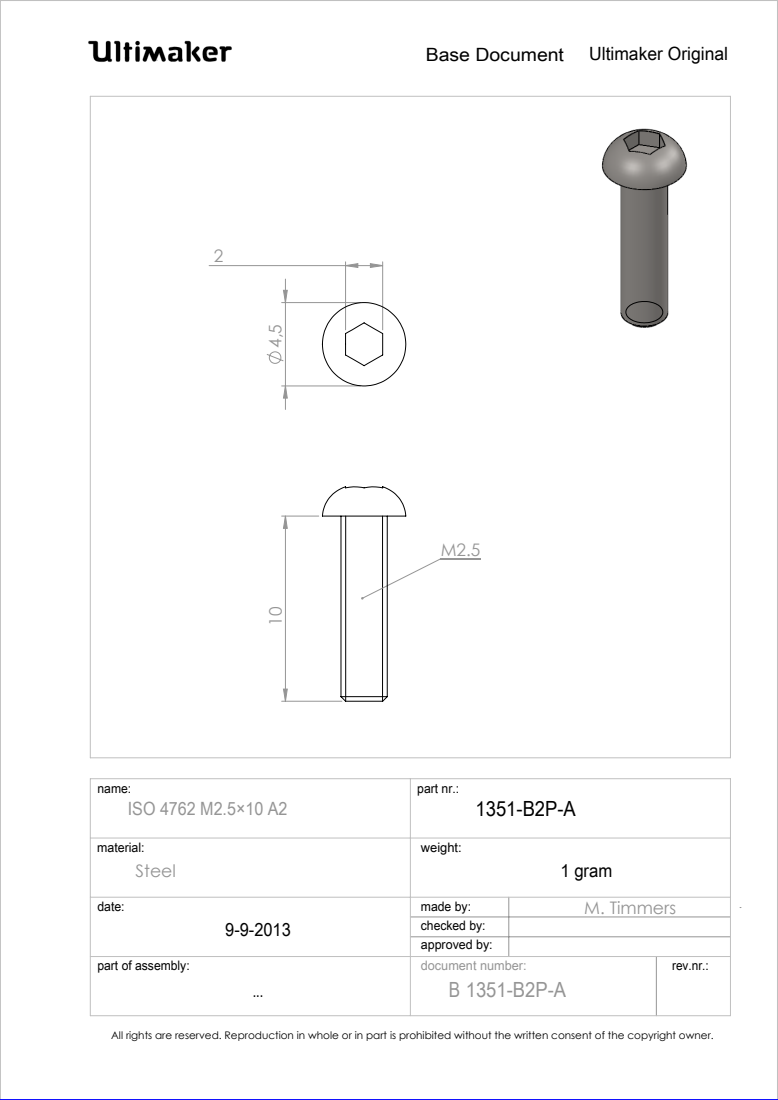
[picture p114: page 1]
1 gram; Ultimaker Original; part of assembly:; rev.nr.:; part nr.:; made by:; Base Document; approved by:; checked by:; M. Timmers; document number: B 1351-B2P-A; ISO 4762 M2.5×10 A2

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
