Ultimaker/Ultimaker2/1348_ISO_7380_M3x4_A2_(x4)/B1348-B2P-A.pdf

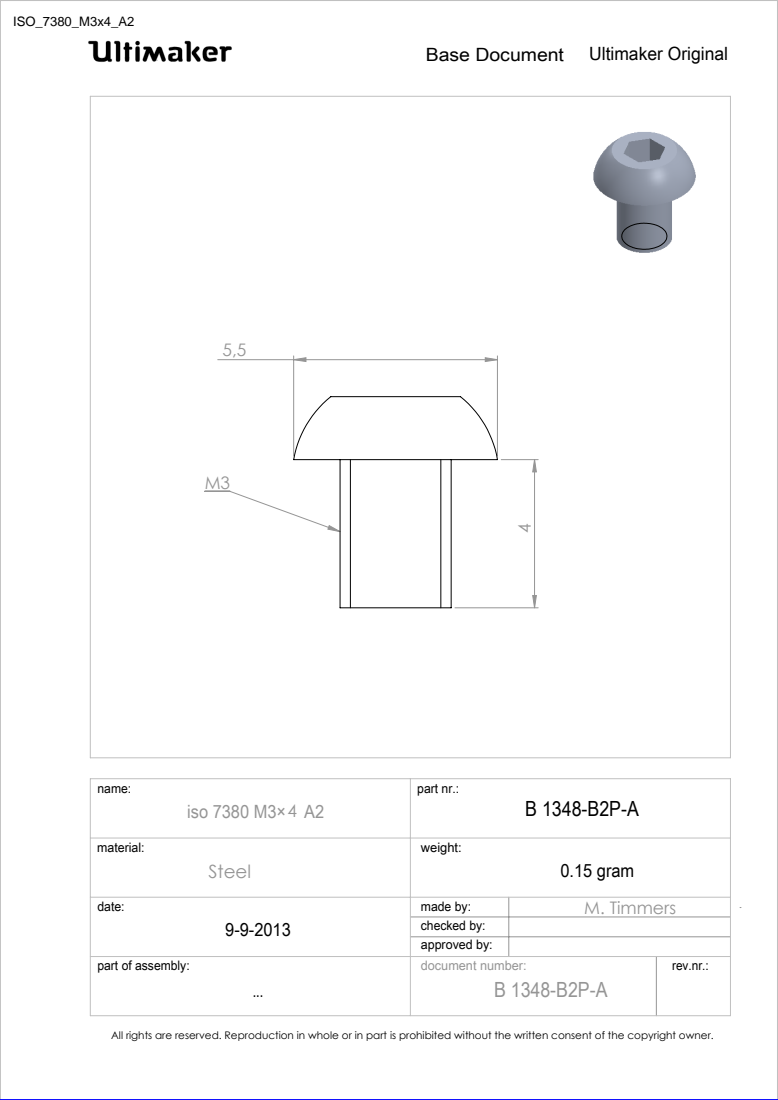
[picture p115: page 1]
0.15 gram; Ultimaker Original; part of assembly:; rev.nr.:; part nr.:; made by:; Base Document; approved by:; checked by:; M. Timmers; document number: B 1348-B2P-A; iso 7380 M3× A2 4

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
