Ultimaker/Ultimaker2/1330_Hot-end_Cooling_Fan_5VDC_0.08A_(x1)/B1330-Z1P-B Fan 25x25.PDF

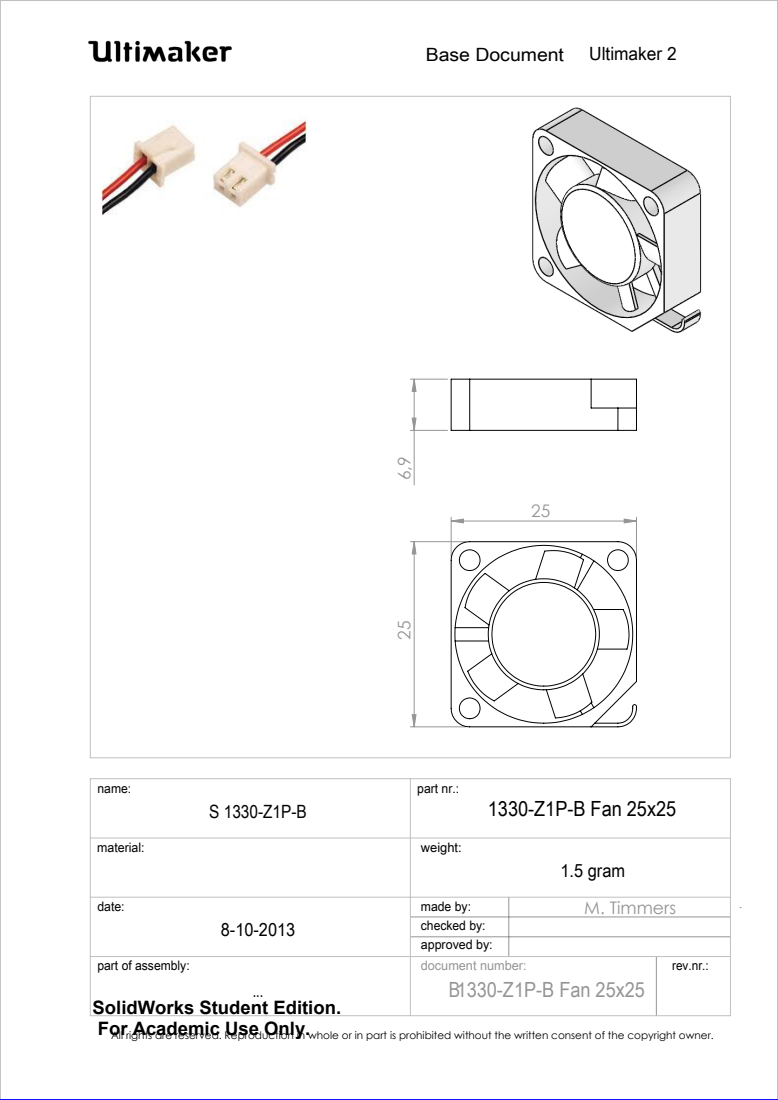
[picture p116: page 1]
1330-Z1P-B Fan 25x25; 1.5 gram; Ultimaker 2; part of assembly:; rev.nr.:; part nr.:; made by:; Base Document; approved by:; checked by:; M. Timmers; document number: B1330-Z1P-B Fan 25x25

SolidWorks Student Edition.
For Academic Use Only.
All rights are reserved. Reproduction in whole or in part is prohibited without the written consent of the copyright owner.
