Ultimaker/Ultimaker2/1329_Dual_fan_bracket_(x1)/B1329-B2P-C.pdf

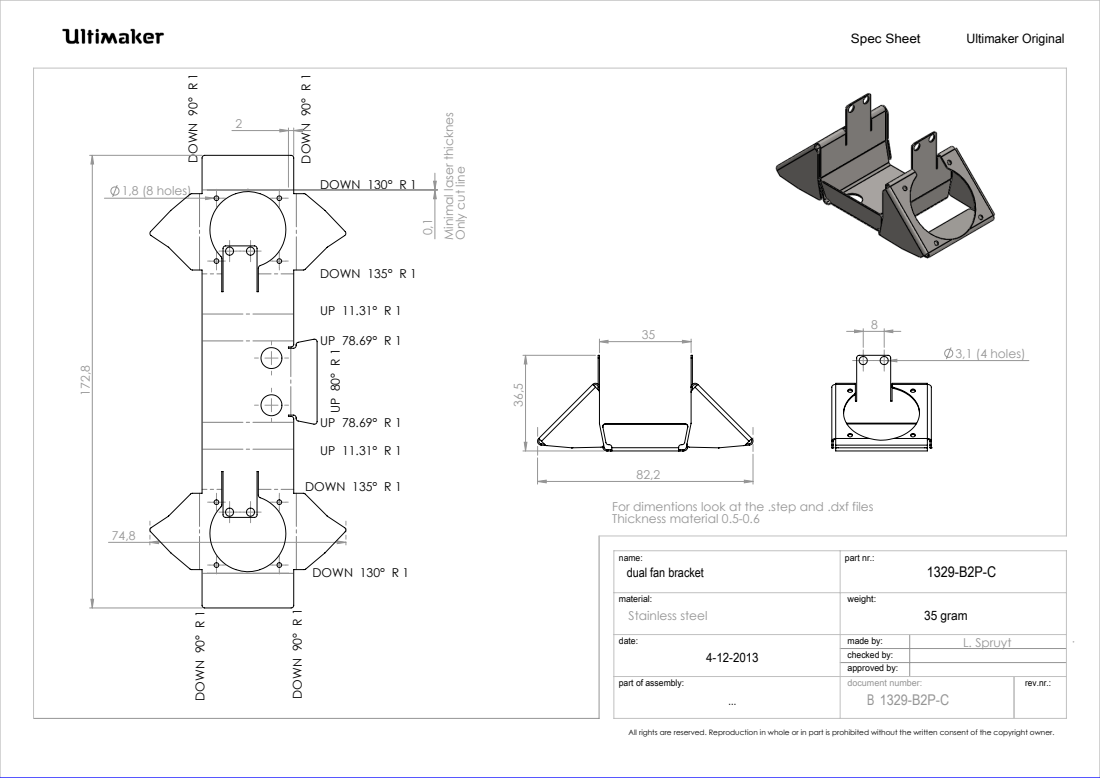
[picture p117: page 1]
1,8 (8 holes); DOWN 90° R 1; DOWN 130° R 1; DOWN 135° R 1 UP 80° R 1; DOWN 135° R 1; 3,1 (4 holes); 35 gram; Ultimaker Original; part of assembly:; rev.nr.:; part nr.:; made by:; Spec Sheet; approved by:; checked by:; L. Spruyt; document number: B 1329-B2P-C; Stainless steel

Minimal laser thicknes

Only cut line

For dimentions look at the .step and .dxf files
Thickness material 0.5-0.6

name:
dual fan bracket

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
