Ultimaker/Ultimaker2/1313_Model_Cooling_Fan_12VDC_0.1_A_(x2)/B1313-Z1P-A.pdf

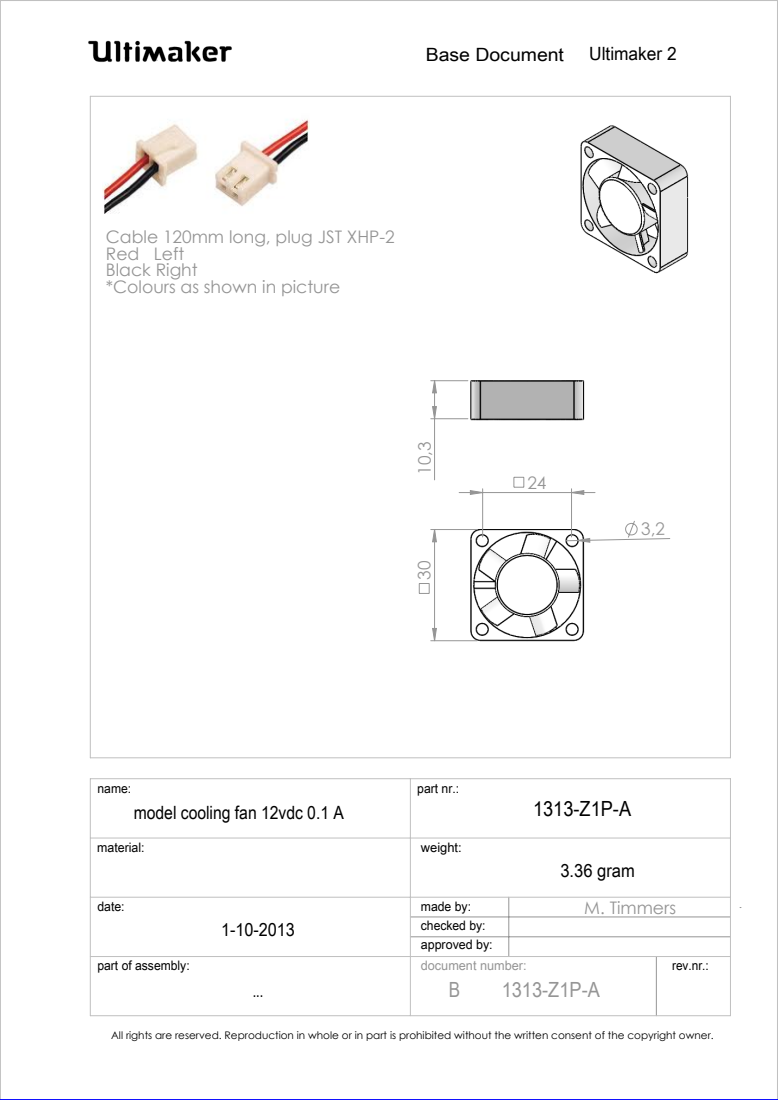
[picture p118: page 1]
3.36 gram; Ultimaker 2; part of assembly:; rev.nr.:; part nr.:; made by:; Base Document; approved by:; checked by:; M. Timmers; document number:

Cable 120mm long, plug JST XHP-2
Red Left
Black Right
*Colours as shown in picture

name:
model cooling fan 12vdc 0.1 A

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
