Ultimaker/Ultimaker2/1311_Spring_D2000_(x1)/B1311-Z2P-A.pdf

10,700

Buitendiam.

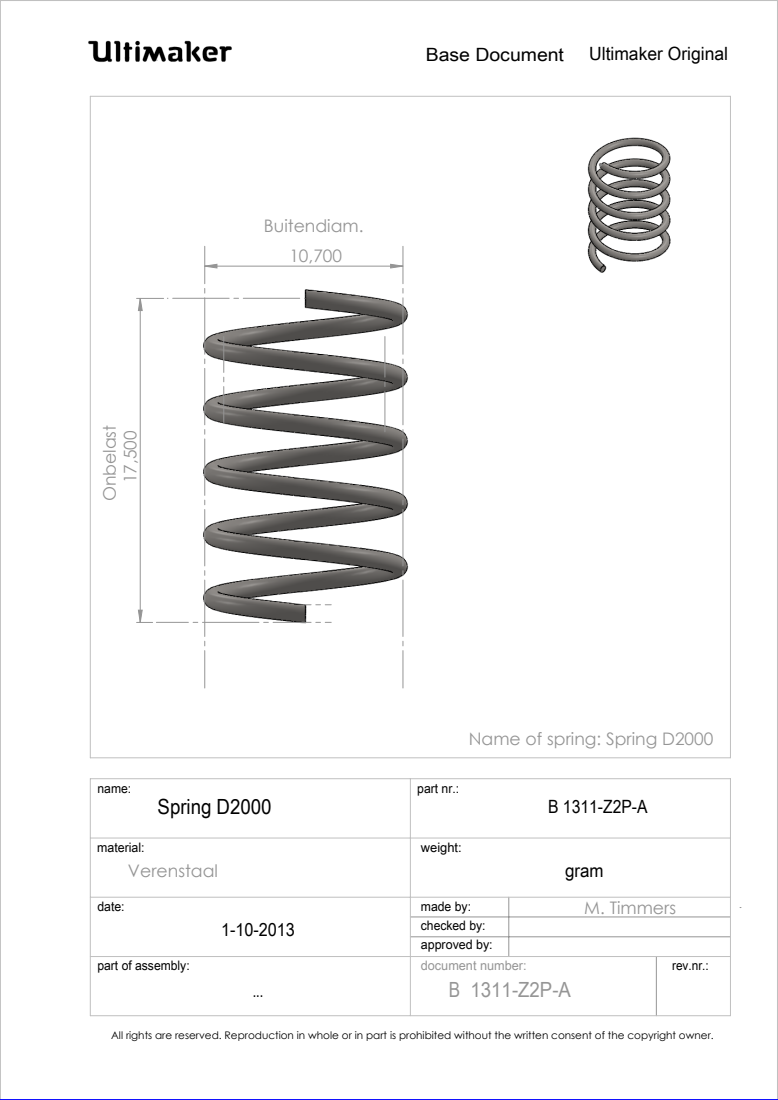
[picture p119: page 1]
Onbelast; Spring D2000; gram; Ultimaker Original; name:; material:; date:; part of assembly:; rev.nr.:; part nr.:; made by:; weight:; Base Document; approved by:; checked by:; M. Timmers; document number: B 1311-Z2P-A; Verenstaal

Name of spring: Spring D2000

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
