Ultimaker/Ultimaker2/1310_Hot_end_Isolator_(x1)/B1310-Z2P-A Hot end Isolator.PDF

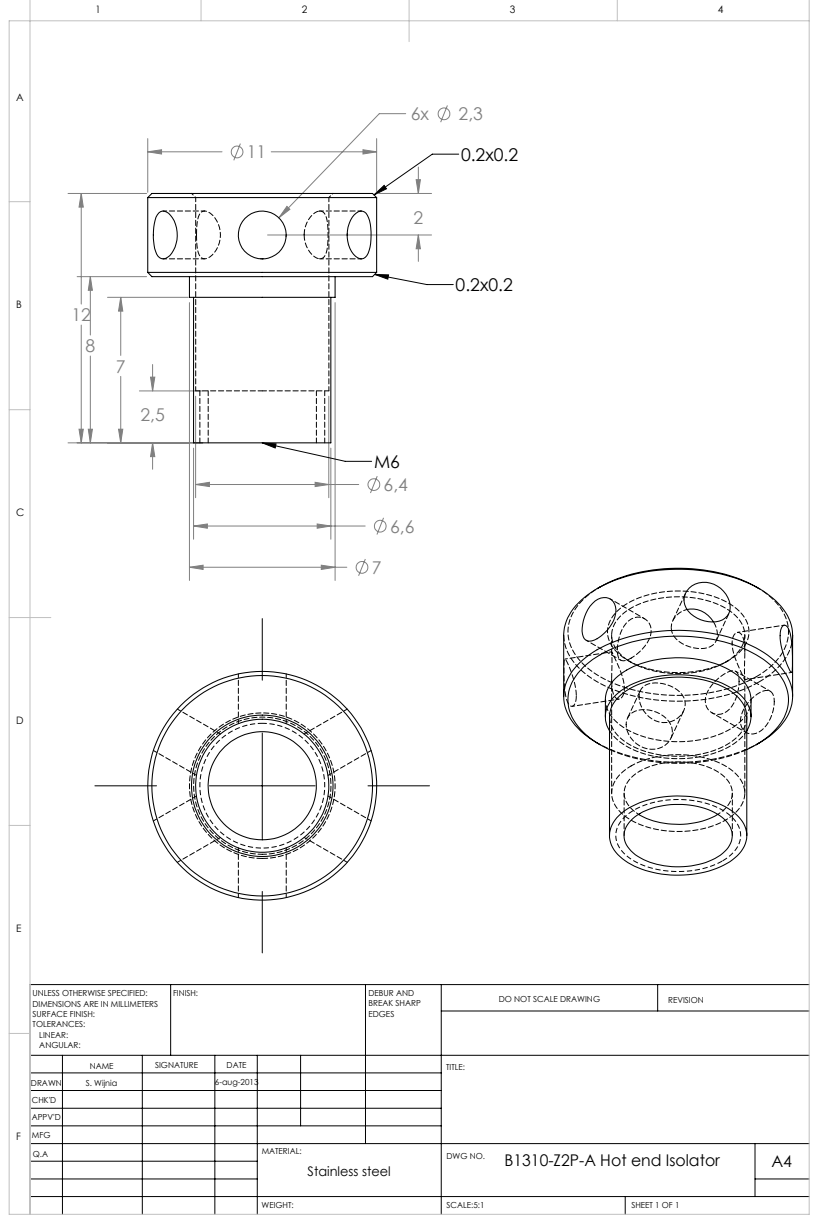
[picture p120: page 1]
SCALE:5:1; SHEET 1 OF 1; DO NOT SCALE DRAWING; REVISION; DEBUR AND BREAK SHARP; UNLESS OTHERWISE SPECIFIED:; FINISH:

DIMENSIONS ARE IN MILLIMETERS
SURFACE FINISH:
TOLERANCES:
LINEAR:
ANGULAR:

NAME | SIGNATURE | DATE | | | | TITLE:

DRAWN | S. Wijnia | | 6-aug-2013
CHK'D
APPV'D
MFG
Q.A | | | | MATERIAL: Stainless steel | DWG NO. B1310-Z2P-A Hot end Isolator | A4
