Ultimaker/Ultimaker2/1309_PTFE_Isolator_Coupler_3.2_mm_(x1)/B1309-Z2P-B Hot End Isolator Coupler.PDF

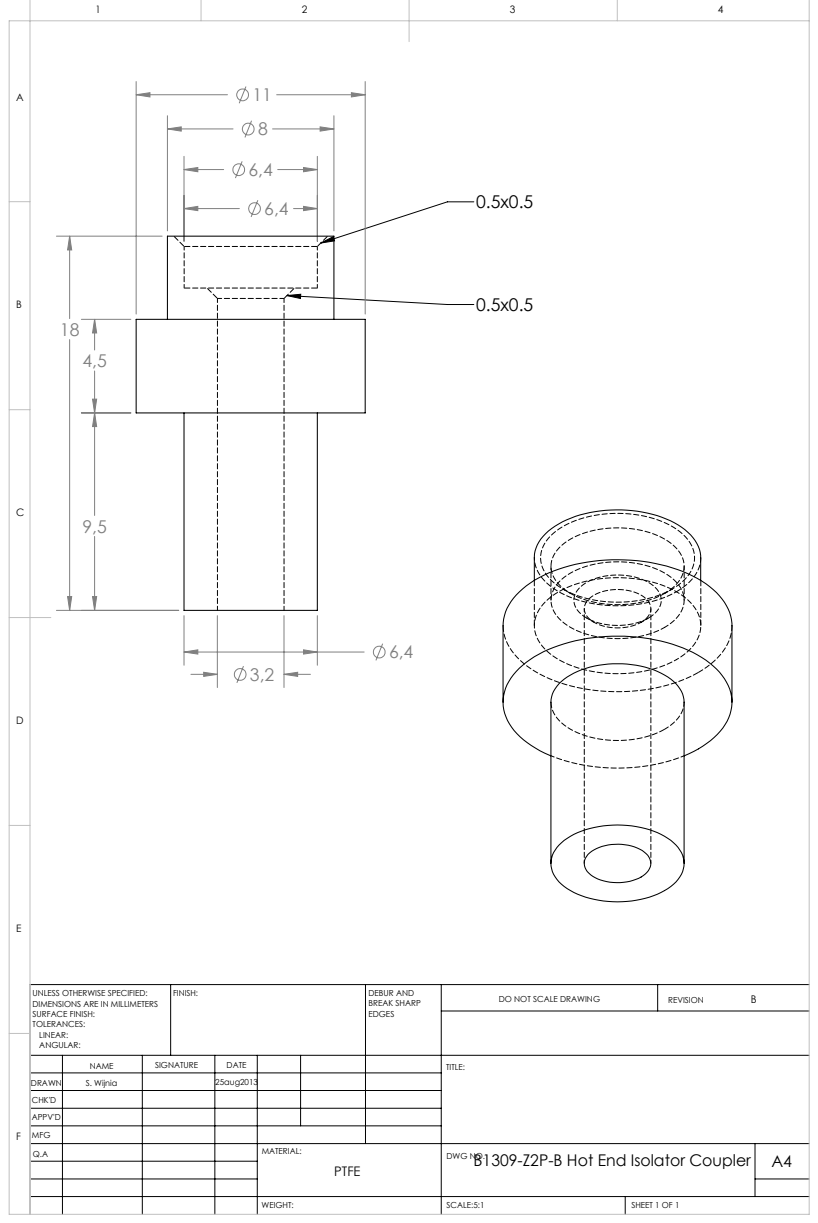
[picture p121: page 1]
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

DIMENSIONS ARE IN MILLIMETERS
SURFACE FINISH:
TOLERANCES:
LINEAR:
ANGULAR:

NAME | SIGNATURE | DATE | | | | TITLE:

DRAWN | S. Wijnia | | 25aug2013
CHK'D
APPV'D
MFG
Q.A | | | | MATERIAL: PTFE | DWG NO. B1309-Z2P-B Hot End Isolator Coupler | A4
