Ultimaker/Ultimaker2/1306_Hot_end_holder_bottom_(x1)/B1306-Z2P-B hot end holder bottom.PDF

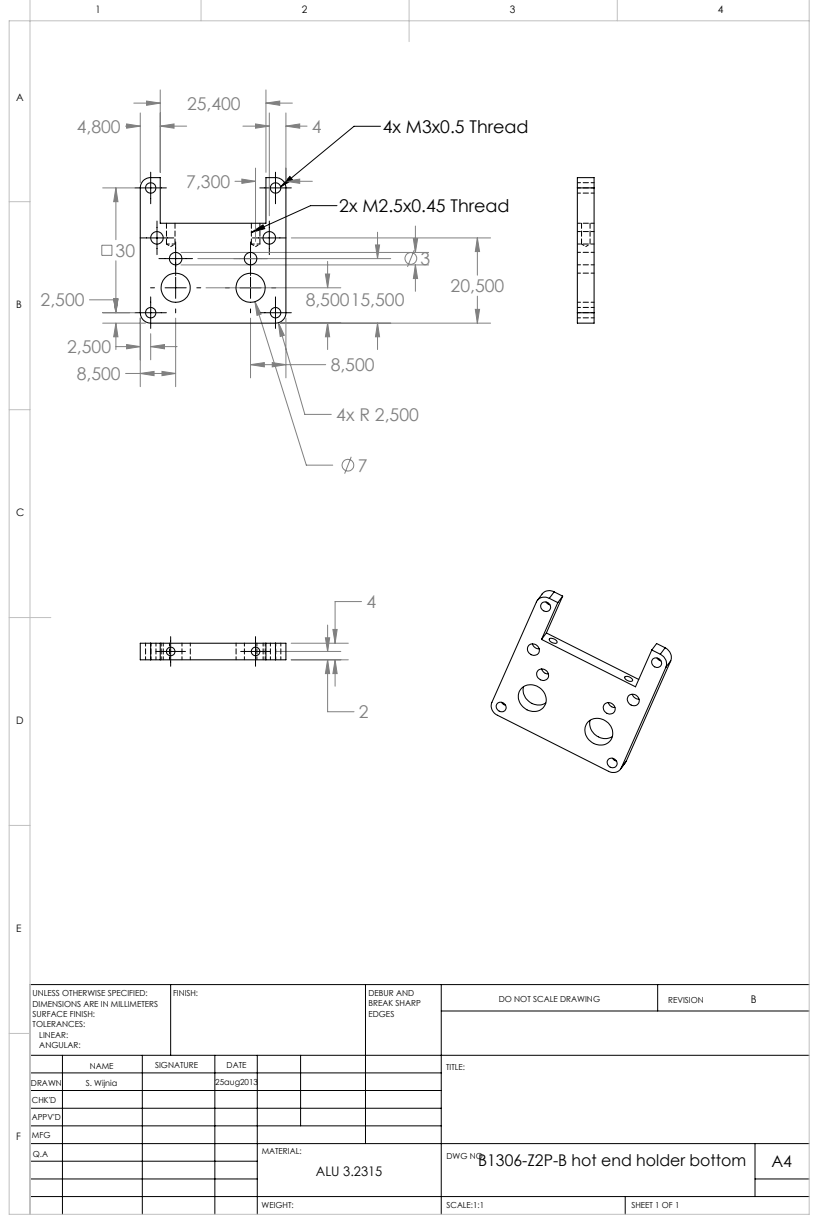
[picture p122: page 1]
2x M2.5x0.45 Thread; 4x M3x0.5 Thread; SCALE:1:1; SHEET 1 OF 1; DO NOT SCALE DRAWING; REVISION; DEBUR AND BREAK SHARP; UNLESS OTHERWISE SPECIFIED:; FINISH:

DIMENSIONS ARE IN MILLIMETERS
SURFACE FINISH:
TOLERANCES:
LINEAR:
ANGULAR:

NAME | SIGNATURE | DATE | | | | TITLE:

DRAWN | S. Wijnia | | 25aug2013
CHK'D
APPV'D
MFG
Q.A | | | | MATERIAL: ALU 3.2315 | DWG NO. B1306-Z2P-B hot end holder bottom | A4
