Ultimaker/Ultimaker2/1288_Washer_M6_(x3)/B1288-Z1P-A.pdf

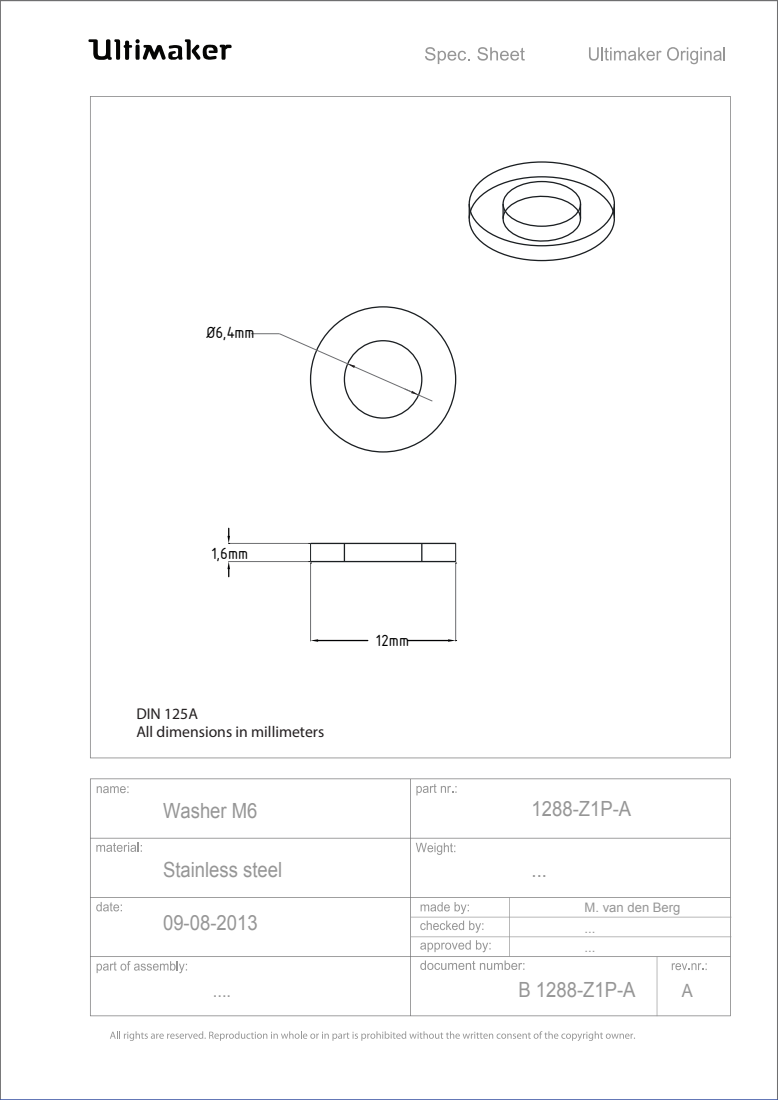
[picture p123: page 1]
Stainless steel; Washer M6; M. van den Berg ... ...

DIN 125A
All dimensions in millimeters
