Ultimaker/Ultimaker2/1273_Cable_Cover_(x2)/B1273-B2P-C.PDF

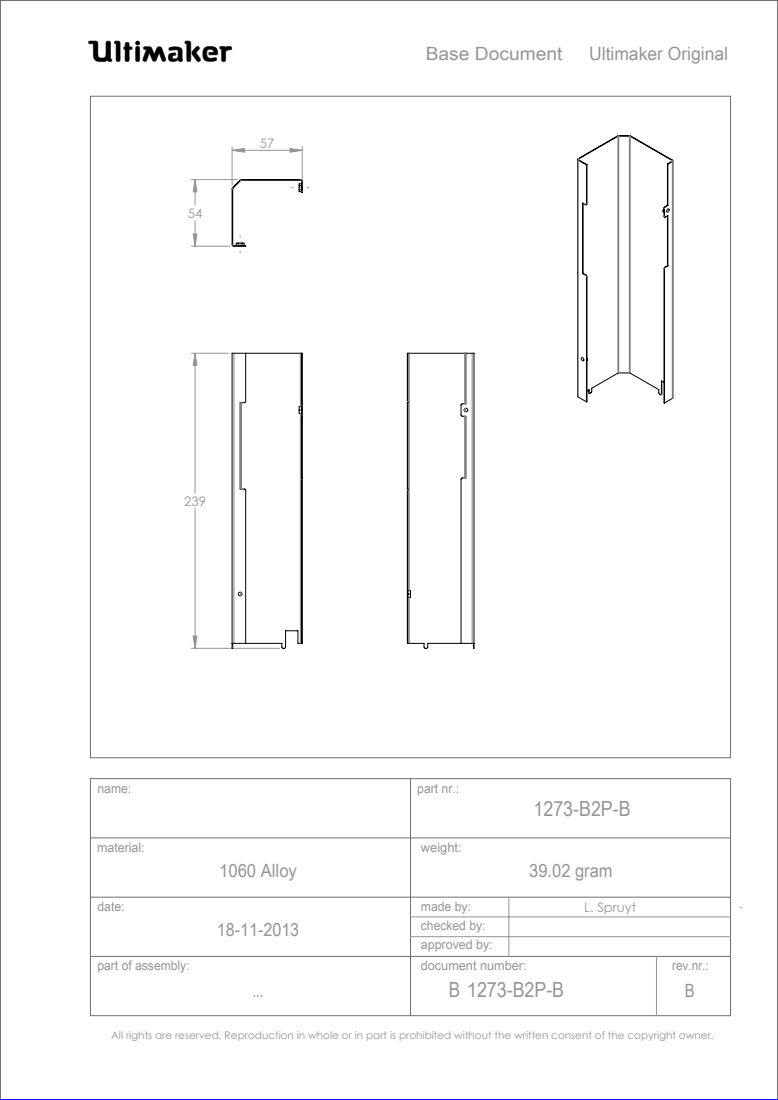
[picture p124: page 1]
1060 Alloy; 39.02 gram; Ultimaker Original; part of assembly:; rev.nr.:; part nr.:; made by:; Base Document; approved by:; checked by:; L. Spruyt; document number: B 1273-B2P-B

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
