Ultimaker/Ultimaker2/1272_Power_Cable_US_Type_C13_(x1)/B1272-Z1P-A.pdf

# Ultimaker Original Base Document

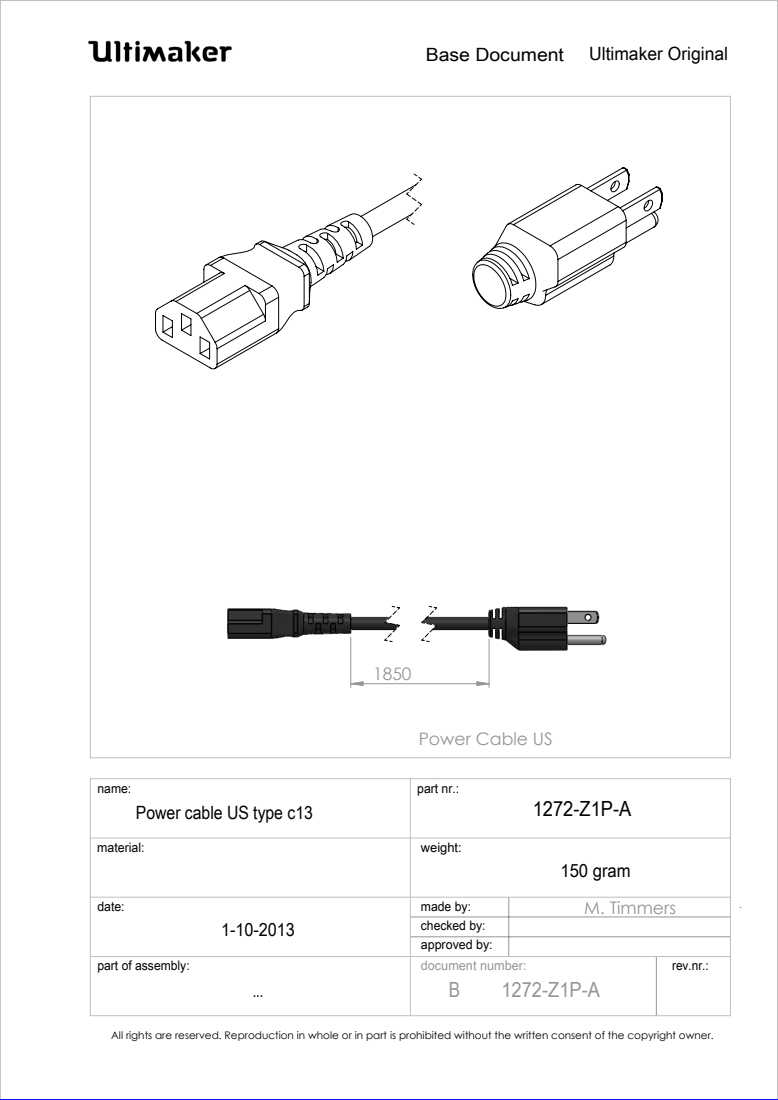
[picture p125: page 1]
150 gram; material:; date:; part of assembly:; rev.nr.:; part nr.:; made by:; weight:; approved by:; checked by:; M. Timmers; document number:

Power Cable US

name:
Power cable US type c13

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
