Ultimaker/Ultimaker2/1271_Power_Cable_AU_Type_C13_(x1)/B1271-Z1P-A.pdf

# Ultimaker 2 Base Document

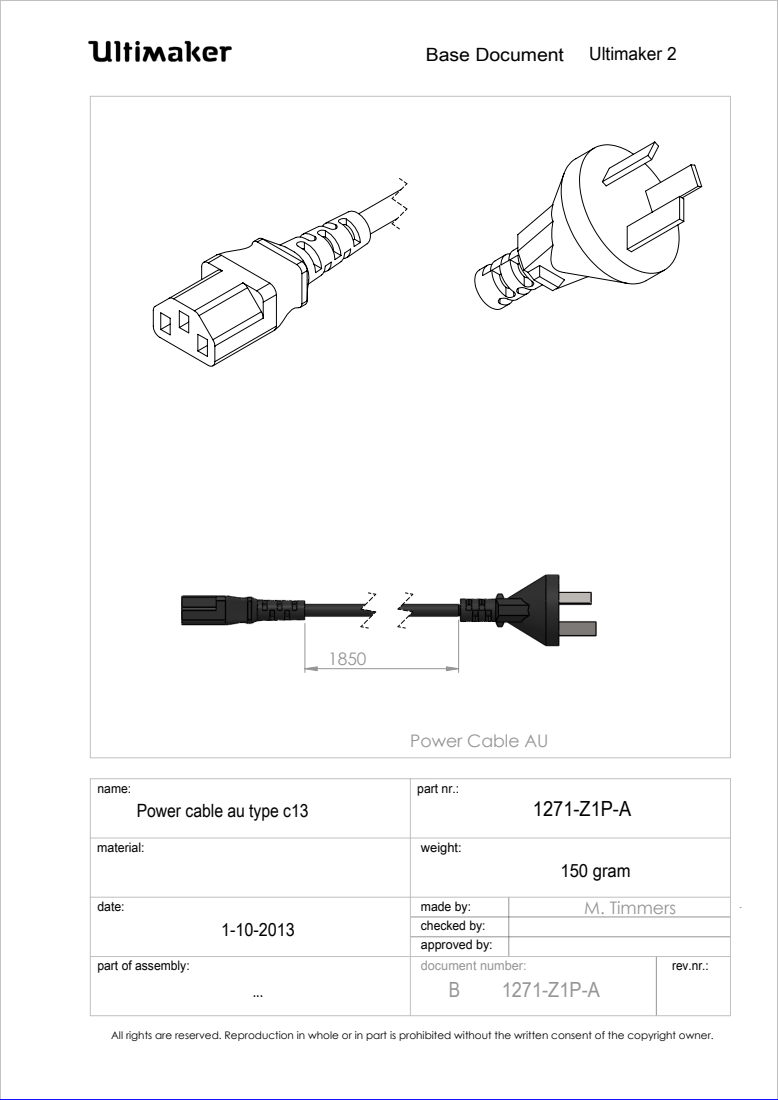
[picture p126: page 1]
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

Power Cable AU

name:
Power cable au type c13

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
