Ultimaker/Ultimaker2/1270_Power_Cable_UK_Type_C13_(x1)/B1270-Z1P-A.pdf

# Ultimaker 2 Base Document

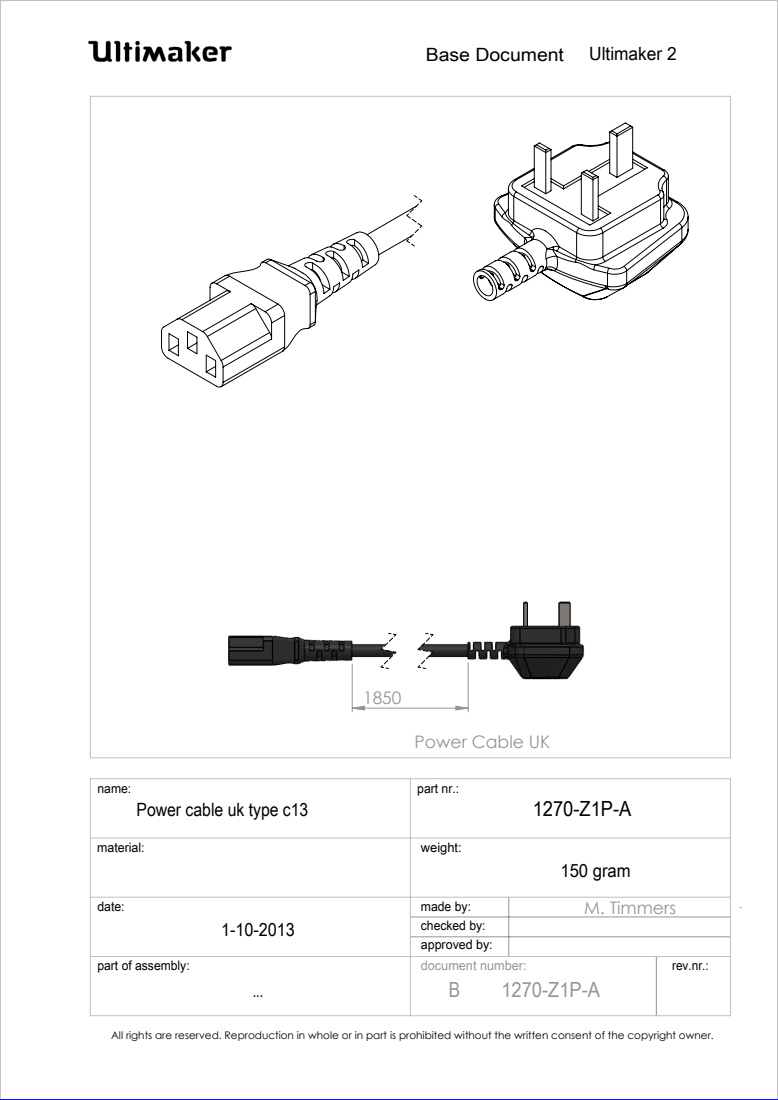
[picture p127: page 1]
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

Power Cable UK

name:
Power cable uk type c13

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
