Ultimaker/Ultimaker2/1269_Power_Cable_EU_Type_C13_(x1)/B1269-Z1P-A.pdf

# Ultimaker 2 Base Document

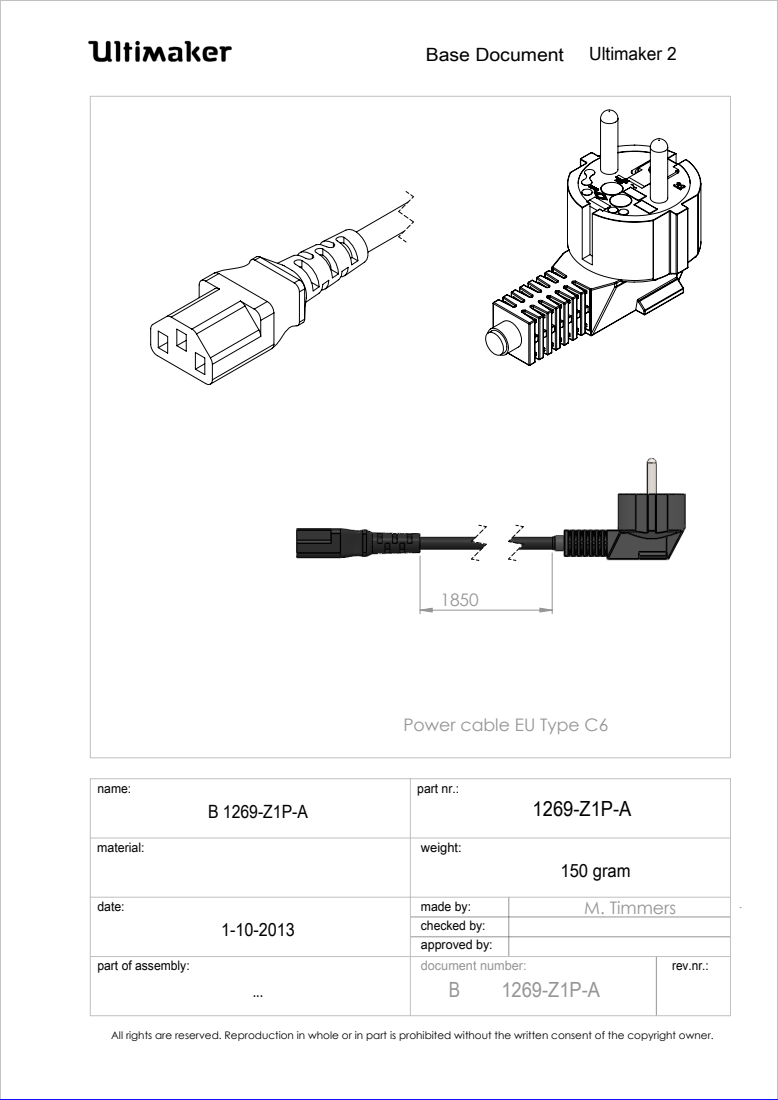
[picture p128: page 1]
150 gram; name:; material:; date:; part of assembly:; rev.nr.:; part nr.:; made by:; weight:; approved by:; checked by:; M. Timmers; document number:

Power cable EU Type C6

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
