Ultimaker/Ultimaker2/1268_Heater_Cartridge_24V_25W_(x1)/B1268-Z1P-A.pdf

# Ultimaker 2 Base Document

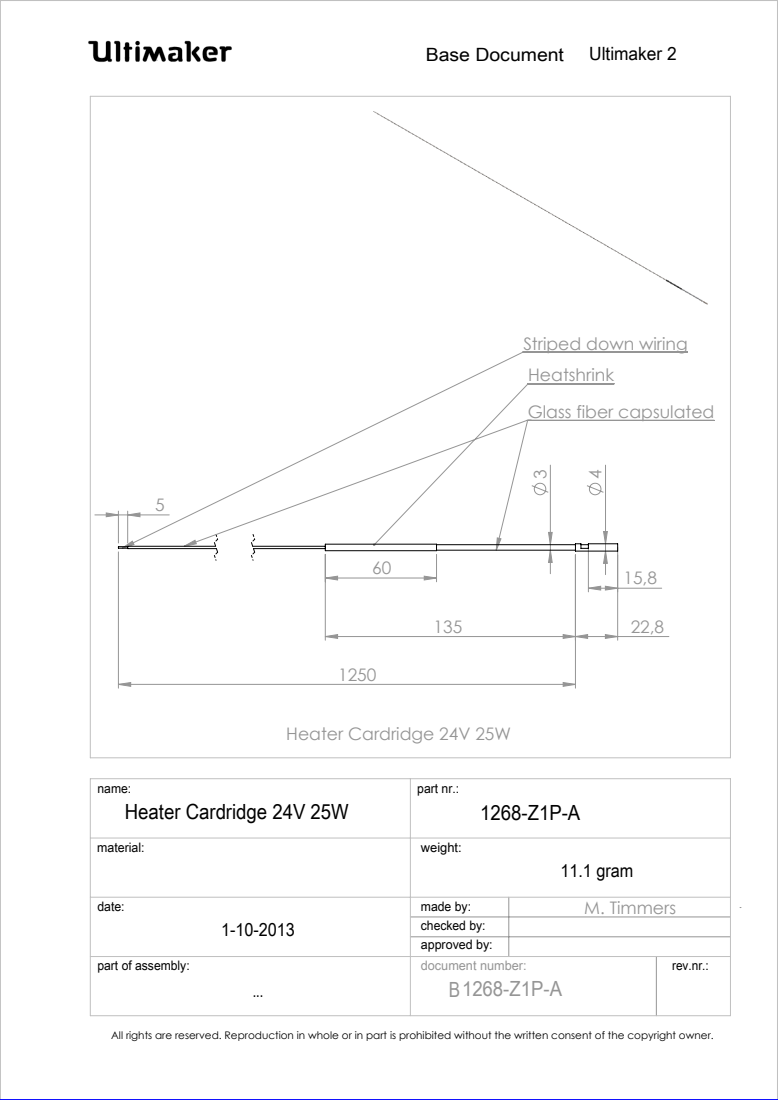
[picture p129: page 1]
Heater Cardridge 24V 25W; 11.1 gram; name:; material:; date:; part of assembly:; rev.nr.:; part nr.:; made by:; weight:; approved by:; checked by:; M. Timmers; document number: B1268-Z1P-A

Striped down wiring
Heatshrink
Glass fiber capsulated

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
