Ultimaker/Ultimaker2/1266_Bowden_tube_(x1)/B1266-Z2P-A.pdf

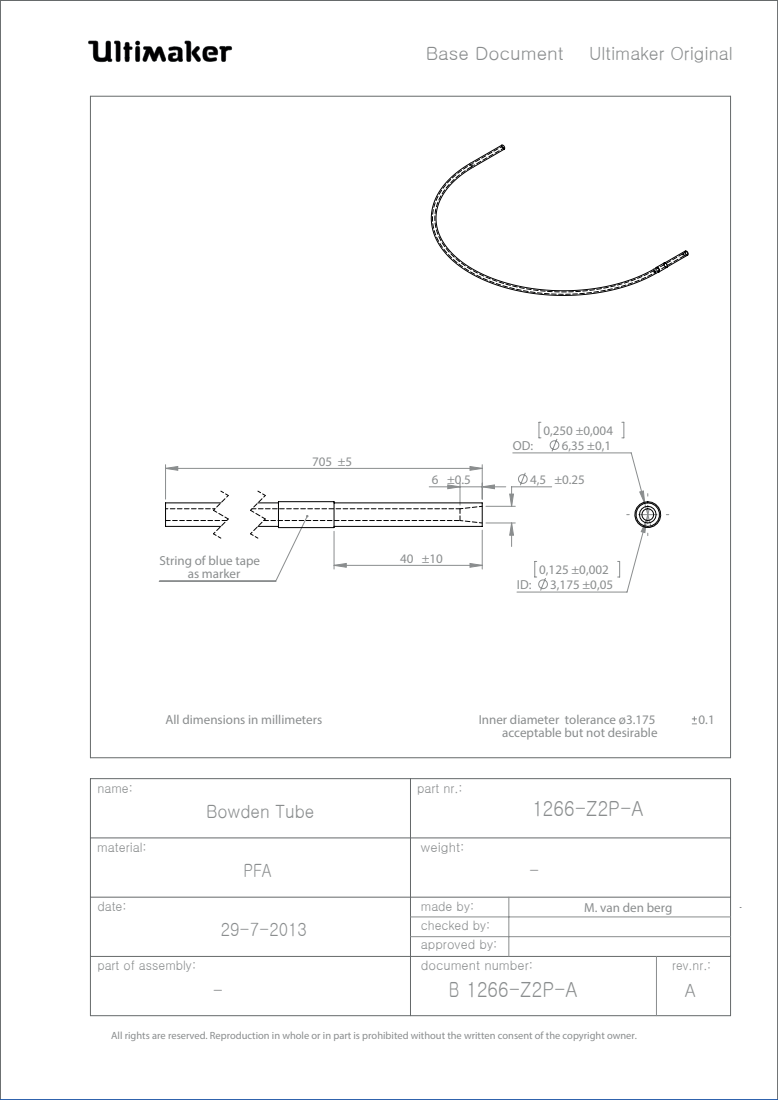
[picture p130: page 1]
String of blue tape; as marker; All dimensions in millimeters; Inner diameter tolerance ø3.175; PFA; Bowden Tube; Ultimaker Original; name:; material:; date:; part of assembly:; rev.nr.:; part nr.:; made by:; weight:; Base Document; approved by:; checked by:; document number: B 1266-Z2P-A

acceptable but not desirable

M. van den berg

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
