Ultimaker/Ultimaker2/1264_Feeder_Nut_Holder_(x1)/B1264-B2P-A.PDF

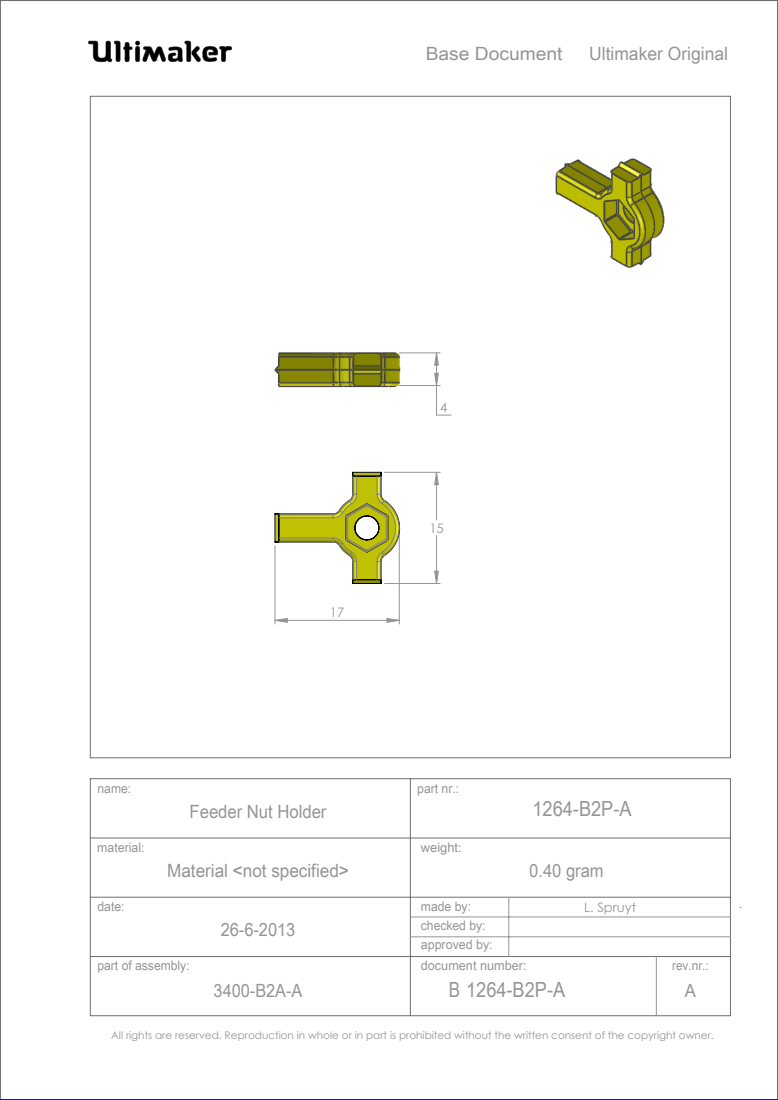
[picture p131: page 1]
Material <not specified>; 0.40 gram; Ultimaker Original; part of assembly:; rev.nr.:; part nr.:; made by:; Base Document; approved by:; checked by:; L. Spruyt; document number: B 1264-B2P-A

Feeder Nut Holder

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
