Ultimaker/Ultimaker2/1263_Feeder_Knurled_Wheel_(x1)/B1263-B2P-A.pdf

# Ultimaker Original Base Document

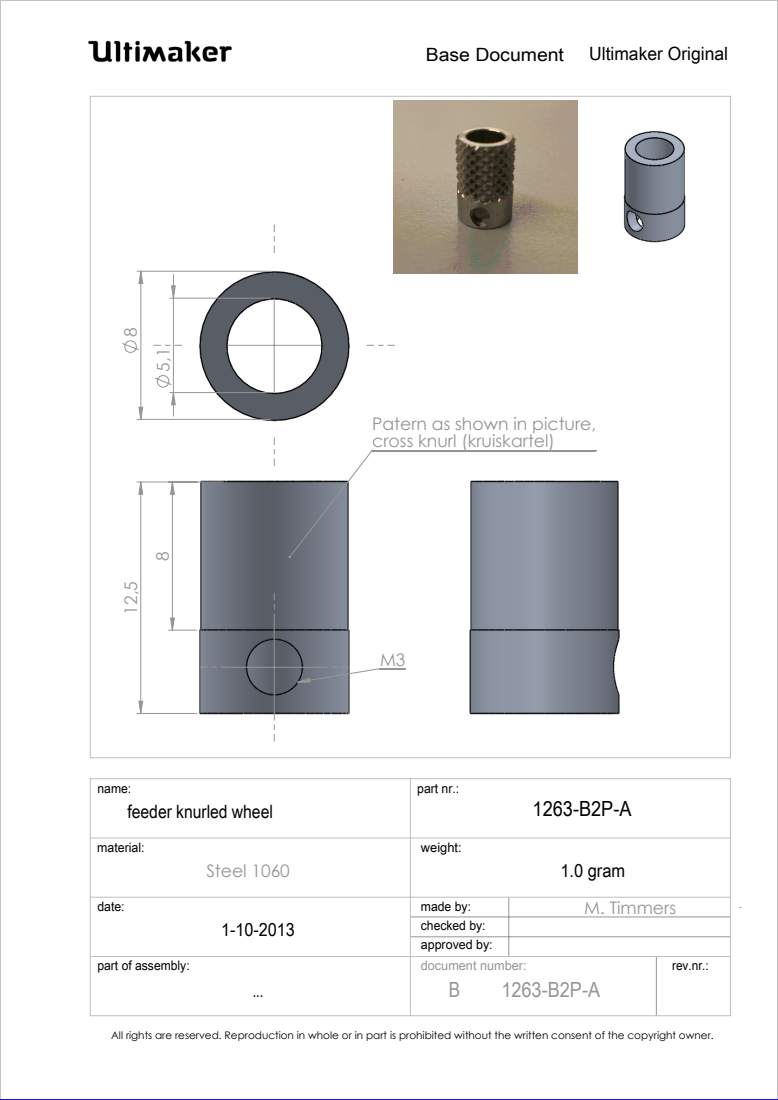
[picture p132: page 1]
1.0 gram; material:; date:; part of assembly:; rev.nr.:; part nr.:; made by:; weight:; approved by:; checked by:; M. Timmers; document number:; Steel 1060

Patern as shown in picture,
cross knurl (kruiskartel)

name:
feeder knurled wheel

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
