Ultimaker/Ultimaker2/1261_Feeder_Lever_B_(x1)/B1261-B2P-A.PDF

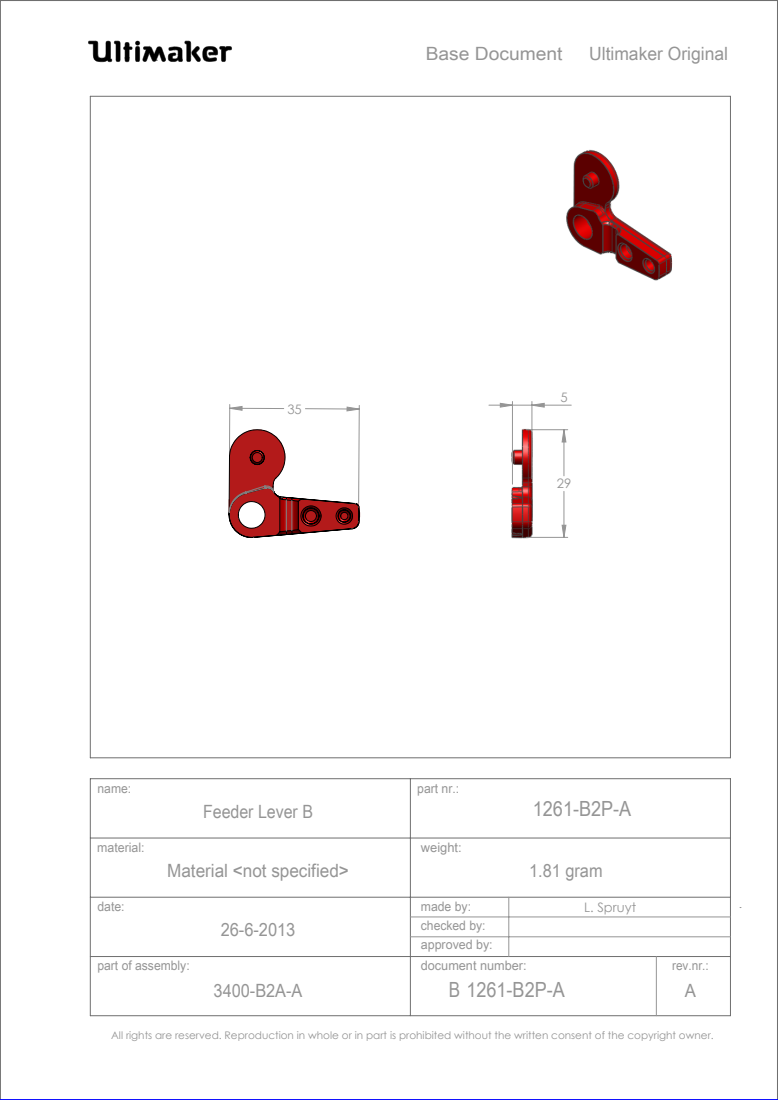
[picture p133: page 1]
Material <not specified>; 1.81 gram; Feeder Lever B; Ultimaker Original; part of assembly:; rev.nr.:; part nr.:; made by:; Base Document; approved by:; checked by:; L. Spruyt; document number: B 1261-B2P-A

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
