Ultimaker/Ultimaker2/1260_Feeder_Lever_A_(x1)/B1260-B2P-A.PDF

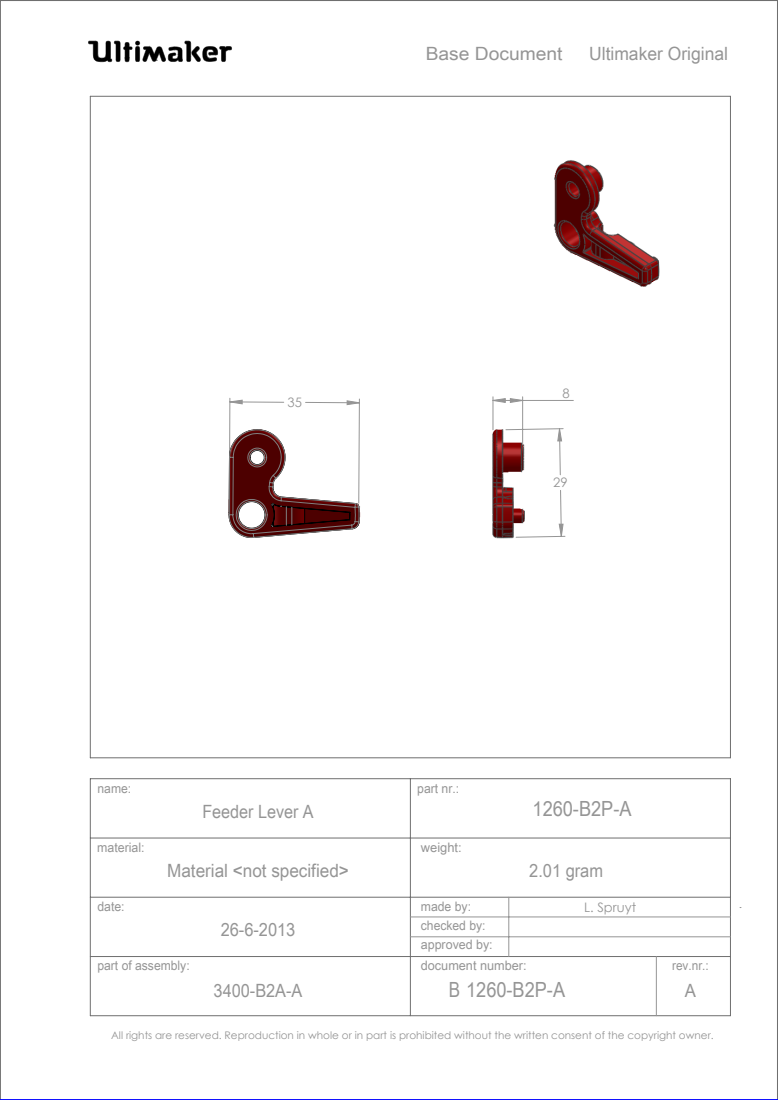
[picture p134: page 1]
Material <not specified>; 2.01 gram; Feeder Lever A; Ultimaker Original; part of assembly:; rev.nr.:; part nr.:; made by:; Base Document; approved by:; checked by:; L. Spruyt; document number: B 1260-B2P-A

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
