Ultimaker/Ultimaker2/1259_Feeder_Part_B_(x1)/B1259-B2P-A.PDF

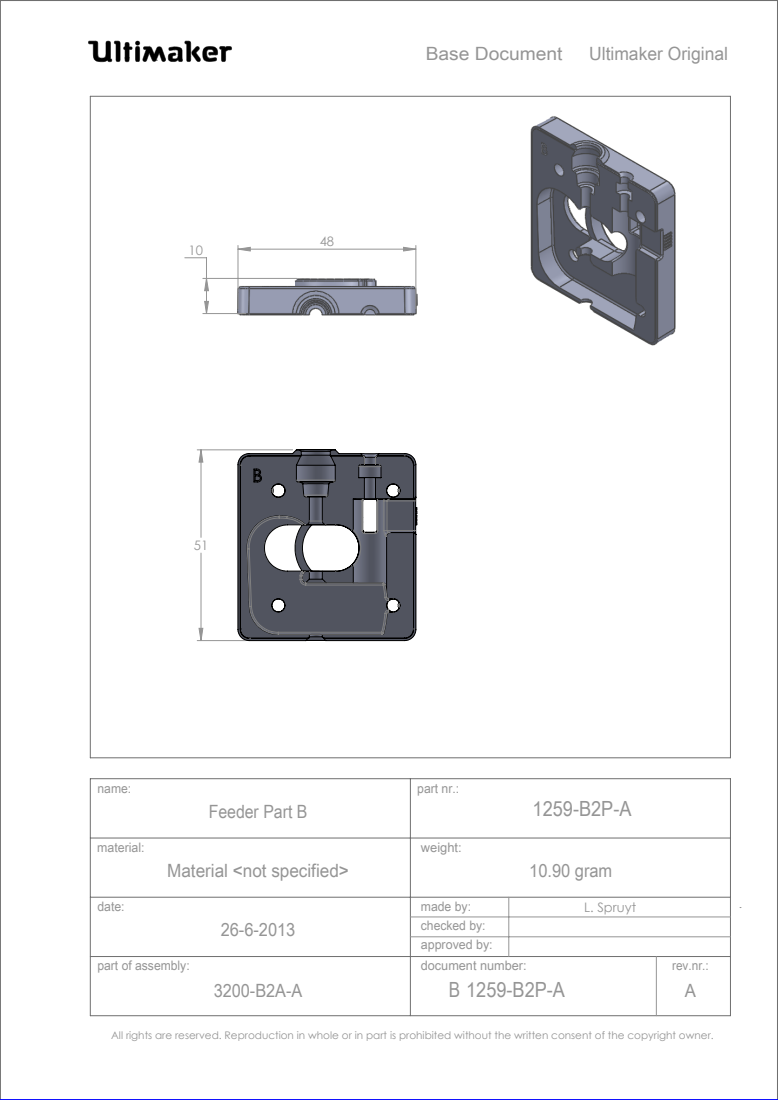
[picture p135: page 1]
Material <not specified>; 10.90 gram; Feeder Part B; Ultimaker Original; part of assembly:; rev.nr.:; part nr.:; made by:; Base Document; approved by:; checked by:; L. Spruyt; document number: B 1259-B2P-A

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
