Ultimaker/Ultimaker2/1258_Feeder_Part_A_(x1)/B1258-B2P-A.PDF

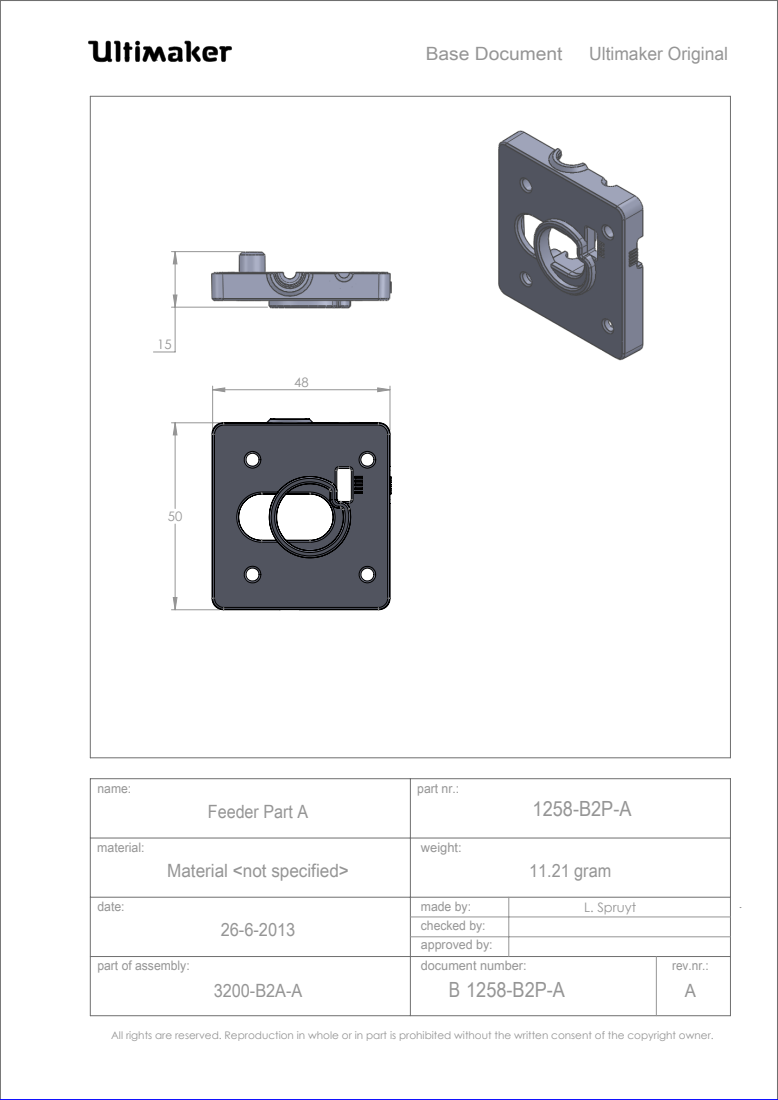
[picture p136: page 1]
Material <not specified>; 11.21 gram; Feeder Part A; Ultimaker Original; part of assembly:; rev.nr.:; part nr.:; made by:; Base Document; approved by:; checked by:; L. Spruyt; document number: B 1258-B2P-A

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
