Ultimaker/Ultimaker2/1257_Knurled_Nut_Platform_(x3)/B1257-B2P-B.pdf

# Ultimaker 2 Base Document

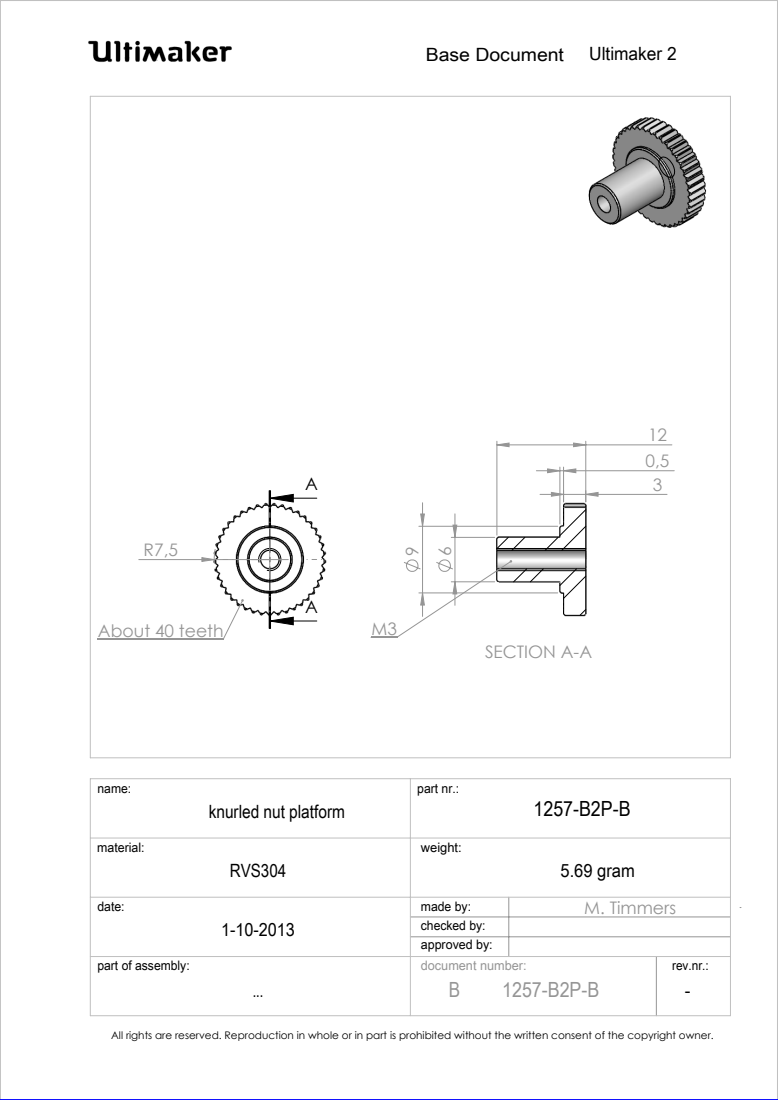
[picture p137: page 1]
About 40 teeth; SECTION A-A; RVS304; 5.69 gram; name:; material:; date:; part of assembly:; rev.nr.:; part nr.:; made by:; weight:; approved by:; checked by:; M. Timmers; document number:

knurled nut platform

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
