Ultimaker/Ultimaker2/1255_Sliding_Block_(x8)/B1255-B2P-A.PDF

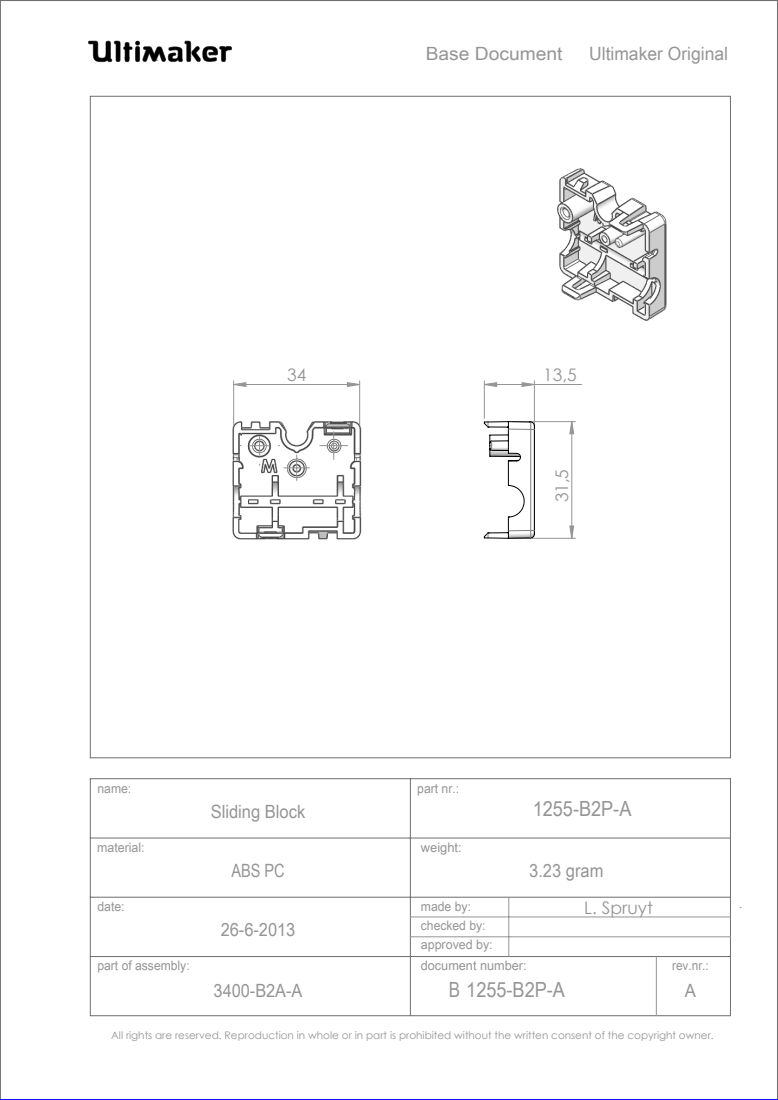
[picture p138: page 1]
ABS PC; 3.23 gram; Sliding Block; Ultimaker Original; part of assembly:; rev.nr.:; part nr.:; made by:; Base Document; approved by:; checked by:; L. Spruyt; document number: B 1255-B2P-A

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
