Ultimaker/Ultimaker2/1249_Ulticontroller_Board_(x1)/B1249-B2P-A.PDF

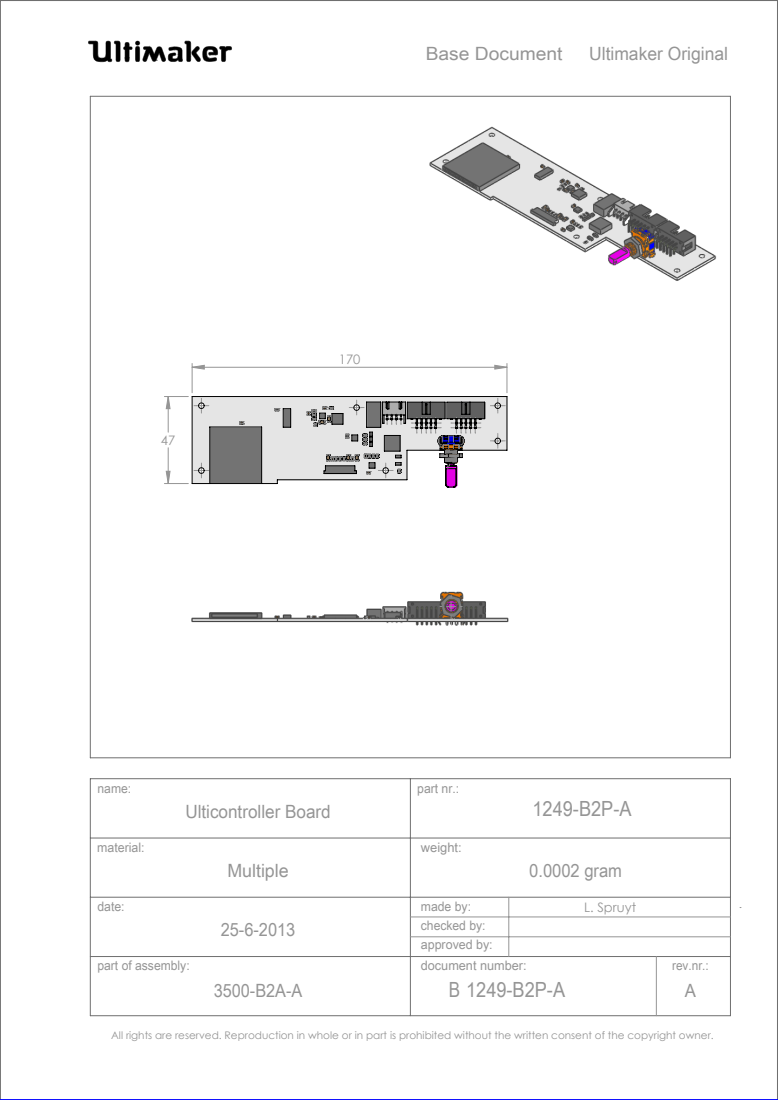
[picture p139: page 1]
Multiple; 0.0002 gram; Ulticontroller Board; Ultimaker Original; part of assembly:; rev.nr.:; part nr.:; made by:; Base Document; approved by:; checked by:; L. Spruyt; document number: B 1249-B2P-A

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
