Ultimaker/Ultimaker2/1248_SD_card_(x1)/B1248-Z1P-A.pdf

32

# Ultimaker Original

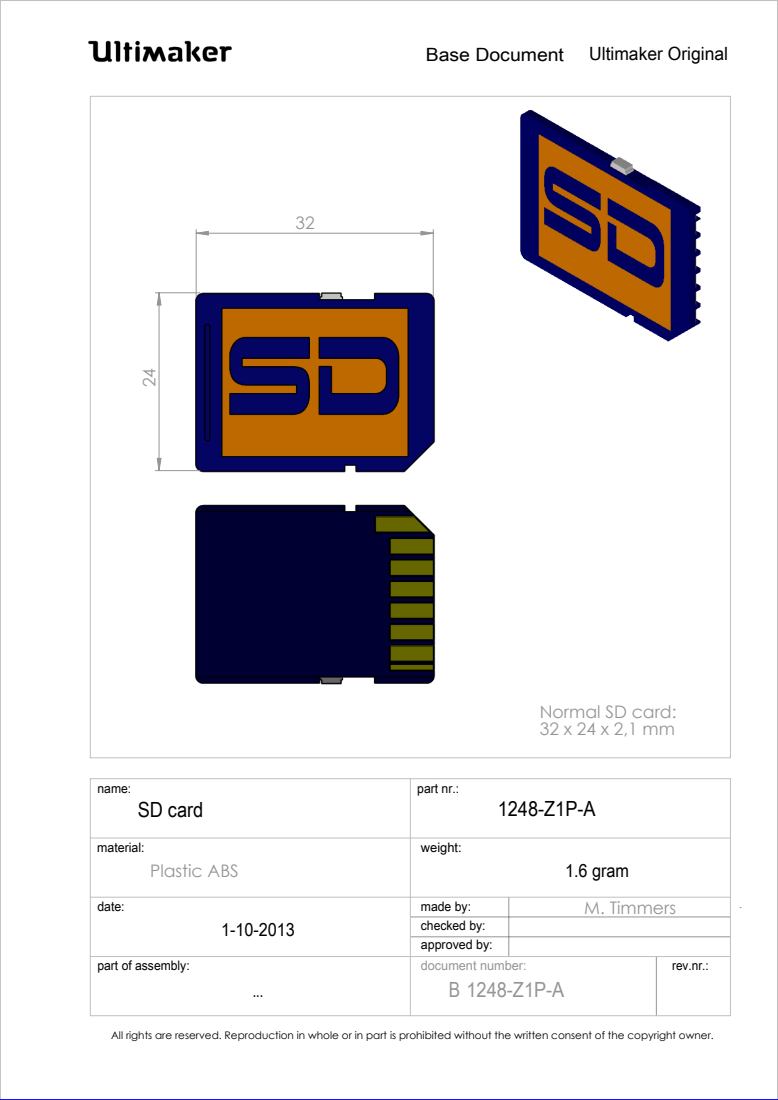
[picture p140: page 1]
1.6 gram; name:; material:; date:; part of assembly:; rev.nr.:; part nr.:; made by:; weight:; Base Document; approved by:; checked by:; M. Timmers; document number: B 1248-Z1P-A; Plastic ABS; SD card

Normal SD card:

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
