Ultimaker/Ultimaker2/1245_Knob_Housing_(x1)/B1245-B2P-A.PDF

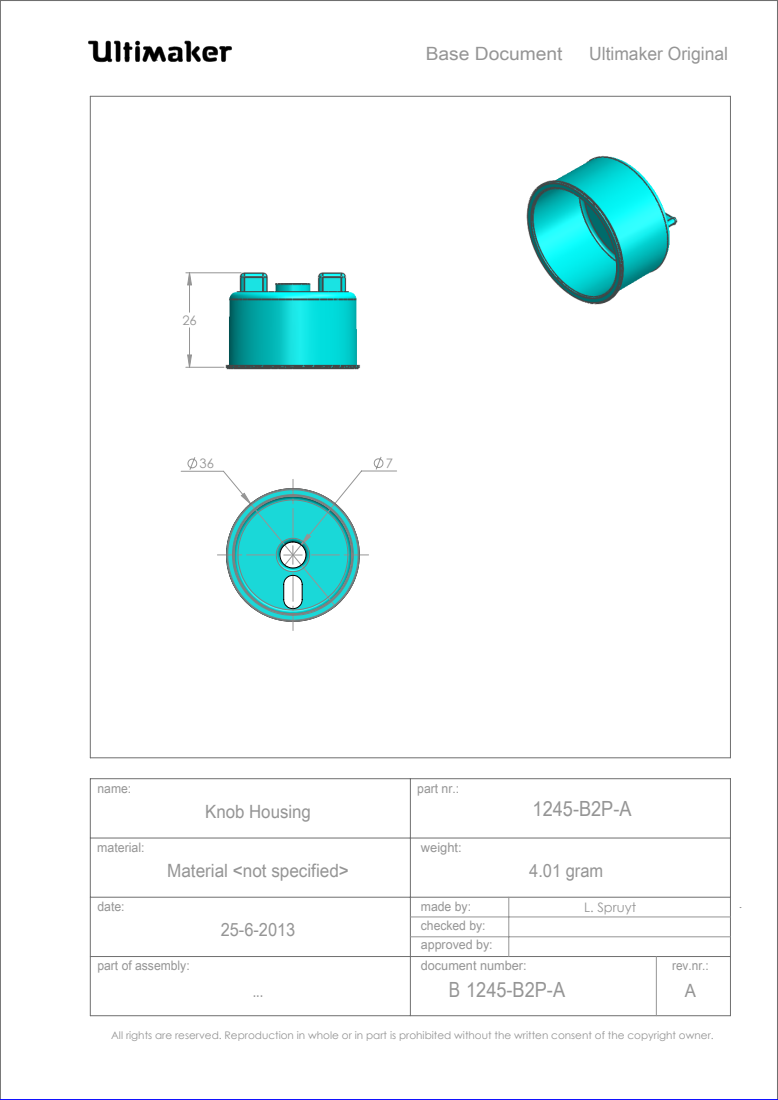
[picture p141: page 1]
Material <not specified>; 4.01 gram; Knob Housing; Ultimaker Original; part of assembly:; rev.nr.:; part nr.:; made by:; Base Document; approved by:; checked by:; L. Spruyt; document number: B 1245-B2P-A

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
