Ultimaker/Ultimaker2/1241_Motor_Spacer_(x2)/B1241-B2P-A.PDF

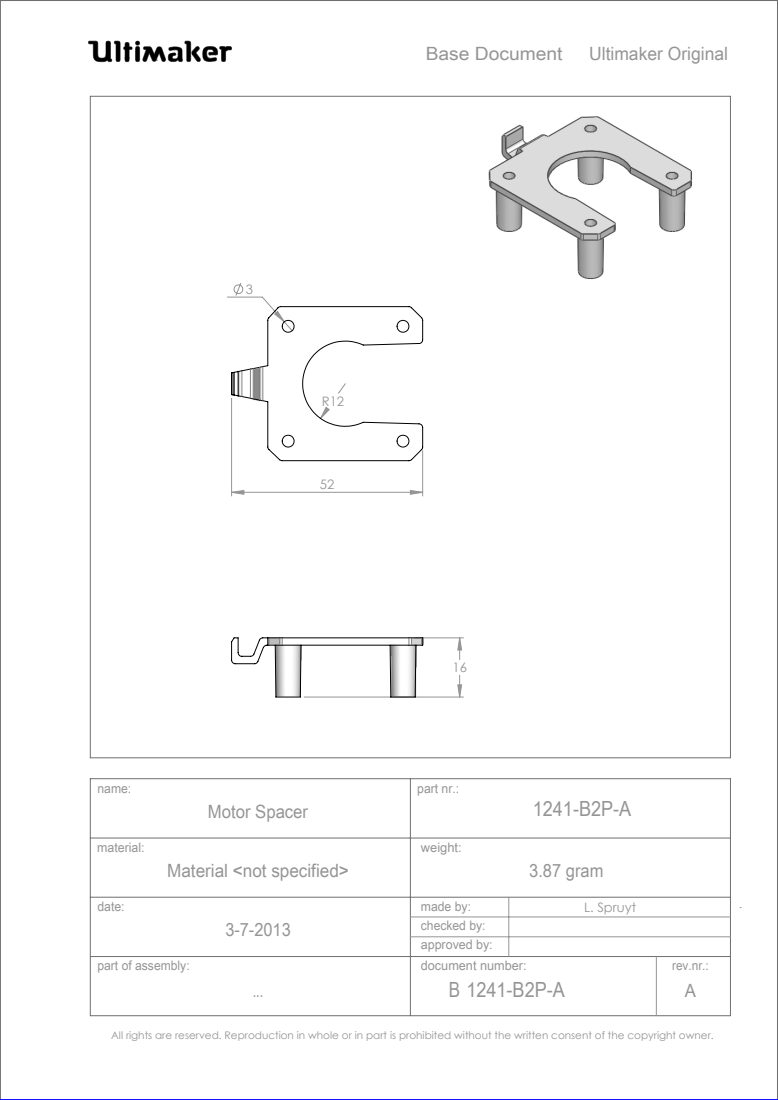
[picture p142: page 1]
Material <not specified>; 3.87 gram; Motor Spacer; Ultimaker Original; part of assembly:; rev.nr.:; part nr.:; made by:; Base Document; approved by:; checked by:; L. Spruyt; document number: B 1241-B2P-A

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
