Ultimaker/Ultimaker2/1238_Power_Adapter_24v-220W_(x1)/B1238-B2P-A.pdf

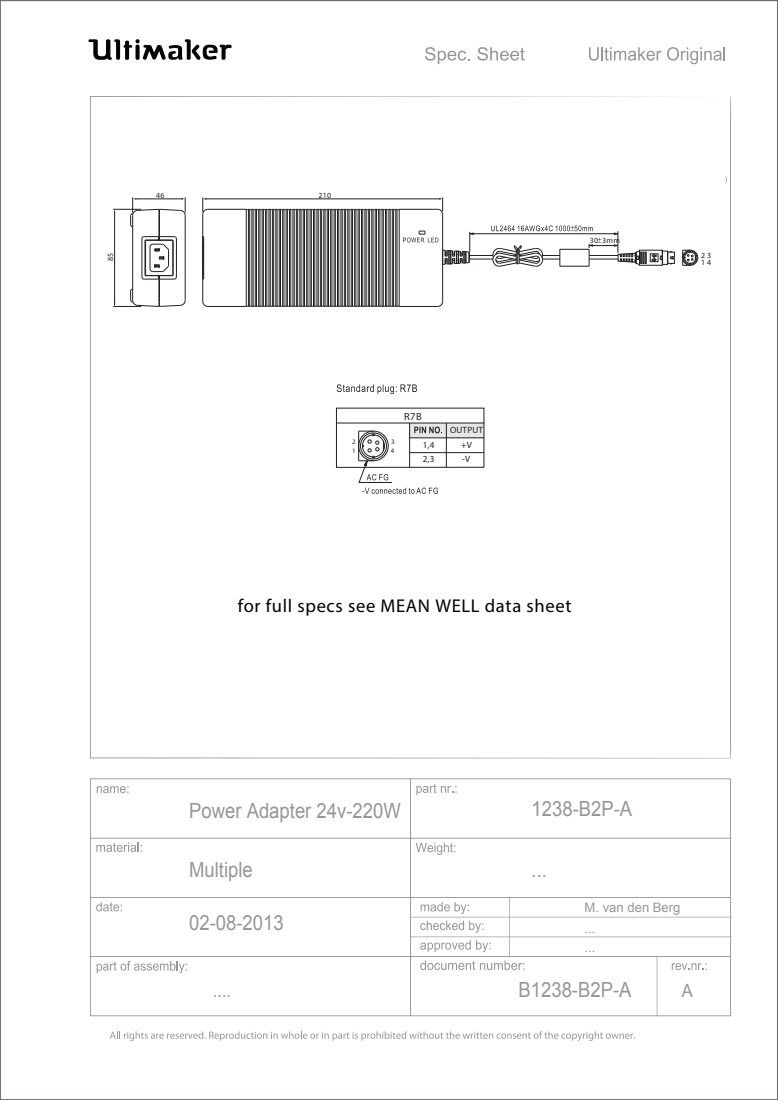
[picture p143: page 1]
Multiple; Power Adapter 24v-220W; M. van den Berg ... ...; OUTPUT +V -V

for full specs see MEAN WELL data sheet
