Ultimaker/Ultimaker2/1217_ISO_10642_M4x10_A2_(x8)/B1217-Z1P-A.PDF

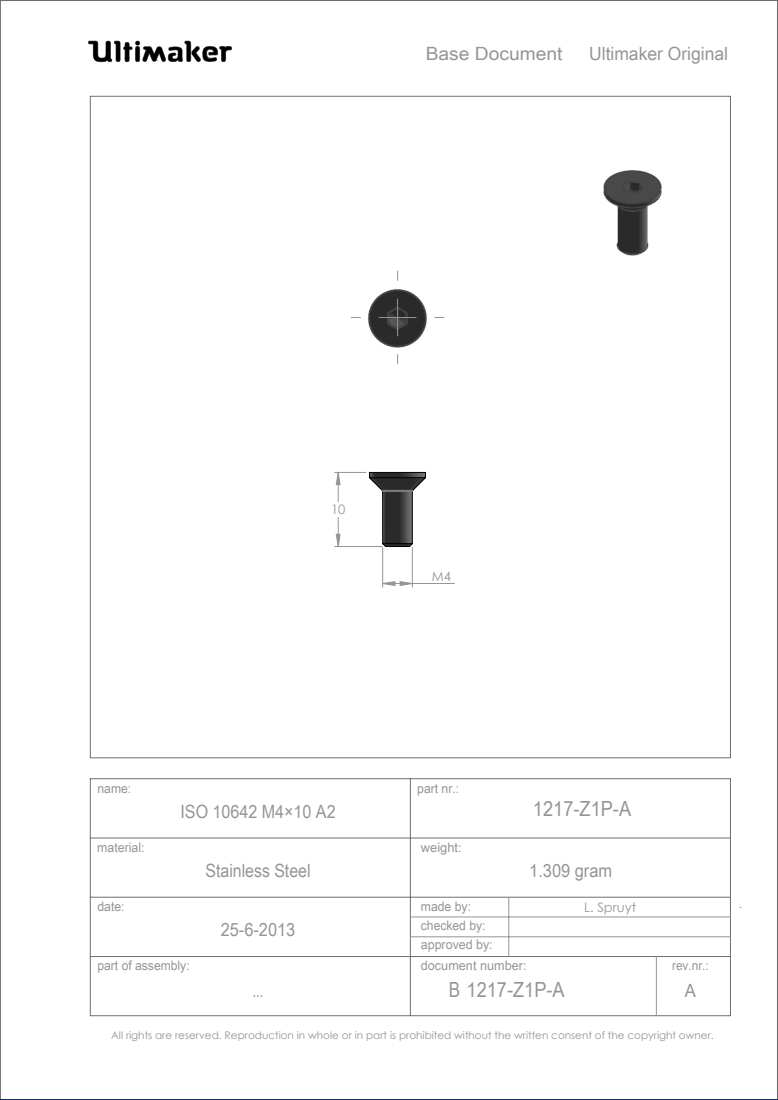
[picture p144: page 1]
Stainless Steel; 1.309 gram; ISO 10642 M4×10 A2; Ultimaker Original; part of assembly:; rev.nr.:; part nr.:; made by:; Base Document; approved by:; checked by:; L. Spruyt; document number: B 1217-Z1P-A

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
