Ultimaker/Ultimaker2/1216_ISO_10642_M3x20_A2_(x3)/B1216-Z1P-A.PDF

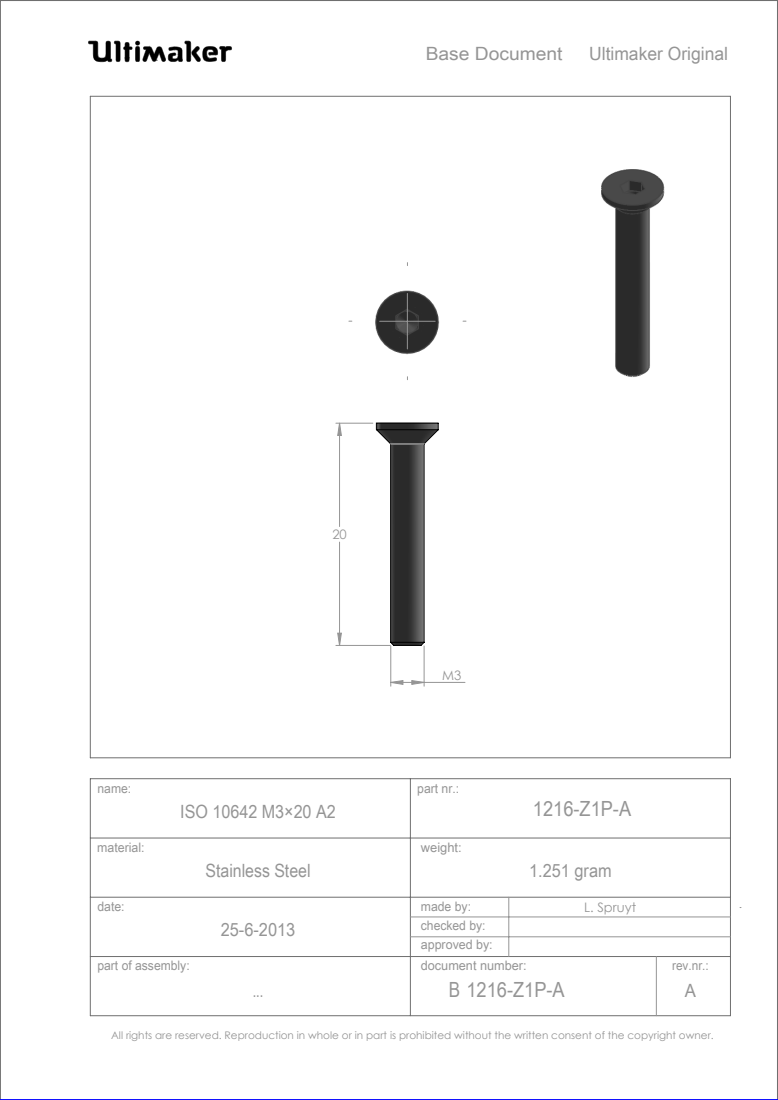
[picture p145: page 1]
Stainless Steel; 1.251 gram; ISO 10642 M3×20 A2; Ultimaker Original; part of assembly:; rev.nr.:; part nr.:; made by:; Base Document; approved by:; checked by:; L. Spruyt; document number: B 1216-Z1P-A

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
