Ultimaker/Ultimaker2/1215_ISO_10642_M3x8_A2_(x4)/B1215-Z1P-A.PDF

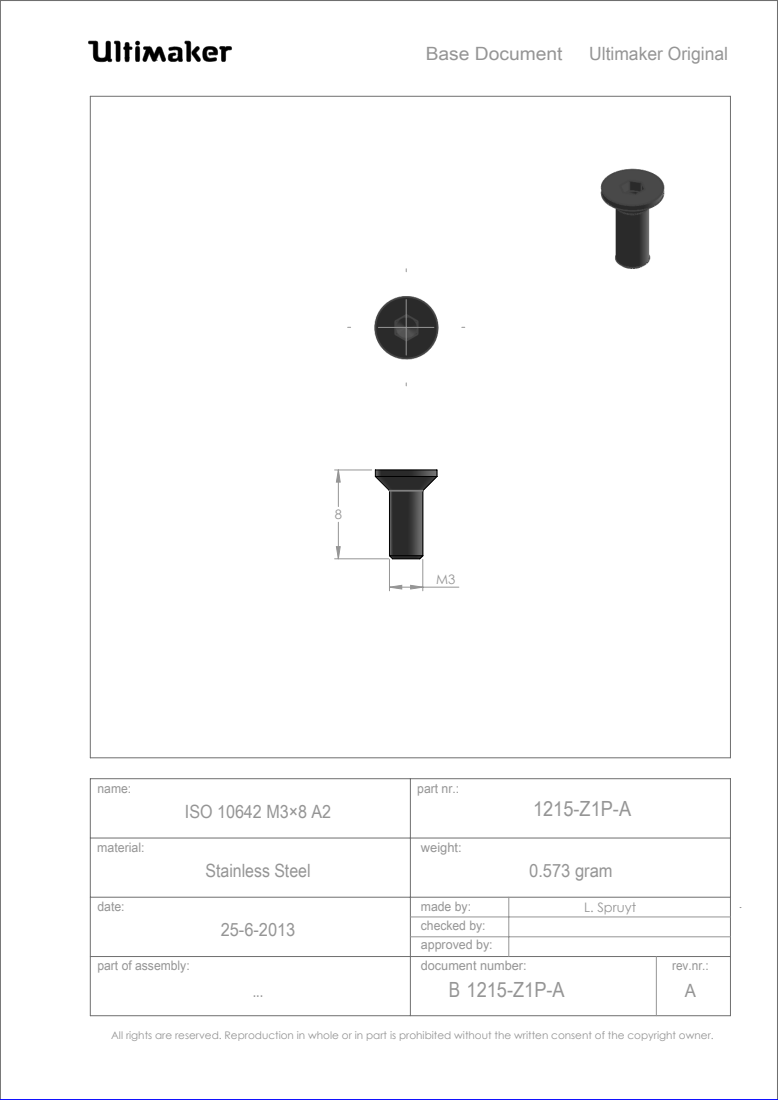
[picture p146: page 1]
Stainless Steel; 0.573 gram; ISO 10642 M3×8 A2; Ultimaker Original; part of assembly:; rev.nr.:; part nr.:; made by:; Base Document; approved by:; checked by:; L. Spruyt; document number: B 1215-Z1P-A

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
