Ultimaker/Ultimaker2/1214_ISO_7040_Nut_M3_Prev._torque_A2_(x15)/B1214-Z1P-A.PDF

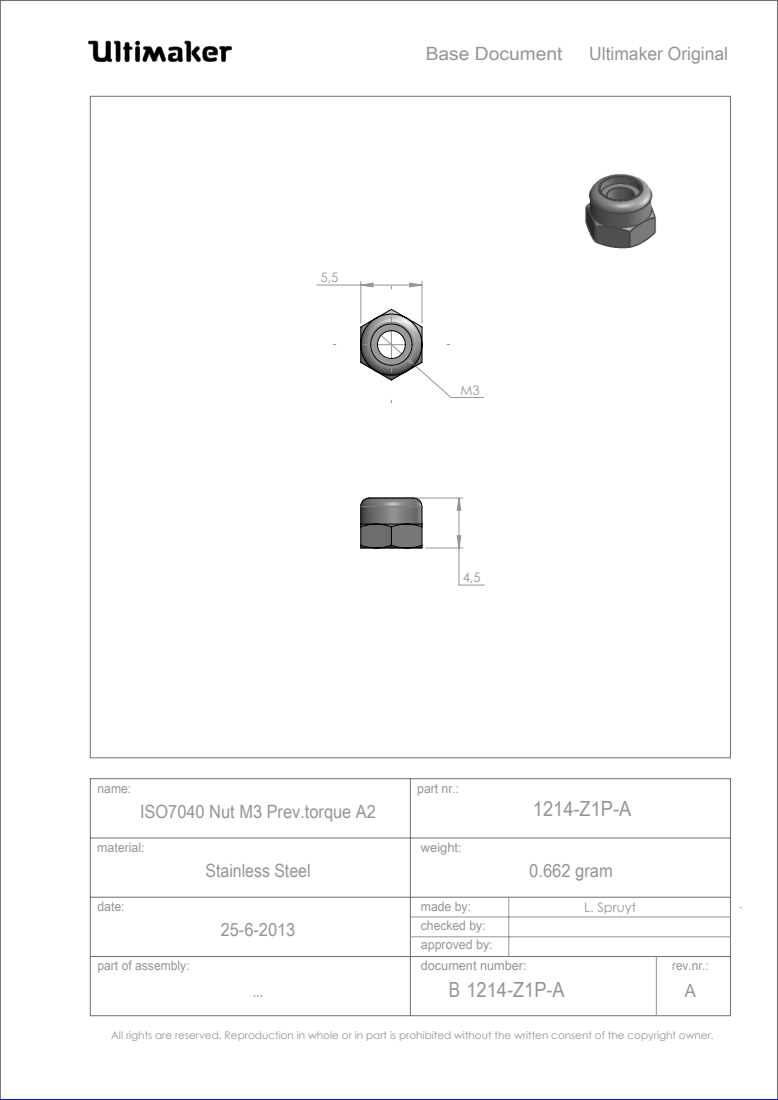
[picture p147: page 1]
Stainless Steel; 0.662 gram; Ultimaker Original; part of assembly:; rev.nr.:; part nr.:; made by:; Base Document; approved by:; checked by:; L. Spruyt; document number: B 1214-Z1P-A

name:
ISO7040 Nut M3 Prev.torque A2

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
