Ultimaker/Ultimaker2/1213_DIN_962_Square_Nut_M3_A2_(x37)/B1213-Z1P-A.PDF

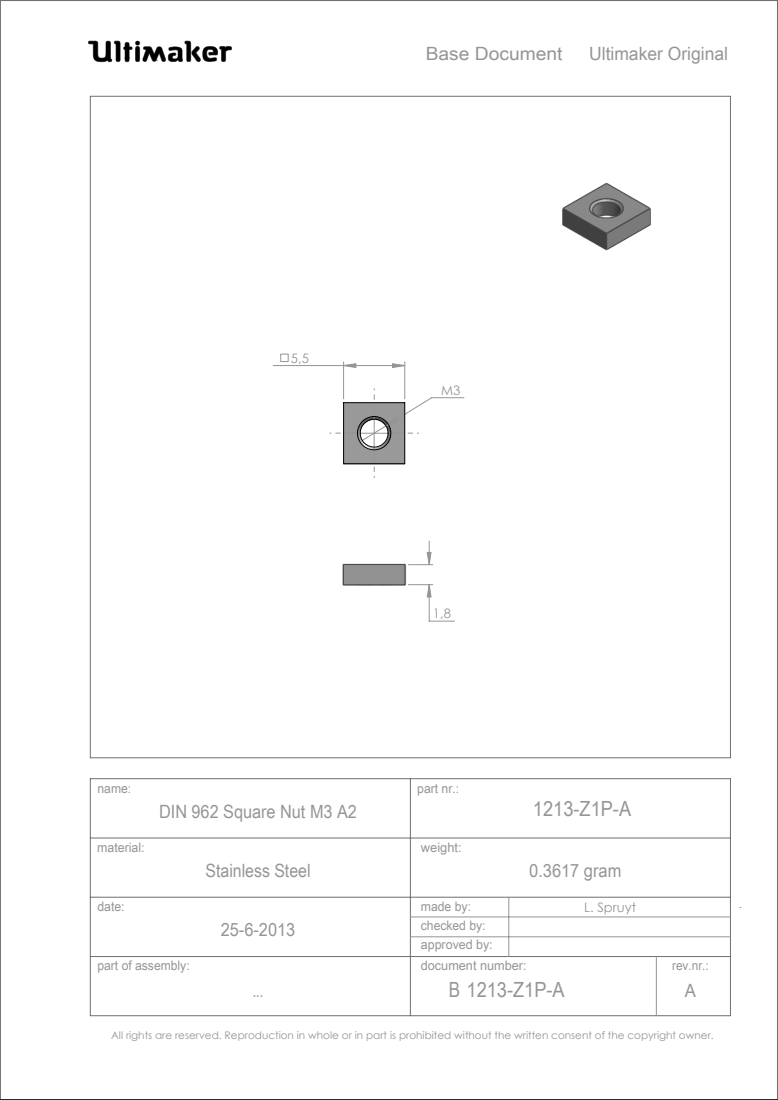
[picture p148: page 1]
Stainless Steel; 0.3617 gram; Ultimaker Original; part of assembly:; rev.nr.:; part nr.:; made by:; Base Document; approved by:; checked by:; L. Spruyt; document number: B 1213-Z1P-A

name:
DIN 962 Square Nut M3 A2

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
