Ultimaker/Ultimaker2/1212_Set_Screw_M3x3_(x1)/B1212-Z1P-A.PDF

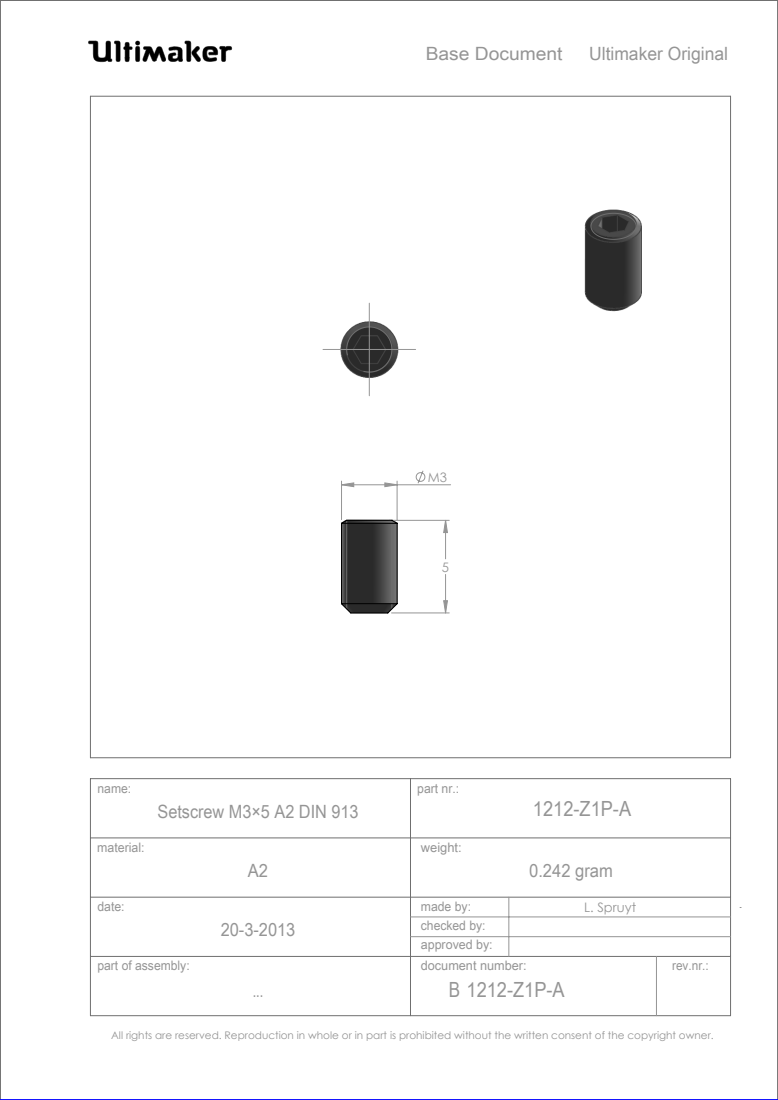
[picture p149: page 1]
0.242 gram; Setscrew M3×5 A2 DIN 913; Ultimaker Original; part of assembly:; rev.nr.:; part nr.:; made by:; Base Document; approved by:; checked by:; L. Spruyt; document number: B 1212-Z1P-A

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
