Ultimaker/Ultimaker2/1209_Nut_M3_(x1)/B1209-Z1P-B.PDF

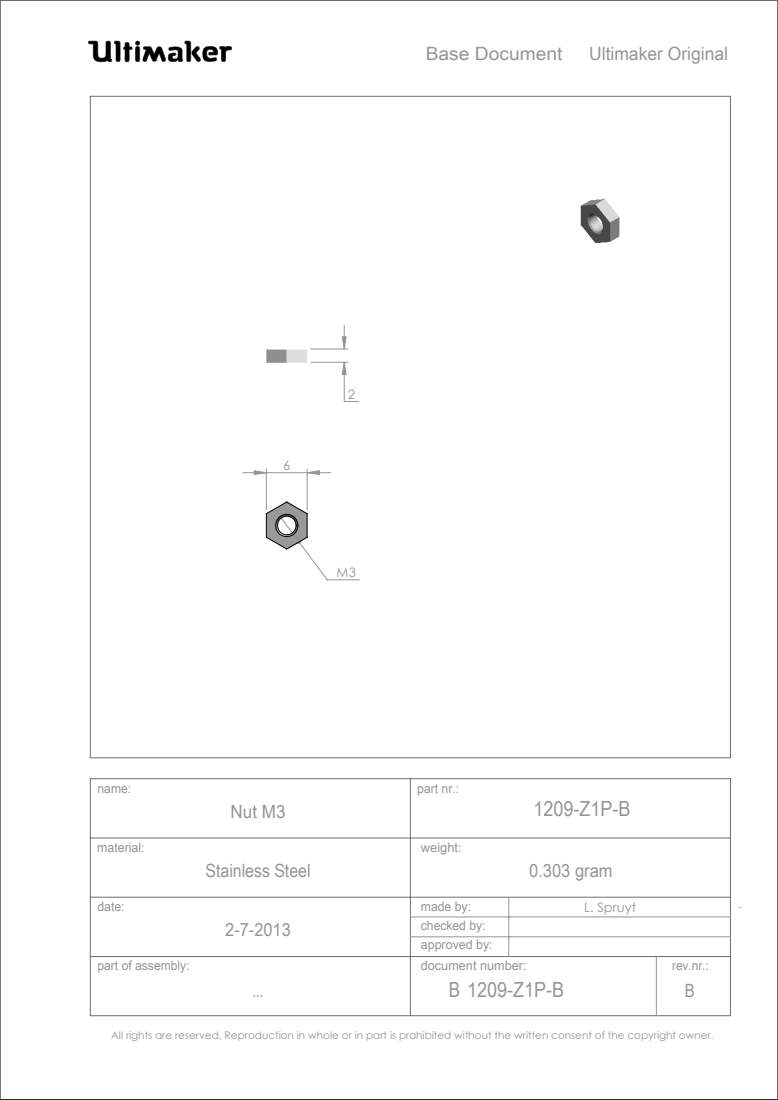
[picture p150: page 1]
Stainless Steel; 0.303 gram; Nut M3; Ultimaker Original; part of assembly:; rev.nr.:; part nr.:; made by:; Base Document; approved by:; checked by:; L. Spruyt; document number: B 1209-Z1P-B

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
