Ultimaker/Ultimaker2/1208_ISO_7380_M3x30_(x4)/B1208-Z1P-B.PDF

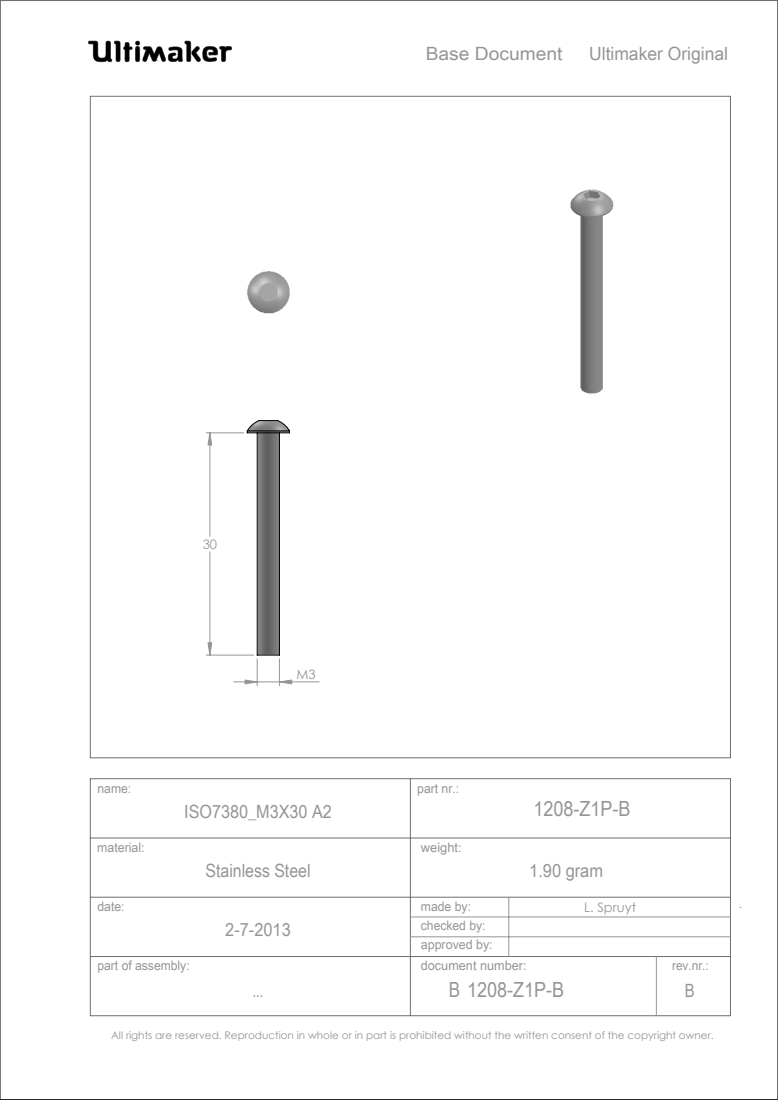
[picture p151: page 1]
Stainless Steel; 1.90 gram; ISO7380_M3X30 A2; Ultimaker Original; part of assembly:; rev.nr.:; part nr.:; made by:; Base Document; approved by:; checked by:; L. Spruyt; document number: B 1208-Z1P-B

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
