Ultimaker/Ultimaker2/1207_ISO_7380_M3x25_(x12)/B1207-Z1P-B.PDF

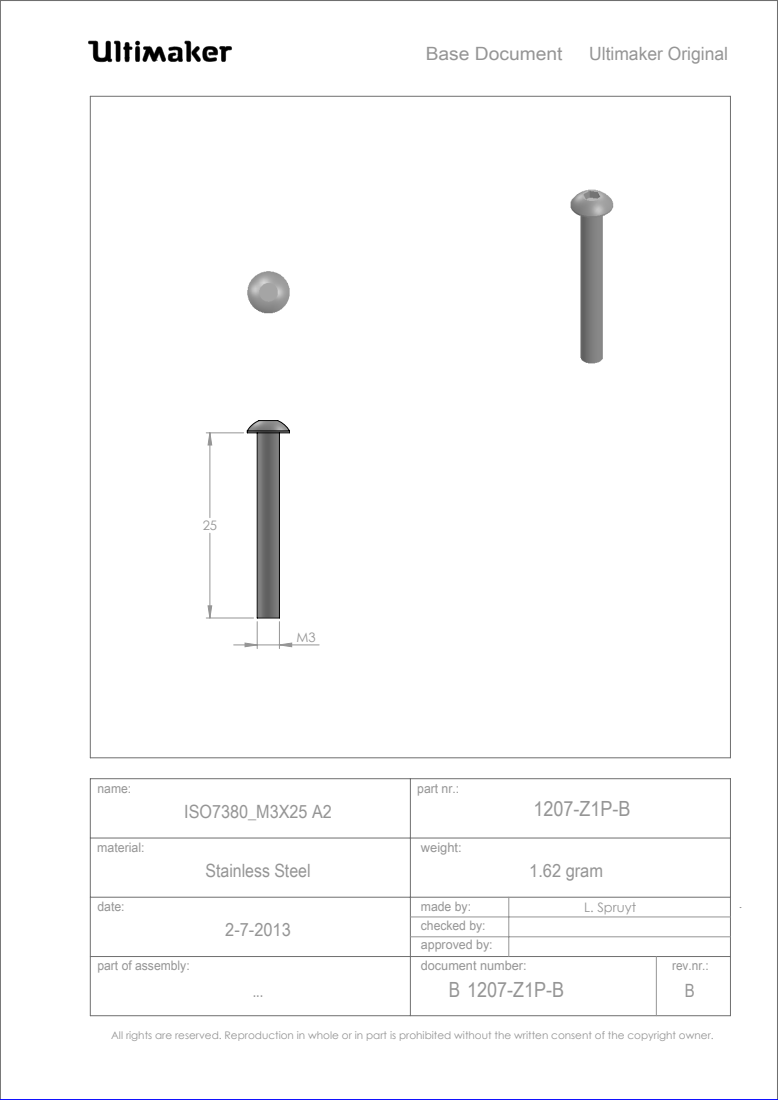
[picture p152: page 1]
Stainless Steel; 1.62 gram; ISO7380_M3X25 A2; Ultimaker Original; part of assembly:; rev.nr.:; part nr.:; made by:; Base Document; approved by:; checked by:; L. Spruyt; document number: B 1207-Z1P-B

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
