Ultimaker/Ultimaker2/1322_Print_Head_Bottom_(x1)/1322-B2P-A.pdf

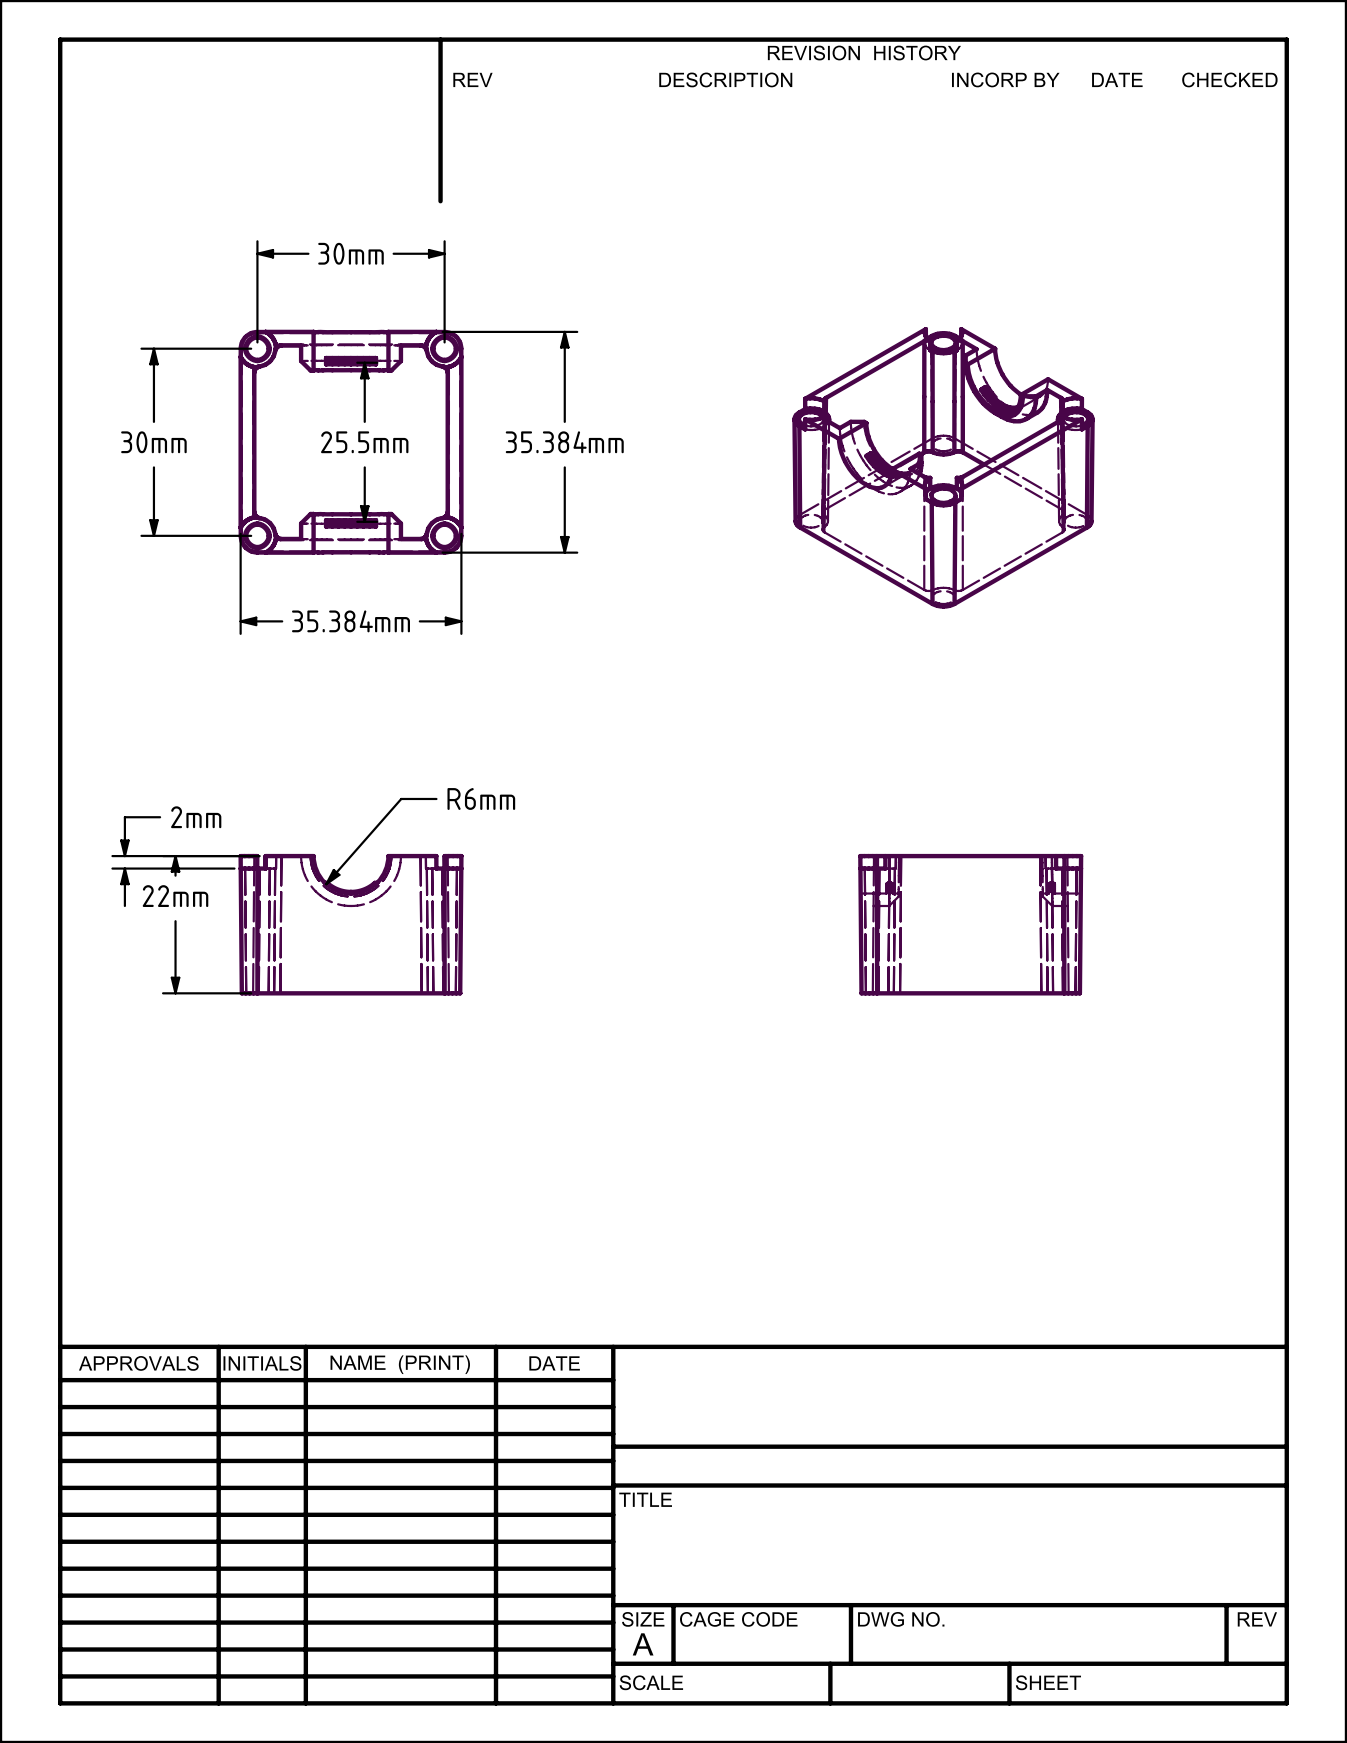
[picture p153: page 1]
