Ultimaker/Ultimaker2/1321_Print_Head_Middle_(x1)/1321-B2P-A.pdf

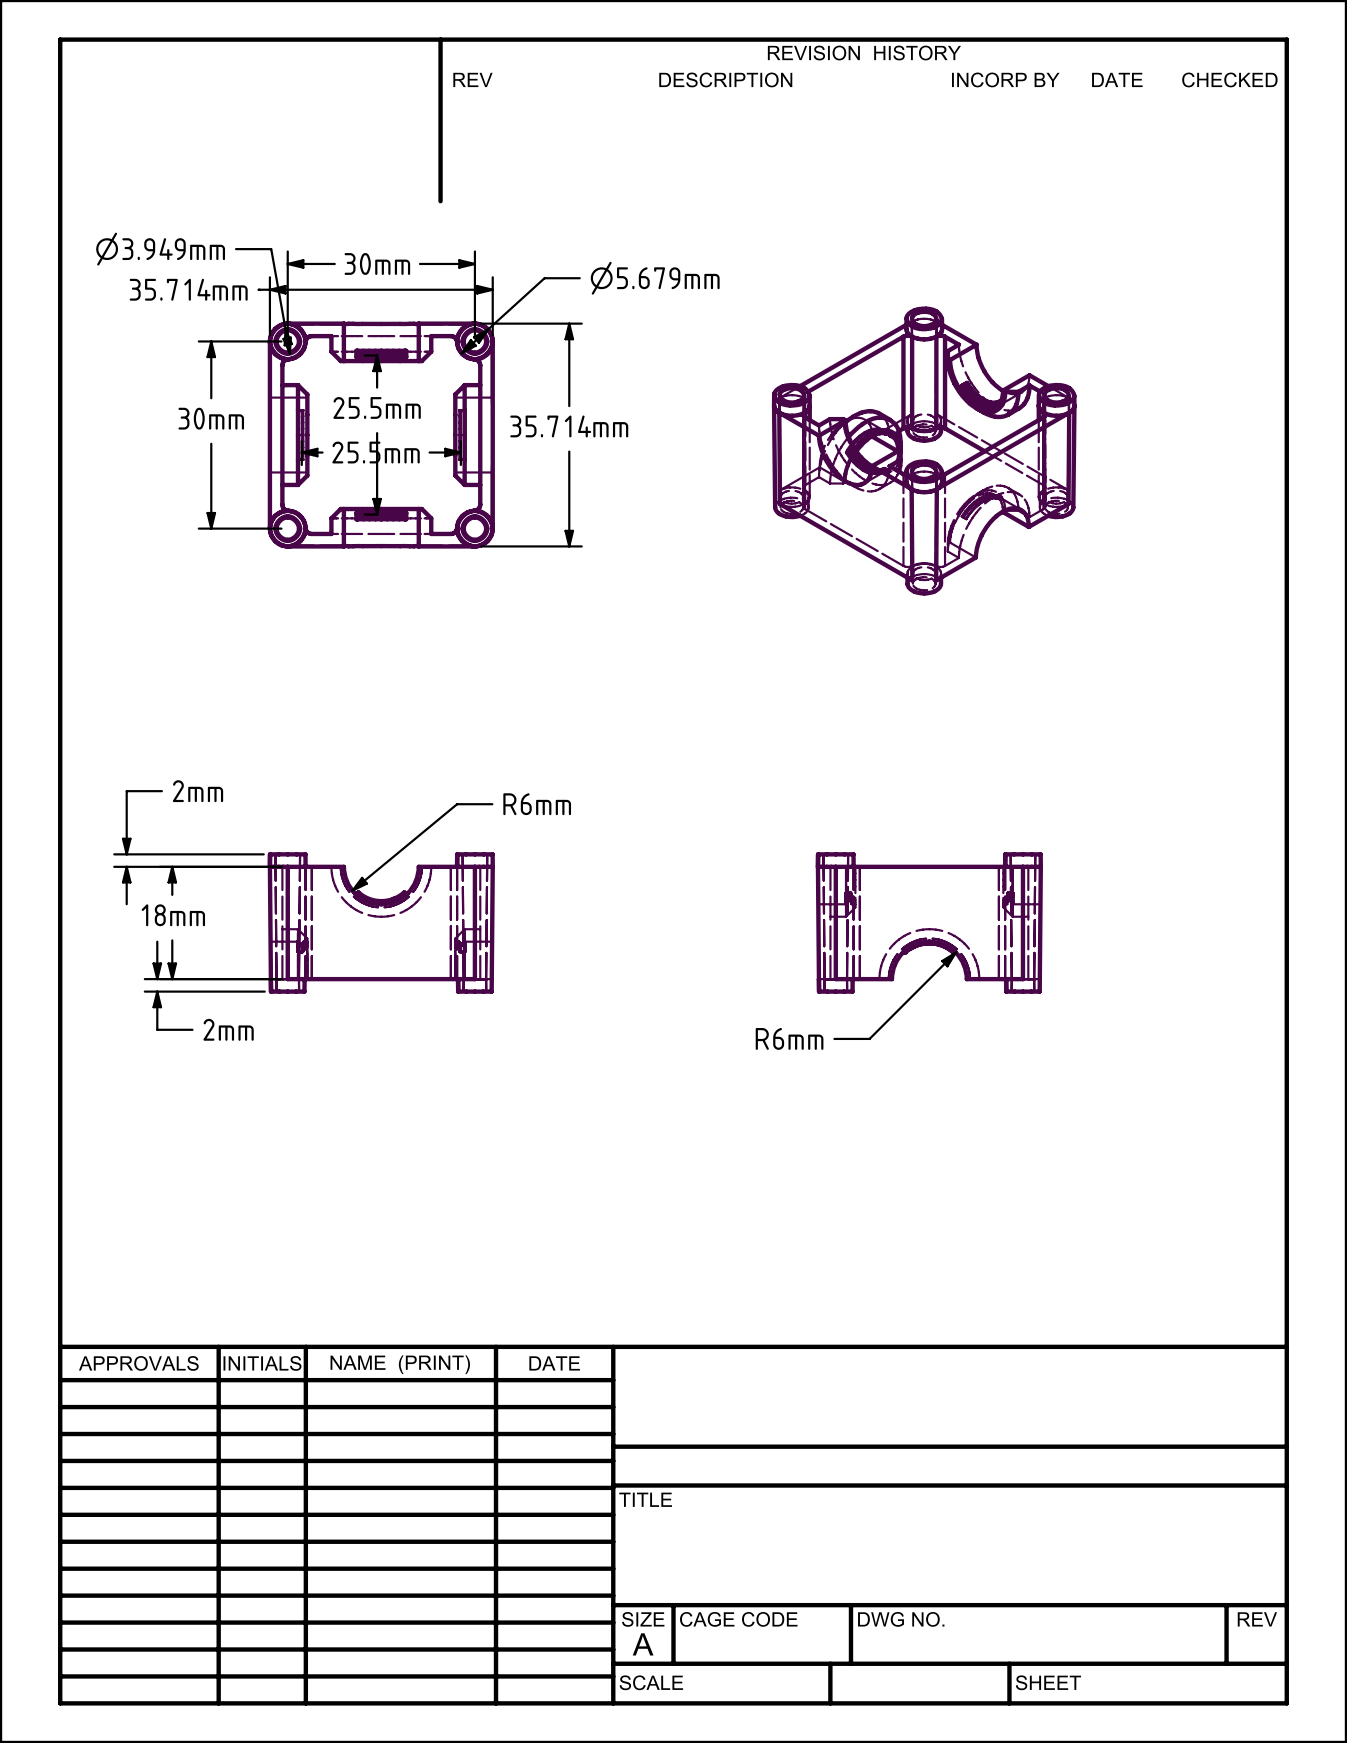
[picture p154: page 1]
