Ultimaker/Ultimaker2/1290_Filament_guide_(x1)/B1290-B2P-A.pdf

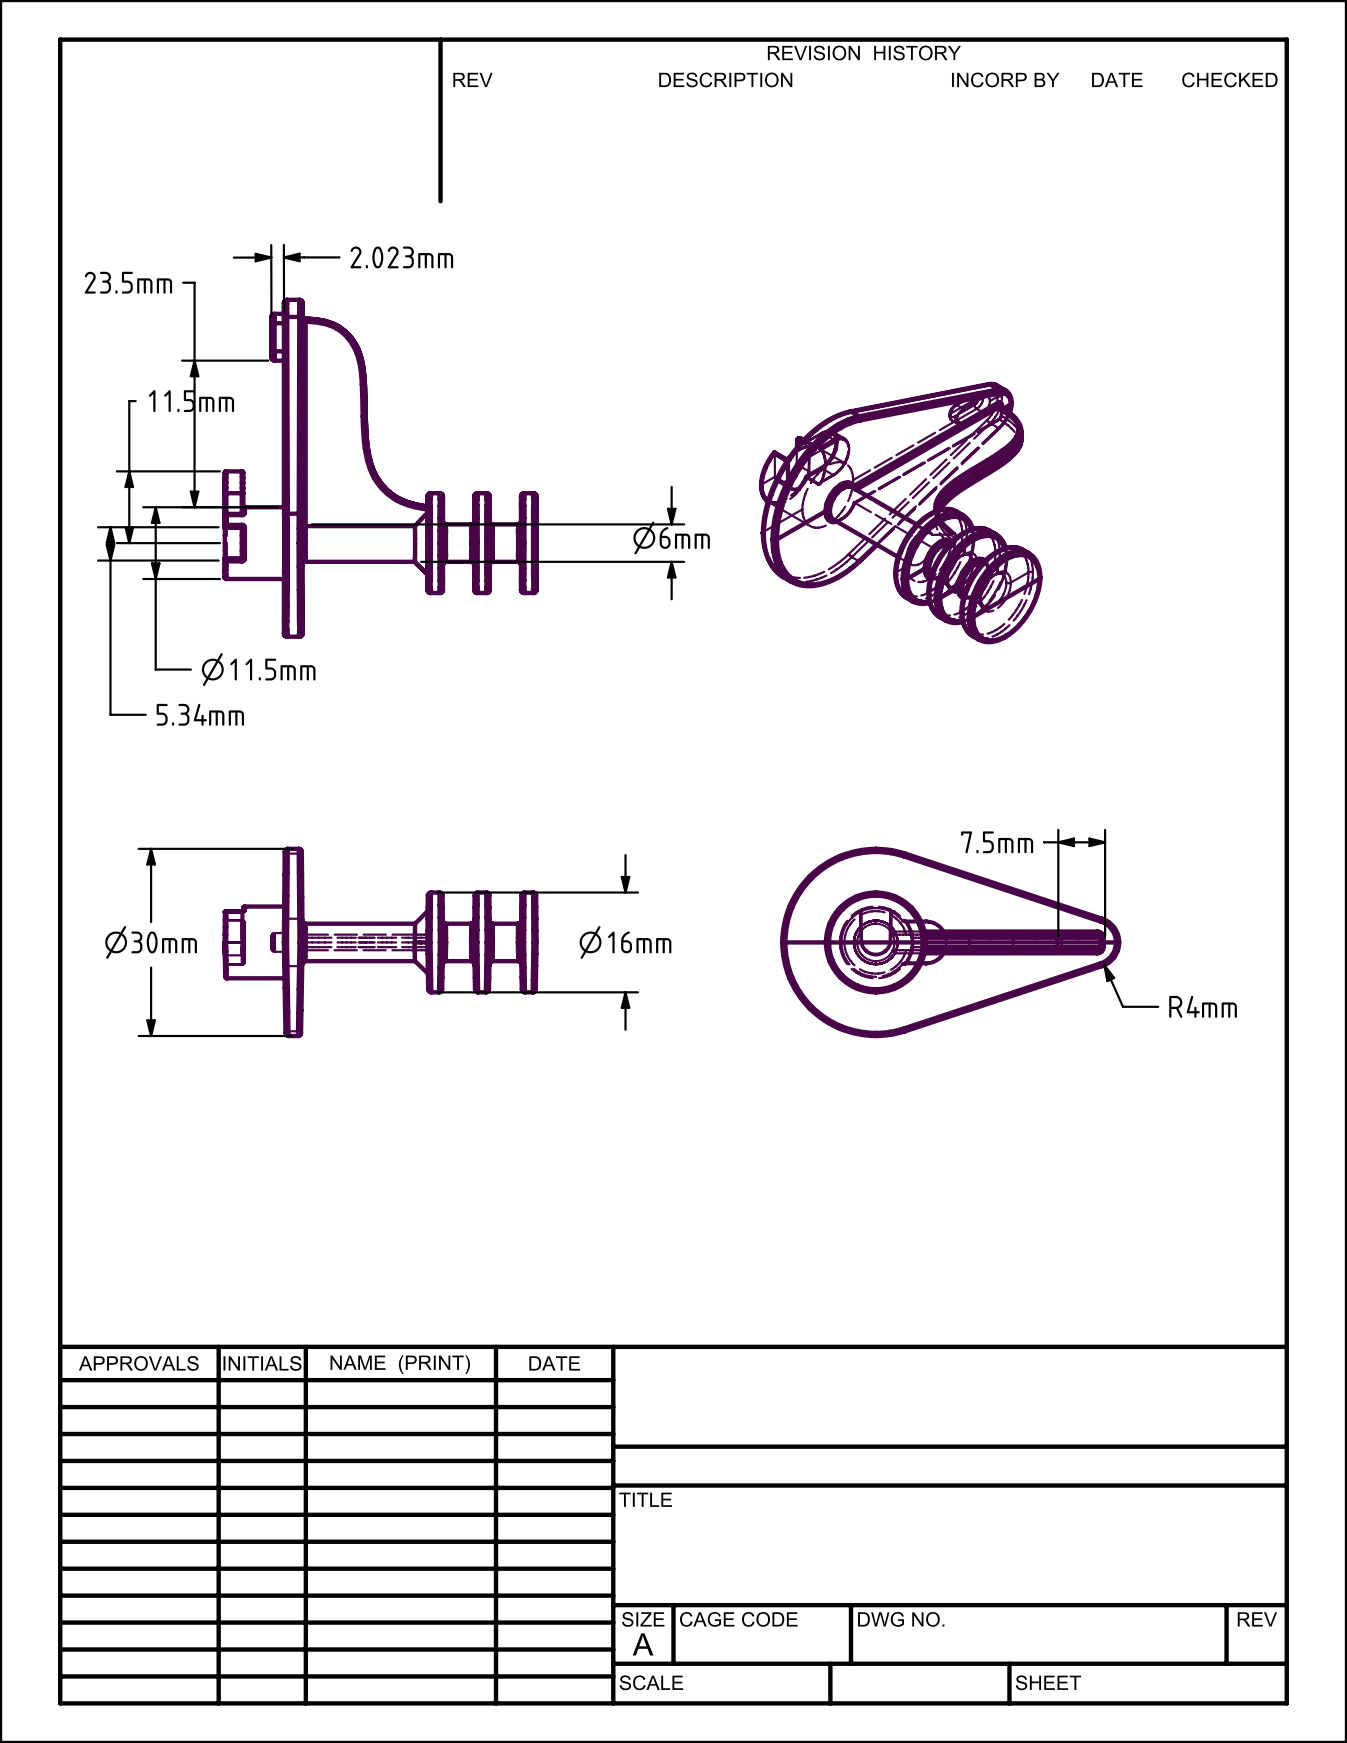
[picture p155: page 1]
