Ultimaker/Ultimaker2/1326_Warning_sticker_(x1)/B1326-Z1P-A.pdf

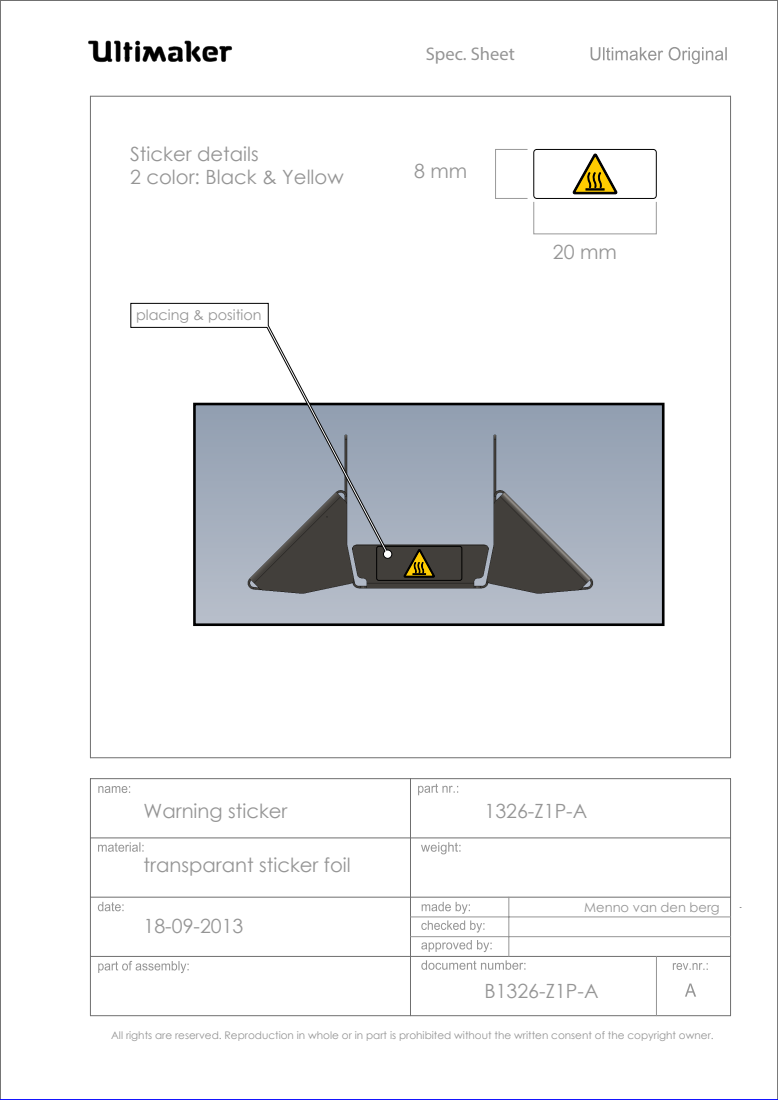
[picture p156: page 1]
Spec. Sheet; Warning sticker; placing & position

Sticker details
2 color: Black & Yellow

transparant sticker foil

Menno van den berg

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
