Ultimaker/Ultimaker2/1243_Heated_Bed_Cable_Clip_(x1)/B1243-B2P-A.pdf

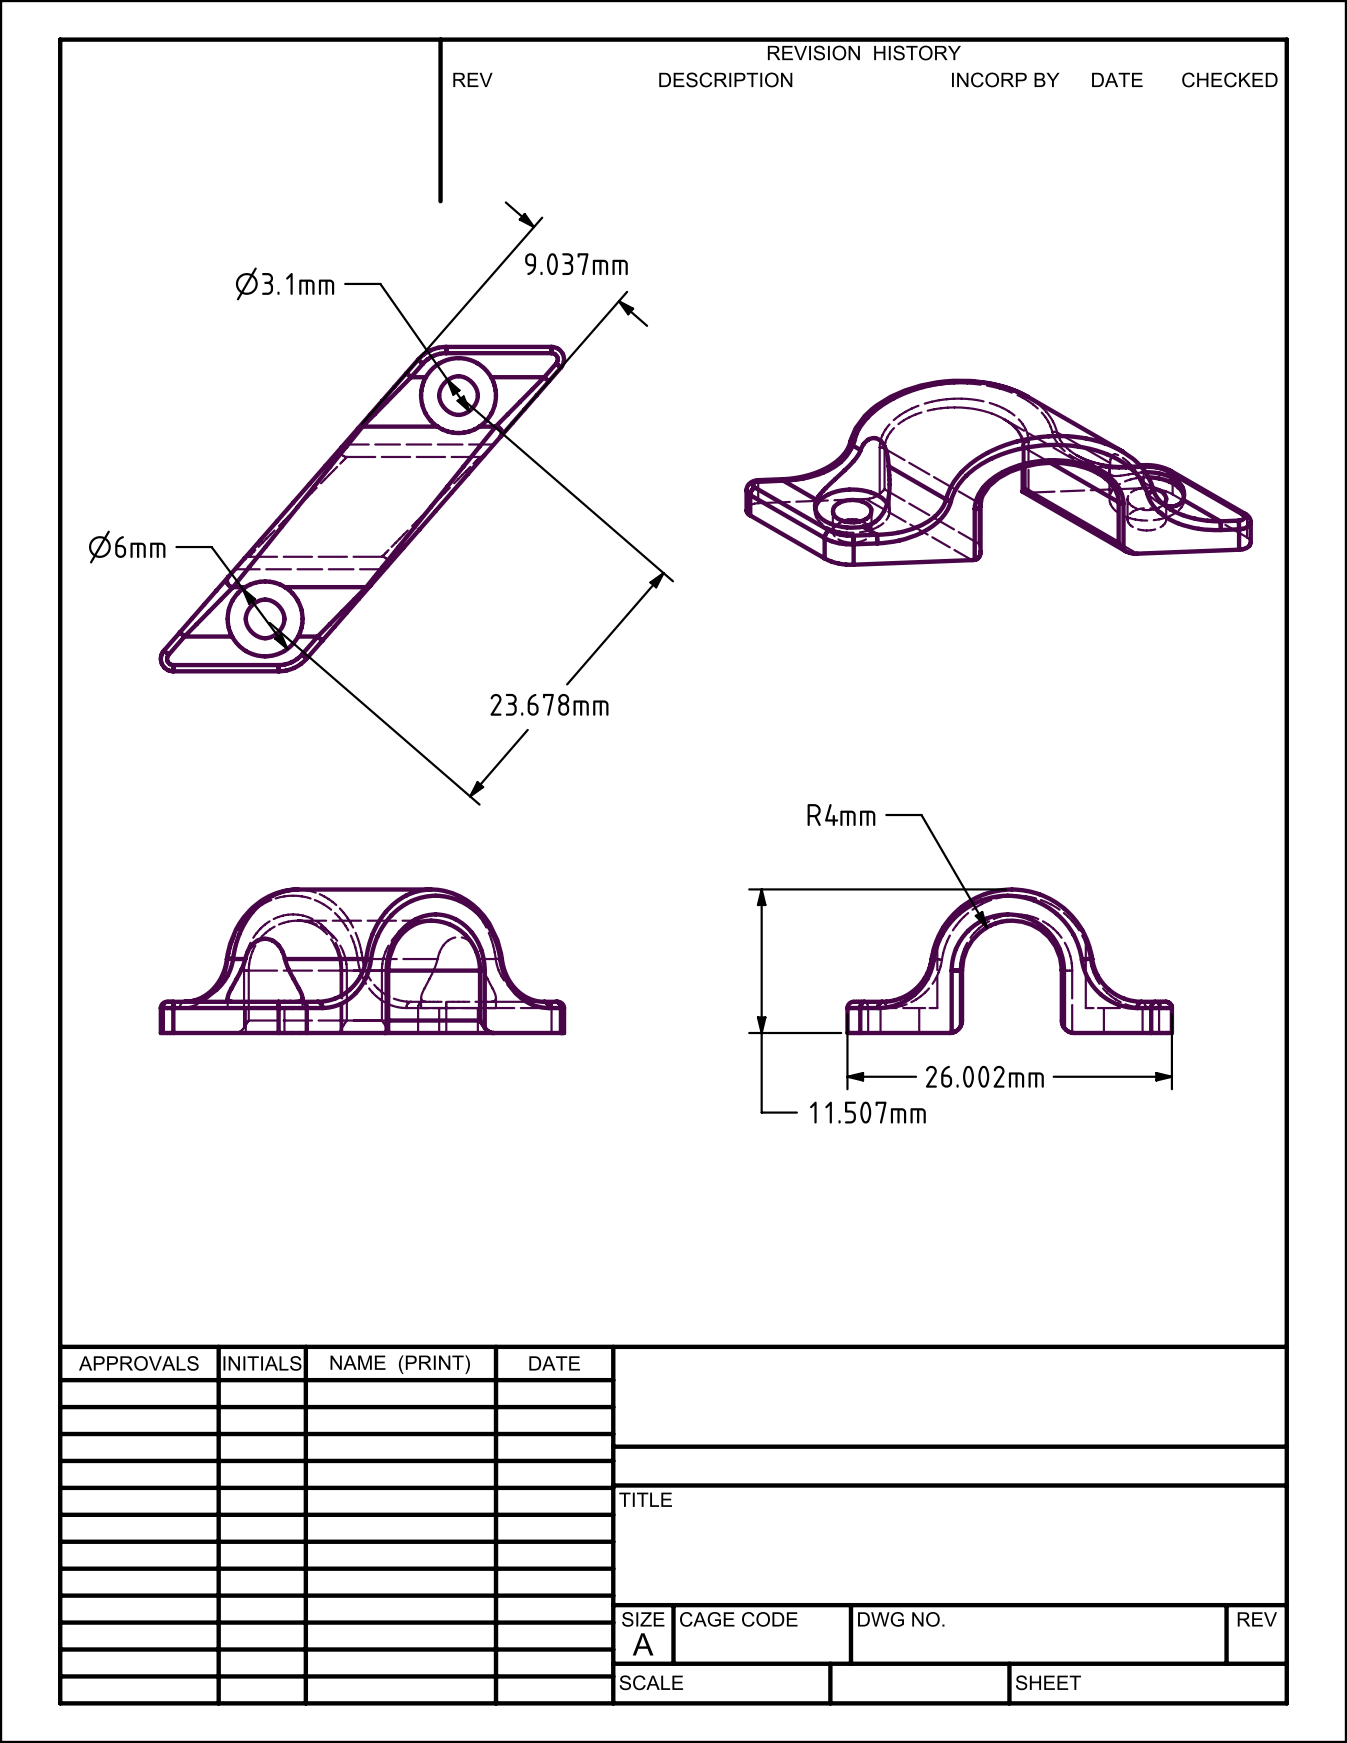
[picture p157: page 1]
