Ultimaker/Ultimaker2/1228_pritt_(x1)/B1228-Z1P-A.pdf

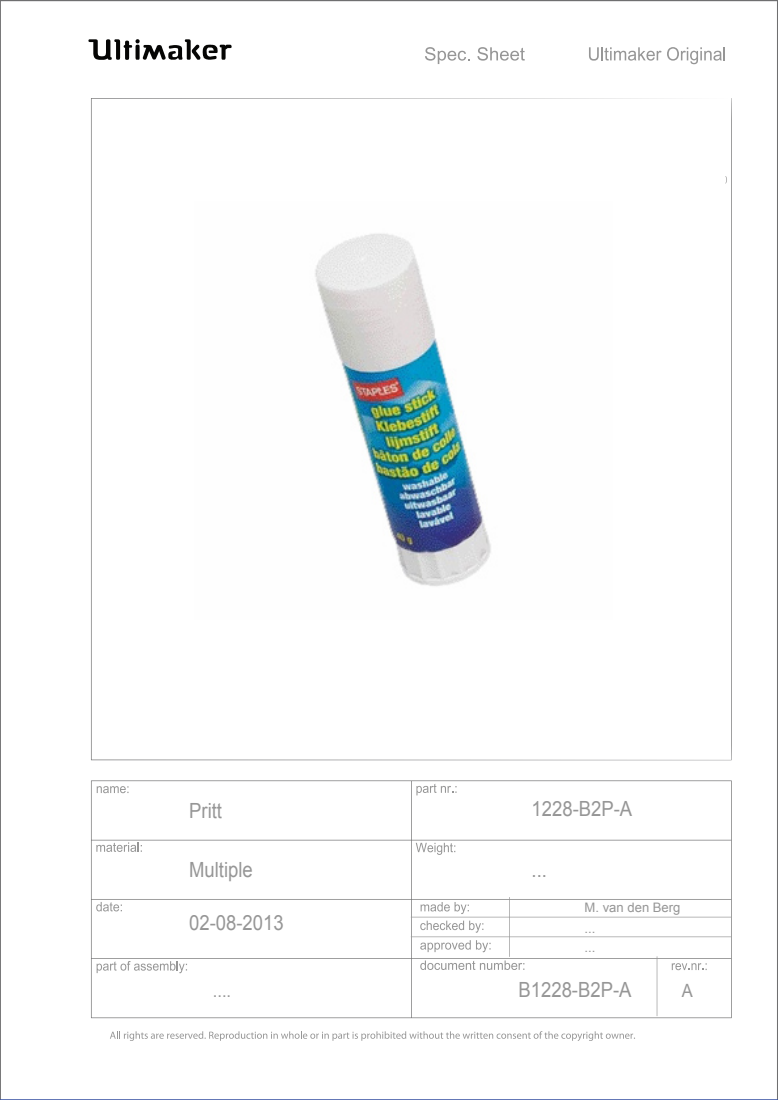
[picture p158: page 1]
Multiple; Pritt; B1228-ZzB2P-A; M. van den Berg ... ...
