Ultimaker/Ultimaker2/(list of files, drawings)

Other design files:
1546 ultimainboard V2.1.4/revisies.SchDoc
1546 ultimainboard V2.1.4/schema1.SchDoc
1546 ultimainboard V2.1.4/schema2.SchDoc
1546 ultimainboard V2.1.4/schema3.SchDoc
1546 ultimainboard V2.1.4/schema4.SchDoc
1546 ultimainboard V2.1.4/schema5.SchDoc
1546 ultimainboard V2.1.4/Ultimaker.PrjPcb
