Ultimaker/Ultimaker2/(commit log)

2014-02-12 parts feeder
    these are the parts that we use in the feeder.
    [1069-Z1P-A.STEP, 1143-Z1P-A.STEP, 1258-B2P-B.STEP, 1258-B2P-B.stl, 1259-B2P-B.STEP, 1259-B2P-B.stl, 1260-B2P-A.stl, 1260-B2P-B.STEP]
2014-03-19 revised feeder parts for testing
    These parts are intended for testing an upgrade of the feeder housing.
    The parts are redesigned so that the contact areas between the filament
    and the feeder housing are eliminated. The outsides of the housing parts
    are flat for easy printing.
    In order to test this revision you will need a metal ring that can be
    positioned in the filament inlet.
    [1258-B2P-D.STEP, 1259-B2P-D.STEP]
2014-03-27 Added _BOM
    [1069-Z1P-A.STEP, 1143-Z1P-A.STEP, 1258-B2P-B.STEP, 1258-B2P-B.stl, 1258-B2P-D.STEP, 1259-B2P-B.STEP, 1259-B2P-B.stl, 1259-B2P-D.STEP]
2014-03-27 Added $FILE
    [1011-A2P-A.STEP, Ultimaker2.csv]
2014-03-27 Added 1069_Tube_Coupling_Collet_(x2)
    [1069-Z1P-A.STEP]
2014-03-27 Added 1071_Clamp_Clip_(x2)
    [1071-Z1P-A.STEP]
2014-03-27 Added 1074_Print_Head_Thumb_screw_(x4)
    [1074-Z1P-A.STEP]
2014-03-27 Added 1144_USB_Cable_(x1)
    [1144-Z1P-A.STEP]
2014-03-27 Added 1152_Table_Spring_D2150_(x3)
    [1152-B2P-B.step]
2014-03-27 Added 1153_Print_Table_Base_Plate_(x1)
    [1153-B2P-B.step]
2014-03-27 Added 1154_Print_Table_Glass_(x1)
    [1154-B2P-A.step]
2014-03-27 Added 1155_Print_Table_Heated_Bed_(x1)
    [1155-B2P-B.step]
2014-03-27 Added 1156_Z-shaft_Cap_Bottom_(x2)
    [1156-B2P-A.step]
2014-03-27 Added 1157_Print_Table_Back_Cover_(x1)
    [1157-B2P-B.step]
2014-03-27 Added 1158_Reel_Holder_(x1)
    [1158-B2P-A.step]
2014-03-27 Added 1159_Z-Motor_with_Trapezoidal_Lead_Srew_(x1)
    [1159-B2P-D.step]
2014-03-27 Added 1161_LED_Strip_Cold_white_(x1)
    [1161-B2P-D.step]
2014-03-27 Added 1162_Limit_Switch,_Blue_Wire_(x1)
    [1162-Z1P-B.step]
2014-03-27 Added 1163_Limit_Switch,_Red_Wire_(x1)
    [1163-B2P-B.step]
2014-03-27 Added 1165_Timing_Pulley_5mm_Shaft_GT2_(x2)
    [1165-B2P-A.step]
2014-03-27 Added 1166_Timing_Pulley_8mm_Shaft_GT2_(x8)
    [1166-B2P-B.step]
2014-03-27 Added 1167_Timing_Pulley_Double_8mm_Shaft_GT2_(x1)
    [1167-B2P-A.step]
2014-03-27 Added 1168_Sliding_Block_Spring_(x4)
    [1168-B2P-B.step]
2014-03-27 Added 1169_Z-linear_Shaft_(x2)
    [1169-B2P-B.step]
2014-03-27 Added 1170_Square_Flanged_Linear_Bearing_LMK12LUU_(x2)
    [1170-B2P-B.step]
2014-03-27 Added 1176_Spacer_8.2x10x5_(x2)
    [1176-B1P-A.step]
2014-03-27 Added 1177_Spacer_8.2x10x10_(x5)
    [1177-B1P-A.step]
2014-03-27 Added 1178_Spacer_8.2x10x25_(x1)
    [1178-B1P-A.step]
2014-03-27 Added 1179_Feeder_Motor_(x1)
    [1179-B2P-A.step]
2014-03-27 Added 1182_X,Y_Motor_(x2)
    [1182-B2P-A.step]
2014-03-27 Added 1187_Trapezoidal_Lead_Nut_(x1)
    [1187-B2P-A.step]
2014-03-27 Added 1200_ISO_7380_M3x8_(x10)
    [1200-Z1P-A ISO 7380 M3x8.STEP]
2014-03-27 Added 1201_Washer_Large_M3_(x12)
    [1201-Z1P-A.STEP]
2014-03-27 Added 1202_ISO_7380_M3x10_(x15)
    [1202-Z1P-A.STEP]
2014-03-27 Added 1203_ISO_7380_M3x12_(x10)
    [1203-Z1P-A.STEP]
2014-03-27 Added 1204_ISO_7380_M3x16_(x41)
    [1204-Z1P-A.STEP]
2014-03-27 Added 1206_ISO_7380_M3x20_(x5)
    [1206-Z1P-A.STEP]
2014-03-27 Added 1207_ISO_7380_M3x25_(x12)
    [1207-Z1P-A.STEP]
2014-03-27 Added 1208_ISO_7380_M3x30_(x4)
    [1208-Z1P-A.STEP]
2014-03-27 Added 1209_Nut_M3_(x1)
    [1209-Z1P-A.STEP]
2014-03-27 Added 1211_Set_Screw_M4x4_(x12)
    [1211-Z1P-A.STEP]
2014-03-27 Added 1212_Set_Screw_M3x3_(x1)
    [1212-Z1P-A.STEP]
2014-03-27 Added 1213_DIN_962_Square_Nut_M3_A2_(x37)
    [1213-Z1P-A.step]
2014-03-27 Added 1214_ISO_7040_Nut_M3_Prev._torque_A2_(x15)
    [1214-Z1P-A.step]
2014-03-27 Added 1215_ISO_10642_M3x8_A2_(x4)
    [1215-Z1P-A.step]
2014-03-27 Added 1216_ISO_10642_M3x20_A2_(x3)
    [1216-Z1P-A.step]
2014-03-27 Added 1217_ISO_10642_M4x10_A2_(x8)
    [1217-Z1P-A.step]
2014-03-27 Added 1220_Ball_Bearing_F688-2RS_(x8)
    [1220-Z1P-A.step]
2014-03-27 Added 1226_grease_(x1)
    [1226-Z1P-A.STEP]
2014-03-27 Added 1230_Front_Panel_(x1)
    [1230-B2P-B.STEP]
2014-03-27 Added 1231_Back_Panel_(x1)
    [1231-B2P-B.STEP]
2014-03-27 Added 1232_Left_Panel_(x1)
    [1232-B2P-B.STEP]
2014-03-27 Added 1233_Right_Panel_(x1)
    [1233-B2P-B.STEP]
2014-03-27 Added 1234_Bottom_Panel_(x1)
    [1234-B2P-D.STEP]
2014-03-27 Added 1235_Top_Panel_(x1)
    [1235-B2P-B.STEP]
2014-03-27 Added 1240_Main_Board_Electronics_Cover_(x1)
    [1240-B2P-B.STEP]
2014-03-27 Added 1241_Motor_Spacer_(x2)
    [1241-B2P-B.STEP]
2014-03-27 Added 1243_Heated_Bed_Cable_Clip_(x1)
    [1243-B2P-B.STEP]
2014-03-27 Added 1244_Knob_Front_(x1)
    [1244-B2P-A.step]
2014-03-27 Added 1245_Knob_Housing_(x1)
    [1245-B2P-A.step]
2014-03-27 Added 1247_Display_(x1)
    [1247-B2P-A.step]
2014-03-27 Added 1248_SD_card_(x1)
    [1248-Z1P-A SD card.STEP]
2014-03-27 Added 1249_Ulticontroller_Board_(x1)
    [1249-B2P-A.step]
2014-03-27 Added 1251_Ulticontroller_Electronics_Cover_(x1)
    [1251-B2P-A.step]
2014-03-27 Added 1254_Print_Table_Mounting_Aid_(x3)
    [1254-B2P-B.STEP]
2014-03-27 Added 1255_Sliding_Block_(x8)
    [1255-B2P-A.step]
2014-03-27 Added 1256_Build_Platform_Glass_Retainer_Back_(x4)
    [1256-B2P-A.step]
2014-03-27 Added 1257_Knurled_Nut_Platform_(x3)
    [1257-B2P-B.STEP]
2014-03-27 Added 1258_Feeder_Part_A_(x1)
    [1258-B2P-C.STEP]
2014-03-27 Added 1259_Feeder_Part_B_(x1)
    [1259-B2P-C.STEP]
2014-03-27 Added 1260_Feeder_Lever_A_(x1)
    [1260-B2P-B.STEP]
2014-03-27 Added 1261_Feeder_Lever_B_(x1)
    [1261-B2P-B.STEP]
2014-03-27 Added 1263_Feeder_Knurled_Wheel_(x1)
    [1263-B2P-A Feeder Knurled Wheel.STEP]
2014-03-27 Added 1264_Feeder_Nut_Holder_(x1)
    [1264-B2P-C .STEP]
2014-03-27 Added 1266_Bowden_tube_(x1)
    [1266-Z2P-B.STEP]
2014-03-27 Added 1268_Heater_Cartridge_24V_25W_(x1)
    [1268-Z1P-A.step]
2014-03-27 Added 1269_Power_Cable_EU_Type_C13_(x1)
    [1269-Z1P-A.step]
2014-03-27 Added 1270_Power_Cable_UK_Type_C13_(x1)
    [1270-Z1P-A.STEP]
2014-03-27 Added 1271_Power_Cable_AU_Type_C13_(x1)
    [1271-Z1P-A.STEP]
2014-03-27 Added 1272_Power_Cable_US_Type_C13_(x1)
    [1272-Z1P-A.STEP]
2014-03-27 Added 1273_Cable_Cover_(x2)
    [1273-B2P-C.STEP]
2014-03-27 Added 1281_Braided_Sleeve_Clip_(x5)
    [1281-B2P-C.STEP]
2014-03-27 Added 1287_Washer_M7_(x1)
    [1287-Z1P-A.STEP]
2014-03-27 Added 1290_Filament_guide_(x1)
    [1290-B2P-B.STEP]
2014-03-27 Added 1301_Integrated_nozzle_heater_block_3mm_filament_(x1)
    [1301-Z2P-D integrated nozzle 3mm.STEP]
2014-03-27 Added 1306_Hot_end_holder_bottom_(x1)
    [1306-Z2P-B hot end holder bottom.STEP]
2014-03-27 Added 1307_Hot_end_holder_top_(x1)
    [1307-Z2P-B Hot End Holder Top.STEP]
2014-03-27 Added 1308_Cooling_Rib_Hot_End_(x1)
    [1308-Z2P-B Cooling Rib Hot End.STEP]
2014-03-27 Added 1309_PTFE_Isolator_Coupler_3.2_mm_(x1)
    [1309-Z2P-B Hot End Isolator Coupler.STEP]
2014-03-27 Added 1310_Hot_end_Isolator_(x1)
    [1310-Z2P-A Hot end Isolator.STEP]
2014-03-27 Added 1313_Model_Cooling_Fan_12VDC_0.1_A_(x2)
    [1313-Z1P-A.STEP]
2014-03-27 Added 1315_Jumper_(x2)
    [1315-Z1P-A.STEP]
2014-03-27 Added 1320_Print_Head_Top_(x1)
    [1320-B2P-B.STEP]
2014-03-27 Added 1321_Print_Head_Middle_(x1)
    [1321-B2P-B.STEP]
2014-03-27 Added 1322_Print_Head_Bottom_(x1)
    [1322-B2P-C.STEP]
2014-03-27 Added 1329_Dual_fan_bracket_(x1)
    [1329-B2P-C.STEP]
2014-03-27 Added 1330_Hot-end_Cooling_Fan_5VDC_0.08A_(x1)
    [1330-Z1P-B.STEP]
2014-03-27 Added 1348_ISO_7380_M3x4_A2_(x4)
    [1348-B2P-A.step]
2014-03-27 Added 1351_ISO_4762_M2,5x10_(x2)
    [1351-B2P-A.step]
2014-03-27 Added 1352_Set_Screw_M3x14_(x1)
    [1352-B2P-A.step]
2014-03-27 Added 1354_ISO_724_Hex_nut_M7_(x1)
    [1354-Z1P-A.STEP]
2014-03-27 Added 1400_Hex_Key_Wrench_1.5_(x1)
    [1400-Z1P-A.step]
2014-03-27 Added 1401_Hex_Key_Wrench_2_(x1)
    [1401-Z1P-A.STEP]
2014-03-27 Added 1402_Hex_Key_Wrench_2.5_(x1)
    [1402-Z1P-A.STEP]
2014-03-28 Add PDF of bom.
2014-04-07 Added head assembly (without screws) for #3
    [HeadAssembly.step]
2014-04-08 assembly manual V1.1
2014-04-08 Assembly Ultimaker2 stepfile
2014-04-08 BOM and Assembly step files
    [Ultimaker2.csv]
2015-04-30 electronic files added
    added electronic files
    [border.gbr, drill.gbr, drillmap.gbr, rout.gbr, top.gbr, topmask.gbr, toppaste.gbr, topsilk.gbr]
2015-07-03 1546 Ultimainboard V2.1.4
    The Ultimainboard V2.1.1 has been replaced by the Ultimainboard V2.1.4
    [Ultimaker.PrjPcb, revisies.SchDoc, schema1.SchDoc, schema2.SchDoc, schema3.SchDoc, schema4.SchDoc, schema5.SchDoc]
2016-01-04 update files 1320 print head fan
    [1320-B2P-B.STEP, 1330-C.STEP]
2016-08-16 update files print 1320 print head top
    [1320-D.STEP, 1330-C.STEP]
